zsw151515/Automotive-telemetry-equipment/hardware/wired_tire_central/README.md

2026-10-24 六口离线增量：7B套件＋六接口底板，四胎温C3＋双前刹车第五C3；三页触屏、独立蜂鸣/设置/BLE。实现与验证范围见 docs/12_四路有线胎温离线软件交付说明.md，接口见 docs/13_六接口中控板间与刹车接口.md。未实物验证，原v3/MAX31856/独立刹车固件不变。

# 四路有线胎温中控硬件

状态：设计验证阶段，当前有离线软件、长方形外壳试装模型及验证记录；电子部分未提供制造文件，没有已验证原理图、PCB、BOM 或 Gerber。

当前结构：微雪 7B 完整显示套件＋六接口采集底板，同一外壳。四接口接胎温，另两接口接前刹车盘温度；刹车采集/报警/BLE 并入底板，保留蜂鸣，触屏替代小屏与设置键。工程基线为四胎温 C3＋第五双路刹车 C3、六路 RS485 和支路保护，刹车两总线独立；具体引脚、供电和器件尚未核准。详见 `docs/superpowers/specs/2026-10-24-six-port-tire-brake-7b-design.md`。胎温前轮约 2 m、后轮约 4.5 m，刹车线束待确认；随点火自动工作和关闭。

不能用未核准的 -1 引脚、默认辅助字段或 PanelConfig 生成接线施工图。notes 下记录工具链、引脚/面板选型状态以及各硬件关卡，不把未执行事项写成通过。

本次计划为 `docs/superpowers/plans/2026-10-24-six-port-tire-brake-central.md`，目前仅计划/资料审查；关键引脚和依赖证据见 `notes/7b_source_audit.md`。默认SPI32/33与屏冲突；排除绑带34/36及VO4域46–48后只有12脚，13信号方案必须另核准相关电气条件。

最终定版前取得：胎温协议/帧率、两前刹车协议和独立线路、单轮/四轮胎温及刹车 BLE、五设备共存、后台报警、设置回执与掉电保存、板间 SPI、实际触屏及电源预算证据。屏幕背板、套件 P4/C6 和五个 C3 的维护/天线、USB防反灌及六支路保护均纳入审查。原四口测试不代表上述集成验证已完成。

首版工程样机可以提前设计、试制和装配，无须等所有探头和整机测试完成。底板打样前仍须完成相应电气、引脚、器件和接口定义审查；当前13信号方案尚未闭合，不把预布局当可下单终版。外壳可先按官方图纸做可修改的结构样件，实板到货后复核装配。具体顺序见 [先做中控工程样机](notes/prototype_sequence.md)。

长方形试装外壳已建立参数化模型、STL及装配预览，默认190×125×60 mm；底板和连接器采用明确标注的空间占位，尚未实板试装。打印数量、参数及后续复核见 [外壳试装模型](enclosure/README.md)。

六接口底板交付格式已选嘉立创EDA专业版；官方技能、API Gateway及CLI/MCP的接入核对见 [EDA自动化工具记录](notes/eda_tooling.md)。当前仅完成桥接准备，尚未连通EDA客户端或生成原理图/PCB。
