zsw151515/Automotive-telemetry-equipment/docs/superpowers/plans/2026-10-24-six-port-baseboard-hardware.md

# 六接口底板工程样机实施计划

> **For agentic workers:** 使用 superpowers:executing-plans，保留用户选择的原生执行；独立研究及最后审查可委派只读代理。步骤以核对项追踪。

**Goal:** 交付可继续编辑的嘉立创EDA专业版底板工程、选型与引脚表、可复核原理图和PCB布局，完成相应范围审查后准备少量样板资料。

**Architecture:** 四胎温C3＋双刹车S3，六独立RS485；7B只持有显示与触屏。READY选择器和三态缓冲解决P4信号预算及复位隔离；电源、支路和射频单独核查。

**Tech Stack:** 嘉立创EDA 3.2.149官方API Gateway、本机Node/Python；原厂数据手册、原生工程/网表/规则检查。

**Spec:** `docs/superpowers/specs/2026-10-24-six-port-baseboard-hardware-design.md`。

## Global Constraints

- 不改旧固件、RaceChrono轮位/UUID/数据布局；硬件引脚从未核准的-1记录为本次设计候选。
- 不覆盖其他EDA工程，不修改安装文件或跳过扩展权限；每次写入校验工程UUID及文档类型。
- 所有实物关卡保持未执行，制造与下单前完成对应电气/封装审查；不替用户下单或付款。

## Review Focus

- 复位、单桥重启、USB维护和慢掉电时的三态、DE/ARM及反灌。
- 模块引脚号与实际封装焊盘一一对应，含重复地焊盘和NC。
- P4启动/JTAG/电压域，READY切换延迟与DMA就绪语义。
- 12V正负瞬态、支路短路、屏幕启动及密闭温升。
- RF全铜层禁布、连接器外形及原理图/PCB网表一致性。

### Task 1：选型和引脚

- [x] 原厂资料与器件库交叉核对，保存来源和真实UUID/封装；创建 `hardware/wired_tire_central/baseboard/parts.json`、`pinmap.csv`、`README.md`。初版选型；具体未闭合封装项见审查记录。
- [x] 记录模块GPIO、模块焊盘、7B排针、硬件默认电平及旧-1到候选分配。
- [x] 校核电源预算、保护设置与器件限值，未闭合项写入审查记录，不能标已放行。

### Task 2：原理图

- [x] 在独立工程按控制器、板间链路、六RS485、电源分图；以读回引脚坐标接线。
- [x] 导出原生工程、完整图纸及网表到 `hardware/wired_tire_central/baseboard/eda/`、`exports/`。12页初版；标注整理仍在进行。
- [x] 对网表做独立连接断言，并执行真实原理图检查，记录尚未完成的功能和错误。282器件/1036已定义引脚网络通过，固件适配及实物验收未执行。

### Task 3：PCB与审查

- [x] 从同板原理图导入PCB，设置轮廓、安装孔、四层和天线规则，按器件外形安排布局；导出布局预览和尺寸证据。282器件、1170焊盘读回核对；闭合板框及铜区经导出和重开验证。
- [x] 建立主供电骨架、地线扇出和首轮信号布线检查点；保留已布关键铜线，更新后盖与连接器坐标投影。原生文件2796个走线片段；真实DRC仍有234项连接提示，未放行制造。
- [x] 补充3V3分配、探头供电、九处地线及部分电源控制线；当前原生文件3550段走线/577个板上过孔，真实DRC降至82项连接提示。三处新增焊盘过孔的填孔/铜盖要求已记录；USB及剩余主保护网络仍未闭合。
- [x] 局部调整C52、VS旁路及Kelvin支线，补齐主保护控制并恢复受影响信号；补S3热焊盘接地。当前3775段走线/600个板上过孔，真实DRC为49项连接提示；保护基线的三条替换已明确留证。
- [x] 重新布置左侧四个小元件，完成U31六引脚扇出及逻辑供电/地焊盘过孔；实际3912段走线/616个板上过孔，DRC降至31项连接提示，3V3/GND已无连接错误。受影响信号恢复和保护基线修订3/4已留证。
- [x] 调整R3/R5并恢复受影响SPI线路；实际3975段走线/623个板上过孔，保存重开DRC降至27项连接提示。3V3/GND/SPI无连接错误，修订5记录母线局部缩颈，仍未放行制造。
- [x] 补齐D2/D3/C54钳位支路及FR探头输出，实际3990段API走线/647个板上过孔；DRC只剩五组USB差分对的20项连接提示。保护基线修订6记录原母线拆分，未制造放行。
- [x] 左前USB增加33Ω串联电阻与DNP调试电容预留，局部源端和接地已布通；286器件/1178焊盘，旧铜线保留，该RC检查点22项USB连接提示。
- [ ] 电源/射频关键网络按原厂指引布置；未完成布线时不得输出为可投板版。
- [ ] 审查网络、间隙、供电/反灌、支路故障、实板接口；导出真实DRC与开放事项。
- [ ] 仅对已满足相应制造前置条件的版本准备少量样板包；数量、工艺、报价及最终订单交用户确认，实物验收另记。

- [x] 左前完整USB顶层差分对写入原生PCB；J11原地旋转180°且针脚定义不变，八个受影响信号网络恢复，重建参考地与保存重开DRC通过。实际4217段API线、668个板孔，剩余四组USB共16项连接提示。其他四路RC/USB、制造阻抗和实测仍待完成。

- [x] 右前USB增加33Ω串阻及DNP电容，R84局部重排并恢复HOST_MOSI/FR_ARM/FR_POWER_EN；原生290器件/1186焊盘、4242线/670板孔。保存重开18项提示均为剩余四组USB；新增两项来自DNP焊盘，右前完整差分尚未完成。

- [x] 右前完整USB顶层差分对完成；J12移至底面(71,68,180°)，针脚定义保持，旧EN/BOOT末端清理并恢复八组普通信号。实际4362段API线、680板孔，保存重开仅余RL/RR/BRAKE六网12项提示。未制造放行。

- [x] 左后33Ω串阻/DNP电容与完整USB顶层差分完成；J13移至底面(105.25,68,180°)，恢复八组普通信号并清理旧MOSI/EN/BOOT支路。294器件/1194焊盘、4496段API线/687板孔；保存重开仅RR/BRAKE四USB网8项连接提示。Inner1地参考覆盖已核；制造阻抗与实测未放行。
