zsw151515/Automotive-telemetry-equipment/hardware/wired_tire_central/baseboard/review.md

# V0.1 设计与审查状态

最后更新：2026-10-27。此文件以已取得的证据记录阶段，不以API返回成功替代电气和实物检查。原理图、布局、布线、制造放行分别记录。

| 阶段 | 当前状态 | 证据/限制 |
|---|---|---|
| 官方工具连接 | 已完成 | 用户启用Run API Gateway；显式指定已拥有的连接会话，独立工程读写与导出已验证 |
| 器件选型/GPIO候选 | 已建立 | `parts.json`、`pinmap.csv`、`power-design.md`；实物未核准 |
| 实际符号引脚 | 已读回 | 294个器件、1152个符号引脚，逐一核对模型中用到的引脚；完整证据见导出目录 |
| 原理图连接 | 初版已核对 | 12页、294器件、1060个已定义引脚网络与实际网表一致；严格检查接口返回空错误列表。图纸标注仍需整理 |
| PCB布局 | 初版已建立 | 关联导入294器件；四层、150×75mm闭合板框、4安装孔和RF规则；读回1194实体焊盘网络及位置与模型一致 |
| 原生文件保存 | 已核对 | `.epro2`与`.epro`均有294器件、一个闭合板框、两个地铜区；保存后重开PCB，两个铜区及填充仍在 |
| PCB布线/DRC | 部分完成 | 4496个API走线片段、687个板孔及12模块孔。左前/右前/左后USB闭合；右后/刹车四个USB网络共8项连接提示，无其他类别 |
| 前轮检查点独立复核 | 59c861b已通过 | 见`exports/local-checkpoint-review.md`；仅覆盖49项连接提示时的局部调整 |
| 上一供电检查点独立复核 | 已通过 | 见`exports/supply-checkpoint-review.md`；31项连接提示，未制造放行 |
| 外壳装配 | 投影已更新，实物未验证 | 六探头及电源孔位已关联实际PCB；增加试装窗口后盖，5个STL均通过闭合检查。未收到7B及探头 |
| 少量样板 | 未放行 | 先完成布线、封装、电源和制造检查；尚未下单付款 |

## 已在连接前修正的审查项

1. TI SN74LVC125A数据表未给出所需Ioff保证，本地缓冲改为Nexperia 74LVC125APW,118；不能按相似料名混用厂家。
2. 单侧供电缓冲加跨域上拉仍可能反灌，板间接口改为双电源AXC8+AXC4；P4_3V3_REF与底板3V3分开，CS两侧各归本域，/OE由底板3V3 PG开漏使能。
3. S3故障输入避开GPIO18的启动高毛刺，使用GPIO1/pad39与GPIO2/pad38；C3 RX10串1k，DE7与ARM20采用默认关断。
4. SS54库符号1=A、2=K，修正D3负压钳位和D4蜂鸣反向二极管的极性。
5. LM74900的SLEEP_OV接VS采用切断；补VS和A的100nF去耦；RTN裸焊盘保持悬空。
6. CSD17578Q5A库额外的pad9为漏极散热焊盘，接5V_SCREEN；LMR33630和TPS热焊盘接GND。
7. TPS MCU控制支路增加4.7k串阻；RO串1k；120Ω终端及390Ω偏置初始DNP。
8. A4标题栏预留；网络名与元件引脚文字分开，避免双重标签重叠。
9. 六个Micro-Fit 430450427的四个电气孔和两个定位孔按原厂图修正为1.02mm，保持本工程封装UUID、器件关联和焊盘网络。
10. S3库内12个过孔原无地网络，且不满足当前孔径规则；保持原分块散热焊盘和孔位，修正为GND、0.30mm孔/0.50mm外径。未放宽规则来隐藏错误。
11. 降压芯片旋转使SW朝向电感，BOOT、VCC、输入陶瓷及输出电容优先布置；主保护器去耦和HGATE dv/dt支路移至本地。普通信号尚未布通。
12. 板框改为真正的闭合折线对象；真实DSN和布线几何已成功导出。四条普通走线放在板框层不足以证明存在可导出的轮廓。
13. 主电源骨架、采样Kelvin支线、12V母线、5V屏幕支路及3V3内层母线已布置；七个供电网络的最大线宽单独设为4mm。原理图和PCB规则一致，其余制造规则保持原值。
14. 信号候选先按真实焊盘、原有铜线、过孔、孔边和RF区筛查，再写入PCB；7处自动缩颈低于0.127mm的候选改为0.128mm并复核。已有458条电源/地走线和277个板上过孔经原生文件对比保留。
15. 底面连接器采用局部Y取反的变换，已用26个实体焊盘坐标独立验证。定位孔模型及后盖投影同步修正；FL_DE_CMD在输入定位孔附近的两段逻辑线改为0.128mm并外移0.025mm，真实间距检查通过。
16. 补充3V3分配、六路探头供电的部分走线、九处局部地线和部分电源控制网络；新增754段走线/65个板上过孔。未连接提示由234项降至82项，原有关键铜线基线仍通过检查。不能据此宣称六路供电均已闭合。
17. 检查中发现U1原理图Unique ID变为gge283，而PCB仍为gge1；仅恢复对应标识，保留器件属性及引脚连接。导出完整网表与前一检查点结构完全一致，网表不一致提示消失；该变化的触发来源未确认。
18. R17.1、R32.1、U25.7采用新增0.30/0.60mm焊盘过孔；坐标及实际对象ID见`exports/power-routing-check.json`。制造审查必须落实塞孔和铜盖要求，未按普通盖油工艺放行。
19. C52上移0.8mm，替换三段局部电源走线并恢复READY_FL和FL_TX两段信号；主保护栅极、采样、限流及相关供电连接已补齐。旧基线中455条线和277个板过孔保留；三条旧线的原始几何及12条替换线、4个新增过孔明确记录于`protected-copper-revision.json`，当前保护基线为467条线/281个板过孔。
20. R124.1至R119.1采用独立Kelvin支线；C55.1新增焊盘过孔需要填孔/铜盖审查。S3三个热焊盘跨接经编辑器分成六段，地连接提示随之减少。当前共49项连接提示，后续密集供电/地线试验未应用。
21. R120移至(6.9,50.25)、R121至(4,50.25)、R123至(3,53.25)、C56至(6,53.4)，保持型号、值、旋转和引脚映射。U31六引脚完整扇出，相关供电、UVLO/UV_SW/OVLO、栅极及定时网络全部恢复；两处电压检测连接提示消失。替换范围与保护基线变化见修订3。
22. R29.1、R31.1、U13.14、R35.2、C23.2增加五个填孔/铜盖焊盘过孔；四条受影响线路已完整恢复。3V3母线两处地孔分别采用双0.8mm支路绕行，其他段3mm。编辑器自动清理被覆盖的旧母线段，并替换旧RL_TX段`3c01f7c51d3b6708`及新RL_TX片段ID；旧段铜几何保留，全部实际铜线并集与计划差异小于0.001mm²。保护基线修订4明确留证，当前31项连接提示，无其他DRC类别。

阶段检查证据见 `exports/netlist-check.json`、`pcb-connectivity-check.json`、`native-integrity-check.json` 和 `pcb-drc-summary.json`。这些文件各有明确检查范围，不合并称为整板通过。

## 制造放行前必须闭合

- 所有PCB焊盘网名与最终原理图一致，NC/浮置裸焊盘处理正确，未连接飞线清零；实际ERC/DRC及人工审查结果留存。
- 精确库封装对原厂封装图复核，含模块重复地焊盘、MOS散热焊盘、Micro-Fit定位柱/焊盘及对接端子；目录料名和3D模型不能替代尺寸证明。
- 双电源接口不同上电顺序与棕断波形、DE/ARM默认低及共享MISO三态；P4 GPIO2–5保持默认USB JTAG配置，不切换为pad JTAG。
- 主保护过流/浪涌能量、100V MOS SOA、负压钳位对降压器−0.3V限值的裕量，以及电容DC偏压降容尚需完整校核。TVS通用系列数据不能替代实际采购厂家数据。
- 两路降压的热点、最短高频环路、Kelvin采样、开关节点净空、屏幕启动负载和密闭温升。整机温度等级不能按单个H4X模块105°C定义。
- 天线全铜层与金属背板净空，四C3、S3与7B无线模块共存；实板RF性能尚未验证。
- 7B实际板卡修订、P1/P3正反视图、供电USB口与PC VBUS的路径；专用屏幕电源线束和六路探头适配线定义。
- 新接口位置对应外壳后盖；不把旧φ3导孔或屏幕官方尺寸当成实际装配通过。
- 完成剩余两组RC预留及USB差分对；当前8项连接提示尚未清零。制造阻抗、负载温升、接口和车辆实测尚待验证。
- 为S3及降压散热过孔定义锡膏、盖油与填孔工艺。盖油不能等同填孔；不能在未确定工艺时把过孔在焊盘内的版本作为普通板直接下单。
- 继续整理MOS重复引脚网络标注、显示接口页及TVS附近文字，检查完整PDF的可读性。

## 硬件到货后的验证顺序

先限流电源检查12V→保护母线→5V/3V3，空载确认所有探头支路关闭与DE低；逐支路加入假负载和短路，检查自动重试、温升及故障输入。随后分别启动屏幕/底板、重置单MCU、慢降压并测反灌。最后接真实探头检查完整热图、六路并行读取、蜂鸣报警、五路BLE与RaceChrono记录。车载瞬态和振动测试在台架正常后开展。

本阶段未修改旧固件和任何RaceChrono帧定义，也未启用Approved硬件profile。S3移植、READY选择及ARM的实际启动顺序另行开发；不能直接套用现有C3二进制。

## SPI检查点（2026-10-26）

R3、R5局部调整及全部受影响信号恢复已写入原生PCB。保存重开DRC由31降至27项，均为连接提示；12组剩余网络为12V_PROTECTED、FR_VPROBE及五组USB差分对。未更改元件值、GPIO、网表或DRC规则。R4.2新增焊盘过孔及R5.1既有过孔必须填孔/铜盖；新2mm母线缩颈尚待层叠、负载和温升核对。

原生编辑器将2mm母线连接段的中心自动对齐至Y62.3mm，实际几何已重新通过0.16mm铜间距检查，MISO过孔至该段铜边的名义间距约0.25mm。旧CS_FL和HOST_MOSI片段ID在编辑器清理中变化，铜几何通过全网逐层并集复核。详细证据见`exports/spi-checkpoint-check.json`；当前阶段尚未进行新的独立整板审查，不能投板。

`.epro2`中有一个约0.0016mm的HOST_MOSI极短片段，API读取为空，`.epro`不计入；两格式分别3976/3975条线。现代原生文件与API走线铜几何的最大逐层逐网并集差为0.000003321mm²，低于0.001mm²容差。此差异已在报告中保留，不以手工改写原生压缩包消除计数。

## 钳位与FR输出检查点（2026-10-26）

12V_PROTECTED与FR_VPROBE连接提示已消除，保存重开后只剩十个USB网络、20项连接提示，无其他DRC类别。钳位支路新增22个0.30/0.60mm过孔及三条1.5/1.5/2mm内层支路；FR输出新增U26.7焊盘过孔及一个转换过孔，采用0.3/0.4/0.6mm路径宽度。焊盘过孔均要求填孔和铜盖。并联孔数不代表已取得脉冲电流额定值，仍须核对瞬态路径、厂商层叠和温升。

此次只增加铜线，旧12V母线在三个T形连接处被编辑器拆分成四段，原铜几何保留；修订6记录替换对象。全网逐层铜几何并集最大差0.000020638mm²，低于0.001mm²检查容差。`.epro`/API共3990条线，`.epro2`共3991条，仍包含上一检查点记录的极短MOSA片段，已重新核对铜几何。当前检查点尚未进行新的独立整板审查，未制造放行。

## USB预留初步检查点（2026-10-26）

仅左前路加入R134/R135串联33Ω、C76/C77预留10pF并默认不装；串联路径的实际网表检查已从失败变为通过，原理图ERC为空。增量导入只增加四件并拆分U1.26/27的USB源端网络，原有器件坐标、GPIO和全部既有铜线保持一致。两段局部源端线和电容接地已完成，该RC检查点整组USB仍未闭合。当时22项连接提示均为USB，多出的两项来自新增电容信号焊盘，并非已完成供电/SPI断开。完整差分路径、调谐参数与制造阻抗均未验证。

四个新器件的BOM标记已同时在原理图和PCB核对：电阻装配，电容不装。预留选型及旧/新源端网络名见`usb-design.md`；其余四路RC预留仍待完成。当前阶段不进行新的独立整板放行判断。

## 2026-10-26 左前USB完整路径检查点

J11原地旋转180°，针脚编号、GPIO及原理图网表未变。左前USB两条顶层路径各约82.66465mm，主干采用0.16mm线宽/0.16mm间距，未使用USB信号换层孔；实际重建Inner1地覆盖完整差分主干。精确移除18条普通信号线、2个普通过孔后恢复八个受影响网络，FR限流及两条短SPI输出扇出保留。625条受保护线和324个受保护板孔未改变。U26.3新增焊盘过孔必须填孔/铜盖。

保存重开后16项提示只属于FR/RL/RR/BRAKE的八个USB网络；独立铜几何比较、实际新增铜的间距与孔距检查通过。`.epro2`多出的两个极短同网片段已量化，未手工改写原生档。90Ω阻抗、维护线束、USB枚举、SPI时序及车辆实测尚未验证；不能制造放行。详见`exports/usb-fl-route-check.json`。

## 2026-10-26 右前USB RC及局部布局检查点

新增R136/R137（33Ω装配）及C78/C79（10pF C0G默认不装），U2.26/27拆分为FR_USB_DM_MCU/FR_USB_DP_MCU；GPIO及J12针脚定义保持。R84由(62.25,66,90°)移至(64,62.25,0°)，释放源端引出位置。精确替换12条普通信号线，HOST_MOSI、FR_ARM和FR_POWER_EN全部恢复，未移除旧过孔或受保护铜。新增37段线、2个地孔；两段USB局部源端各约1.51248mm，不代表完整差分匹配。

保存重开18项提示仅来自FR/RL/RR/BRAKE八个USB网络；较上一检查点多两处DNP信号焊盘。原理图及PCB逐件、原生保存、机械变换和FL/FR RC网表核对通过，现有FL差分主干保留。保护基线修订8为627条线/326个板孔。当前阶段尚无独立整板放行结论；详见`exports/usb-fr-rc-check.json`。

## 2026-10-27 右前完整USB及维护排针近端布局

J12由底面(54,40.5,0°)改到(71,68,180°)，所有针脚编号和网络保持；其他器件保持。右前完整USB两线各约16.566mm，采用顶层0.16mm线宽/间隙且无USB信号过孔，重建Inner1地覆盖0.48mm耦合主干。DP源端在非耦合区补长，CAD长度差小于0.001mm，不能作为制造精度或90Ω证明。

精确替换24条普通线、无旧过孔；其中清理旧排针EN/BOOT的Bottom末端分支，保留MCU/上拉/滤波局部连接和源端过孔。八个受影响信号恢复，新增复位/启动接线约21.26/8.22mm。155次铜操作中两段共线DP被编辑器合并，实际新增144线/10孔，旧保护铜627线/326板孔保持。实际新增铜间距/孔距/RF检查及全铜并集比较通过。保存重开DRC只剩其余三组USB的12项连接提示；原理图、GPIO及RaceChrono均未修改。

原生档、网表、布局、读回及外壳源布局哈希已同步；详见`exports/usb-fr-route-check.json`。仅设计检查点，阻抗、维护线束、USB枚举、SPI时序及车辆实测尚待验证。

## 左后USB检查点（2026-10-27）

新增33Ω串阻R138/R139与10pF C0G DNP预留C80/C81；U3.26/27仅拆分USB源端网络名，GPIO及RaceChrono不变。J13移至底面(105.25,68,180°)，旧EN/BOOT远端支路已清理，八组受影响普通信号已恢复。左后顶层差分主干0.16/0.16mm，无USB信号孔，实际板上铜长约16.824mm。

P4_MOSI两端网采用Top/Inner2的59.568mm路径、3个普通过孔，旧铜全删以避免残支。重建后四段走线的Inner1参考地投影均无异网反焊盘缺口；正常自身转层孔与J3.5自身通孔另处理。保护基线修订9只追加两组DNP电容地回路，旧627线/326板孔保持。详见`exports/usb-rl-route-check.json`；制造阻抗与SPI/USB实测尚未完成。
