zsw151515/Automotive-telemetry-equipment/hardware/wired_tire_central/baseboard/usb-design.md

# 维护USB接口设计与当前实施范围

2026-10-26：五个MCU各自保留独立的USB维护排针，用于烧录和调试；不提供USB VBUS输入，维护时仍由外部12V供电。未更改任何固件、BLE或RaceChrono数据定义。

乐鑫的[C3原理图指南](https://docs.espressif.com/projects/esp-hardware-design-guidelines/en/latest/esp32c3/schematic-checklist.html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)与[S3原理图指南](https://docs.espressif.com/projects/esp-hardware-design-guidelines/en/latest/esp32s3/schematic-checklist.html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)均建议USB引脚附近预留串联电阻（初值22/33Ω）和不装的对地调试电容。当前采用33Ω串联预留；10pF C0G是所选DNP器件资料中的名义值，不是已验证的调谐值，不得据此直接装配电容。

| 轮位/控制器 | MCU/维护排针 | 串联电阻 | DNP电容 | 当前状态 |
|---|---|---|---|---|
| 左前FL | U1/J11 | R134、R135，33Ω，C23140 | C76、C77，10pF C0G，C1634 | 原理图和PCB已加入；完整顶层差分对已连接，制造阻抗/实测待验证 |
| 右前FR | U2/J12 | R136、R137，33Ω | C78、C79，10pF DNP | 完整差分路径已连接；J12近端布局，实际铜长约16.57mm，制造阻抗未验证 |
| 左后RL | U3/J13 | R138、R139，33Ω | C80、C81，10pF C0G DNP | 完整顶层差分路径已连接；J13近端布局，实际铜长约16.824mm，制造阻抗未验证 |
| 右后RR | U4/J14 | R140、R141 | C82、C83 | 仅预留位号，未加入原生工程，邻近器件布局须调整或重新选封装 |
| 刹车BRAKE | U5/J15 | R142、R143 | C84、C85 | 仅预留位号，未加入原生工程 |

`usb-interfaces.json`定义目标引脚和位号，不表示所有五路都已实现。当前阶段验证命令为：`python check-usb-interface.py --group FL --group FR --group RL`；不传分组选项会要求五路全部实现，当前不会通过。

## 左前实施定义

| 对象 | 原网络 | 当前网络/连接 | GPIO/管脚是否改变 |
|---|---|---|---|
| U1模块26脚，GPIO18 | FL_USB_DM | FL_USB_DM_MCU → R134.1，R134.2 → FL_USB_DM | 否 |
| U1模块27脚，GPIO19 | FL_USB_DP | FL_USB_DP_MCU → R135.1，R135.2 → FL_USB_DP | 否 |
| J11.1 / J11.2 | FL_USB_DM / FL_USB_DP | 保持原排针端网络；分别接电阻输出及C76.1/C77.1 | 否 |
| J11.3/4/5/6 | GND / FL_EN / GND / FL_BOOT | 保持 | 否 |
| C76.2 / C77.2 | 新增 | GND，局部0.25mm引出及0.30/0.60mm地孔 | 新增DNP预留 |

新增器件均在顶层：R134(28,65.4,0°)、R135(28,67,0°)、C76(30.5,64.5,270°)、C77(30.5,67.4,90°)。坐标单位mm。电容在原理图和PCB的加入BOM标记均为否，保留实体焊盘。

两段0.16mm局部MCU至电阻引出线长约1.51248mm和1.51244mm；该数值只描述局部引出，不能代替完整USB差分对的长度匹配。该RC预留检查点曾有22项USB连接提示；后续完整路径已连接，该完整FL路径检查点保存重开的DRC为其余四组USB的16项连接提示，无其他类别。

## 后续布线与制造前检查

按乐鑫[USB布线指南](https://docs.espressif.com/projects/esp-hardware-design-guidelines/en/latest/esp32c3/pcb-layout-design.html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)，完整路径应成对、平行、等长，并具备连续参考地；目标差分阻抗90Ω±10%。优先顶层，参考相邻内层地。不得通过分别自动布通D+/D-就宣称差分布线完成。

板厂[JLCPCB层叠表](https://jlcpcb.com/impedance)中的JLC04161H-3313为当前核对候选：1.6mm四层、外层35µm、内层15.2µm、外层至地介质约0.09940mm。最终制造层叠、阻抗线宽/间距及验收方式尚未确定；0.16mm局部引出不构成已实现90Ω的证明。

完成完整路径后，还须核对：真实铜长度和间距、参考地连续性、必要的换层回流孔、封装钢网开窗、维护线束及USB枚举/烧录实测。当前不能投板。

## 左前完整路径与排针朝向

J11保持中心(25,40.5)mm，原地由0°转为180°；1～6脚的原网络定义不变，但实体方位发生变化。

| 针脚 | 网络 | 原X坐标mm | 现X坐标mm |
|---|---|---:|---:|
| 1 | FL_USB_DM | 20 | 30 |
| 2 | FL_USB_DP | 22 | 28 |
| 3 | GND | 24 | 26 |
| 4 | FL_EN | 26 | 24 |
| 5 | GND | 28 | 22 |
| 6 | FL_BOOT | 30 | 20 |

两条实际板上铜线长度（包含MCU至串联电阻的引出段，不计封装内部和电阻体）均约82.66465mm；CAD计算差小于0.001mm，不表示制造精度达到该值。主干线宽/边缘间距为0.16/0.16mm，顶层连续布线，无USB信号过孔。原生重建Inner1地覆盖差分主干，排针末端保留通孔所需避空及邻近GND针脚。

为恢复原有故障网络，U26.3新增(39.92512,36.8)mm焊盘过孔，孔/盘0.30/0.60mm，必须填孔并铜盖电镀填平。其他受影响网络已恢复；仍需实测USB枚举、烧录和SPI通信。该07d8211检查点只完成FL一路，另外四路未完成，90Ω制造阻抗尚未确认。

## 右前RC实施范围（ef3a1b8历史检查点）

R136(62,65.4,0°)、R137(62,67,0°)、C78(64.5,64.5,270°)、C79(64.5,67.4,90°)位于顶层。U2.26(GPIO18)→FR_USB_DM_MCU→R136.1，R136.2接FR_USB_DM/J12.1/C78.1；U2.27(GPIO19)→FR_USB_DP_MCU→R137.1，R137.2接FR_USB_DP/J12.2/C79.1；C78.2/C79.2接GND。J12的3/4/5/6脚仍为GND/FR_EN/GND/FR_BOOT。

R84原(62.25,66,90°)改为(64,62.25,0°)，电气连接不变。仅局部MCU至串阻、两处电容地回路和三组受影响信号已布通；右前完整差分对仍待完成。该RC检查点18项连接提示的增量来自两个新DNP信号焊盘；已完成的左前路径保持。其余RC待实施组为RL/RR/BRAKE。

## 右前完整路径与排针新位置

为缩短USB并减少电源区域交叉，J12由底面(54,40.5,0°)改到(71,68,180°)。下表为PCB坐标（mm），安装及维护线束仍按针脚号核对。

| 针脚 | 网络 | 原X/Y | 现X/Y |
|---|---|---|---|
| 1 | FR_USB_DM | 49 / 40.5 | 76 / 68 |
| 2 | FR_USB_DP | 51 / 40.5 | 74 / 68 |
| 3 | GND | 53 / 40.5 | 72 / 68 |
| 4 | FR_EN | 55 / 40.5 | 70 / 68 |
| 5 | GND | 57 / 40.5 | 68 / 68 |
| 6 | FR_BOOT | 59 / 40.5 | 66 / 68 |

R84及四个RC器件保持ef3a1b8的位置与电气定义。DM/DP实际铜长均约16.566mm，包含MCU到33Ω串阻的引出段，不计电阻或模块内部。差分主干顶层0.16mm线宽、0.16mm边隙，无USB换层孔；DP在源端非耦合区补长。重建Inner1地覆盖整个耦合主干，排针末端保留通孔避空及地针。

旧J12的EN/BOOT末端Bottom分支已清理；本地上拉、滤波和MCU源端连接保持，新增复位/启动接线分别约21.26/8.22mm。该a732f31检查点完成FL/FR两路，RL/RR/BRAKE的RC及完整差分尚待实施；当时保存重开DRC为12项USB连接提示。90Ω制造阻抗和实物USB测试尚未确认。

## 左后完整路径与当前状态

R138(96,65.4,0°)、R139(96,67,0°)、C80(98.36,64.45,270°)、C81(98.75,67.4,90°)均在顶层。U3.26(GPIO18)→RL_USB_DM_MCU→R138.1，R138.2接RL_USB_DM/J13.1/C80.1；U3.27(GPIO19)→RL_USB_DP_MCU→R139.1，R139.2接RL_USB_DP/J13.2/C81.1；两电容2脚接GND，均DNP且排除BOM、保留PCB。

J13从底面(88,44,0°)移到(105.25,68,180°)。针脚网络保持，实际安装须按下表针脚号核对，坐标单位mm。

| 针脚 | 网络 | 原X/Y | 现X/Y |
|---|---|---|---|
| 1 | RL_USB_DM | 83 / 44 | 110.25 / 68 |
| 2 | RL_USB_DP | 85 / 44 | 108.25 / 68 |
| 3 | GND | 87 / 44 | 106.25 / 68 |
| 4 | RL_EN | 89 / 44 | 104.25 / 68 |
| 5 | GND | 91 / 44 | 102.25 / 68 |
| 6 | RL_BOOT | 93 / 44 | 100.25 / 68 |

DM/DP实际铜长分别约16.824195/16.824193mm，含MCU到电阻的铜线、不计模块与电阻内部。CAD长度差约0.000002mm仅为数值结果，不能作为制造精度。耦合主干顶层0.16mm线宽、0.16mm边隙，无USB信号过孔；重铺Inner1地后完整0.48mm耦合包络未覆盖面积0mm²。新增电容地孔为普通外置孔；本阶段没有增加焊盘内过孔。

旧J13远端EN/BOOT支路已清理，本地上拉和滤波保持。启动与复位使用短Inner2段；P4_MOSI采用约59.568mm的Top/Inner2路径和3个普通过孔，旧MOSI铜全删，避免无负载残支。该路径四段参考地投影均无异网孔缺口，正常自身转层孔和J3.5自身通孔除外；Top及Inner2使用同一Inner1 GND参考。其余SPI时钟保持外层。保留全部既有电源/地保护铜，未改DRC规则、GPIO、固件或RaceChrono数据。

当前FL/FR/RL三路RC及完整USB路径完成；RR/BRAKE两路待实施。保存重开DRC仅有四个剩余USB网各2项连接提示，共8项，无其他类别。制造阻抗、USB枚举/烧录及SPI时序仍需实物验证，尚未制造放行。
