zsw151515/Automotive-telemetry-equipment/hardware/wired_tire_central/notes/prototype_sequence.md

# 先做完整中控工程样机的制作顺序

2026-10-24：用户希望优先制作微雪7B触屏＋六接口底板＋同一外壳，探头到货后再做真实测温验证。当前7B尚未到货，真实探头验证也未开始。现有离线软件与原通信架构保持不变。

任务按实际依赖推进，不必按原任务编号排队。真实探头未到不阻塞全部电路、结构和样机工作；首版工程样机与最终定版分别管理。

## 现在可以做

- 按微雪官方原理图和3D图纸，开展整机空间安排、屏幕固定、底板轮廓、六插口位置、维护接口及线束空间的结构初稿。
- 开展六口底板原理图、器件/连接器选型、电源预算和PCB预布局；检查五个C3的维护与天线净空、蜂鸣器及探头支路保护。
- 外壳可先做可修改的3D打印结构样件。建议保留可拆后盖和可更换接口面板，减少板卡版本、连接器及底板修改引起的整壳返工；这属于工程建议，最终结构待安装位置及尺寸确认。

用户随后将测试版明确简化为长方形外壳，只需容纳7B及六接口底板。现已建立 [参数化样壳、STL和预览](../enclosure/README.md)，默认190×125×60 mm，后盖兼作可更换的接口定位板；底板150×75 mm及孔距是暂定空间预算，未表示真实PCB已经设计。先打印试装件，收到7B后核对孔位/高度/间隙，再结合底板与连接器选型修改。暂不依赖车型或仪表台曲面。

官方资料：[相关资料与3D图纸入口](https://docs.waveshare.net/ESP32-P4-WIFI6-Touch-LCD-7B/Resources-And-Documents/)。图纸可以用于初稿，不能替代收到实板后的孔位、接口高度及装配间隙复核。

## 7B到货后，先推进中控样机

1. 核对板号、芯片修订、外形/孔位及接口方向；用正确的原板供电和厂商显示/触摸例程确认屏幕基本工作。
2. 关闭对应的基本电气问题：P4的13根板间信号、绑带与VO4域、第五C3的双UART/USB/DE上电状态、12V保护与各输出电源、连接器供电及针脚定义。
3. 对满足基本电气/引脚审查的版本制作少量可返修PCB样板，标注“工程样机／未完成探头与实车验证”；完成与屏幕、六个接口、蜂鸣器和外壳的装配。
4. 配合最小实板调试固件，用受控负载、模拟串口数据或总线测试设备验证供电、通信、切页、报警控制及装配。模拟数据必须标明，不能记为真实测温通过。

现有0.2离线固件默认禁用硬件I/O；并非已验证的直接上板固件。不能为点亮界面就把未核准profile设为通过。必要的屏幕、触摸、电源及总线调试不能全部推迟到探头到货后。

## 首版底板打样前仍必须确认

- 13信号方案有可执行且安全的引脚分配。当前排除绑带34/36及VO4域46–48后只剩12个普通候选GPIO，不能直接把现有预算当接线表。
- 第五C3模块有足够且安全的GPIO，原生USB18/19与双UART不冲突，RS485 DE由硬件保证上电关闭。
- 电源、电平、器件封装及六个连接器的针脚/供电定义已核对，原理图完成对应范围的审查。

这些是避免电气错误的前置条件，与“真实探头、手机、实车测试全部完成”不同。未闭合的引脚方案可以继续做设计和预布局，不能直接输出为已核准的制造版。

## 探头到货后补齐最终验证

真实协议/量程/热图方向与帧率、六探头实际负载、故障恢复、端到端延迟、目标手机五BLE/RaceChrono、完整线束以及汽车供电/振动/温升等验收仍需实物。完成这些后再冻结最终PCB、BOM、外壳和量产制造文件；此前不能宣称整机已实车验证。

本说明最初只澄清工作顺序；后续新增的外壳试装STL不代表底板电气审查完成。仍未生成EDA、BOM或Gerber，不开启硬件profile，也不改动或重新包装已验证的离线软件包。
