zsw151515/Automotive-telemetry-equipment/hardware/wired_tire_central/baseboard/exports/usb-rl-route-review.md

# 左后完整USB检查点独立复核

2026-10-27：Critical 0、Important 0、未解决Minor 0。可保存此设计检查点，尚未制造放行。

- 对a732f31原生快照：新增R138/R139/C80/C81；旧件仅J13移动。原有焊盘仅J13位置及U3.26/27源端网名变化，GPIO保持。
- 当前294器件、1194实体焊盘、1060逻辑引脚、1152符号引脚与原生、网表、布局及读回一致。DRC规则、层叠和地铜区定义保持。
- 精确新增182线/11孔，移除48线/4孔。旧MOSI的16线/1孔全部移除，无无负载支路。
- 新增及移位铜最小异网边距0.15999968mm，符合0.16mm名义间距和数值容差；新孔最小孔边距0.475864mm，无新增焊盘内孔。J13通孔与顶层器件占位亦无冲突。
- 完整USB 0.48mm耦合包络在真实Inner1 GND内，缺口0mm²。MOSI四段、54个原生线片段按真实自身反焊盘轮廓排除正常转层及J3.5自身孔后，缺口均0mm²；未排除异网孔。
- 原627条保护线/326个板上保护孔保持；修订9只增加两组DNP电容地回路。现代原生与API全铜并集最大差约0.000003321mm²，两历史同网极短片段仍保留。
- 原生SHA与报告相符。保存重开仅余RR/BRAKE四个USB网各2项连接提示，共8项；已完成的FL/FR/RL闭合。
- README层用途总述已修正。五个外壳STL重渲染后几何与前版一致，保留原字节；投影布局SHA及check-only已核对。实物装配尚未验证。

制造90Ω阻抗、USB枚举/烧录、SPI时序、汽车电源瞬态和实物测试仍待完成。未修改固件或RaceChrono数据定义。
