zsw151515/Automotive-telemetry-equipment/hardware/wired_tire_central/baseboard/exports/usb-fr-route-review.md

# 右前完整USB检查点独立审查

2026-10-27，基于ef3a1b8后本检查点，只读独立审查结果：Critical 0、Important 0、未解决Minor 0。仅覆盖本次设计检查点，不构成制造放行。

- SCH、符号、封装及全部电气网络保持；PCB仅J12搬移、其相关文字属性变化。新增144线/10孔，移除24线，保留的旧线/孔字段原样。保护基线修订8逐字节不变。
- 290器件、1186实体焊盘、1052逻辑引脚与layout/CSV/readback/原生PAD_NET/enet一致，原生全部焊盘独立变换无位置差异；R84与RC器件保持。
- FL/FR各USB源端和总线及八个恢复网均单连通。FR DM/DP约16.566111/16.566109mm，顶层、无USB信号过孔。
- 实际新增铜及J12焊盘的异网铜间距通过，最小约0.16mm；新增过孔最小孔边距约0.468mm。底面体、顶面穿孔、安装孔、NPTH与RF均无冲突。
- 由原生活动Inner1覆铜弧线独立重建，完整0.48mm耦合包络未覆盖面积0；J12两地针接入地平面。新控制孔距USB铜中心满足0.68mm约束。
- epro/epro2铜并集最大差约0.000003321mm²，历史两条微小同网片段的解释准确。保存重开仅RL/RR/BRAKE六个USB网各2项连接提示。
- 原生SHA、全部导出报告、case源布局哈希及五个STL哈希一致；文档明确区分历史RC与当前完整FR路径。

审查未修改文件、Git或EDA，未运行写报告脚本。制造阻抗、USB枚举、SPI时序及实物验证仍待完成。
