zsw151515/Automotive-telemetry-equipment/hardware/wired_tire_central/baseboard/exports/usb-fl-route-review.md

# 左前USB布线检查点独立审查

2026-10-26，只读审查；基于eb1a2d4后本检查点。Critical 0、Important 0、待修Minor 0。仅评估本检查点，不构成投板批准。

- 原生286件、实体1178焊盘；epro4217条线，epro2含两个已说明的微小同网片段共4219条线；668板过孔及12模块孔。哈希与usb-fl-route-check.json一致。
- 唯一器件旋转为J11的0°→180°；引脚网络未变。布局、排针针脚、底面外形与CSV一致。
- 原计划18条普通线及2个信号过孔替换，加上编辑器自动替换的一条HOST_SCK线；实际与候选铜几何并集在0.001mm²容差内。625条保护线及324个受保护板过孔保持。
- USB走顶层，无信号过孔；DM/DP总铜长约82.66465mm。直接由当前原生Inner1活动覆铜重建，0.48mm耦合主干包络未覆盖面积为0。
- 新增21个过孔符合候选。USB间距分别注明孔中心距离及铜边距离；U26.3的填孔铜盖要求明确。
- 保存重开仅有FR/RL/RR/BRAKE八个USB网络共16项连接提示。90Ω制造阻抗、USB枚举和汽车电源实测仍未验证。
- 重复--group的覆盖误报已修复；外壳五件STL三角形几何集合未变，源布局哈希同步。

审查中三处说明/报告Minor均已修正并复核，无待处理项。
