zsw151515/Automotive-telemetry-equipment/hardware/wired_tire_central/baseboard/exports/power-checkpoint-review.md

# 2026-10-25 电源支路检查点（08aaf0e）

本记录对应82项连接提示的历史检查点。当前原生文件及检查结果见`local-rework-check.json`和`pcb-drc-summary.json`。

本轮由实施者运行并核对实际导出文件：网表282器件/1036引脚、PCB1170焊盘及位置、两种原生归档、26个连接器焊盘和7个连接器包络检查通过，外壳5个STL的既有检查记录仍匹配。保存重开后，原生DRC为28组、82项连接提示，未报告其他类别；原理图检查为空错误列表。

原生文件保存3550个走线片段、577个板上过孔及12个模块过孔。较a7005c3新增754段铜线和65个过孔，9批写入共819个操作与增量一致。458段既有电源/地线和277个板上过孔通过基线比较。新增R17.1、R32.1、U25.7焊盘过孔的坐标、对象ID及填孔/铜盖要求见`power-routing-check.json`。

已发起独立只读复核，但代理因账户使用额度限制终止，未返回有效审查结论。因此本记录仅证明实施者检查和原生软件检查结果，**不构成独立审查通过或制造放行**。提交当前功能分支用于保存可回退的工程检查点；后续仍须补完独立审查。

剩余工作包括USB、主保护栅极/采样及局部电源引出、钳位器件供电回路、地连接、丝印/图纸整理、工艺与电气审查。离线局部重布线试验未写入当前交付归档。7B、探头和整机台架尚未验证；本轮未修改固件或RaceChrono数据格式。
