zsw151515/Automotive-telemetry-equipment/hardware/wired_tire_central/baseboard/exports/checkpoint-review.md

# 2026-10-25 首轮信号检查点复核（a7005c3）

本记录对应前一检查点。后续电源支路布线的实际状态见`power-routing-check.json`和`pcb-drc-summary.json`，本记录的234项数量不能代替当前DRC。

独立只读审查覆盖本轮未提交修改、两种原生归档、保护铜线基线、焊盘及连接器投影、五个STL和检查记录。未发现阻止保存本阶段检查点的Critical或Important问题。

复核确认2796个走线片段、512个板上过孔及12个模块散热孔；458条既有走线、277个板上过孔保留。26个连接器焊盘坐标最大误差约1.56×10⁻⁶mm，后盖投影与STL一致。

发现一个Minor：原机械检查只验证焊盘，未验证后盖采用的`bounds_mm`。已增加7个连接器包络及26焊盘数量断言；正常数据通过，在任务临时副本中恢复J5旧错误包络时按预期失败。未修改真实布局来制造测试错误。

结论只支持保存部分布线及样壳同步检查点。真实DRC仍有37组、合计234项未连接提示；剩余电源、USB、信号、图纸标注和制造工艺均未放行。电源热设计、车载故障/瞬态、RF、7B和接插件实物装配、固件及RaceChrono台架验收不在本次完成声明内。
