zsw151515/Automotive-telemetry-equipment/CODEX.md

2026-10-24 六口离线增量：7B套件＋六接口底板，四胎温C3＋双前刹车第五C3；三页触屏、独立蜂鸣/设置/BLE。实现与验证范围见 docs/12_四路有线胎温离线软件交付说明.md，接口见 docs/13_六接口中控板间与刹车接口.md。未实物验证，原v3/MAX31856/独立刹车固件不变。

# CODEX.md

本文件用于告诉 Codex / ChatGPT：本仓库是什么项目、硬件背景是什么、哪些地方不能乱改、修改代码时必须遵守什么规则。

在本仓库工作时，请优先阅读：

1. `README.md`
2. `CODEX.md`
3. `AGENTS.md`
4. `docs/01_项目背景.md`
5. `docs/02_硬件版本说明.md`
6. `docs/05_已知硬件问题与排查记录.md`
7. `docs/08_12V_RS485刹车节点说明.md`
8. `docs/09_胎温高度v3_RaceChrono_BLE_ONLY说明.md`

## 1. 项目一句话说明

这是一个用于赛道场景的汽车遥测设备项目，包括：

- 胎温监测
- 悬挂高度 / 离地距离监测
- 刹车盘温度监测
- 卡钳温度监测
- RaceChrono Pro BLE 数据记录
- RS485 / 显示 / 报警
- 面向真实客户交付的硬件和固件稳定化

本项目优先级是：**可靠、稳定、可交付，而不是功能复杂。**

## 2. 当前项目主线

当前主线只有两个：

```text
1. 胎温高度节点板 v3 RaceChrono BLE only
2. brake_temp_alarm_display_12V_RS485
```

刹车节点目前一共有三个版本，必须严格区分：

```text
1. brake_temp_12v_max31856
   - MAX31856 + K 型热电偶
   - 测卡钳温度
   - 当前未接入报警显示
   - 独立采集 / 测试版本

2. brake_temp_12v_rs485
   - RS485 红外测温传感器
   - 测刹车盘温度
   - 不带显示报警
   - 是 brake_temp_alarm_display_12V_RS485 之前的初代版本
   - 不作为当前重点推进对象

3. brake_temp_alarm_display_12V_RS485
   - RS485 红外测温传感器
   - 测刹车盘温度
   - 带显示、ALM 报警阈值、按键、蜂鸣器、RaceChrono BLE
   - 当前刹车节点板重点推进版本
```

历史参考：

```text
胎温高度节点板 v2：历史测试板，仅作参考
```

### 独立设计方向的版本边界

四路有线胎温中控的设计规格位于 `docs/superpowers/specs/2026-10-22-wired-tire-thermal-central-design.md`，书面规格和实施计划 `docs/superpowers/plans/2026-10-22-wired-tire-thermal-central.md` 已获认可，用户选择原生执行并要求先完成离线软件；尚无新硬件实测结论。目标为四个成品 RS485 探头、一块定制中控 PCB、同板 7 英寸屏、四个独立采集/BLE 单元和点火控制供电；本地显示完整热图，RaceChrono 保留各轮 8 分区输出。

上述单板结构及随后的 7B 四接口结构为历史基线。2026-10-24 用户最新选择为 **微雪 7B 显示套件＋六接口底板，同一外壳**，四胎温＋两前刹车探头，刹车采集/报警/BLE 并入底板，触屏替代 OLED/设置按键，保留蜂鸣。新说明为 `docs/superpowers/specs/2026-10-24-six-port-tire-brake-7b-design.md`，其中第五 C3、双刹车独立 RS485、13 GPIO SPI 及设置命令为待审阅工程基线。当前代码仍未实现六口或 7B 硬件兼容，不能据此接线或投板。

用户核对7B中文说明书后要求继续，增量计划位于 `docs/superpowers/plans/2026-10-24-six-port-tire-brake-central.md`，待审阅后按已选原生方式执行。官方资料审查见 `hardware/wired_tire_central/notes/7b_source_audit.md`：默认P4 SPI脚与背光/复位冲突，13信号需额外核准绑带或VO4域脚，禁止按“17 GPIO”直接接线。

离线代码分别位于 `firmware/wired_tire_channel`、`firmware/wired_tire_display`，共享库为 `firmware/libraries/WiredTireCore`。安装、构建、打包说明见 `docs/12_四路有线胎温离线软件交付说明.md`；不得把默认禁用 I/O 的离线编译、合成热图或协议测试当作实物验证，也不得据此冻结 PCB。核准硬件 profile 必须来自真实接线、面板资料和验证记录。

该方向独立于胎温高度 v3，也不是刹车报警板的简单换探头版本。不得将其写成已验证主线，不得因此改动旧 v3 的 BLE only 边界或恢复旧 v3 中控发送。胎温继续使用 RejsaRubberTrac，不使用 DIY CAN PID；新增刹车子系统沿用 N BrakeTemp DIY CAN 的 0x100–0x107。不能混用两种 BLE 布局，也不能把旧四路离线测试升级为五 BLE/六探头通过。正式投板前增加双刹车报警、触屏设置回执/持久化及五 BLE 共存验证。

## 3. 代码修改总原则

Codex 修改本仓库代码时，必须遵守以下原则：

1. 优先保证已有功能不坏。
2. 不要随意重构已经稳定运行的 BLE / 传感器 / 电源控制逻辑。
3. 不要随意改引脚定义。
4. 不要删除硬件排查有用的串口日志。
5. 不要为了代码“简洁”删掉失败重试、传感器检查、保护逻辑。
6. 不要把稳定代码改成复杂架构。
7. 修改 `.ino` 文件时，用户偏好是提供**完整终版代码**，而不是零散补丁。
8. 每次修改必须说明：改了什么、为什么改、保留了什么、需要怎样测试。
9. 以后只要涉及 BLE DIY CAN 自定义通道固件改动，必须在最终回复和对应 `.md` 文档中写明 PID / CAN ID、字节布局、单位、缩放倍率和 RaceChrono 计算公式。胎温高度 v3 的 RejsaRubberTrac 风格 BLE 热图不是 DIY CAN，不要混用 PID 规则。

## 4. 胎温高度节点 v3 当前软件定位

胎温高度节点 v3 是当前重要的量产候选版本。

当前 v3 软件主线已经改为：

```text
RaceChrono / RejsaRubberTrac compatible BLE only
```

也就是说：

```text
MLX90640 胎温 + VL53L1X 高度
        ↓
本地清洗 / 滤波 / ROI / 分区
        ↓
BLE RejsaRubberTrac 风格数据包
        ↓
RaceChrono Pro 记录和显示
```

不再使用：

```text
ESP-NOW -> 中控发送胎温
WiFi -> 中控
UDP/TCP -> RaceChrono
Central display link
```

Codex 修改胎温高度 v3 时，必须优先保证：

1. RaceChrono 能稳定搜索、连接、记录。
2. 胎温热力分布要跟手。
3. 温度不能有很夸张的抖动。
4. MLX90640 错误恢复和 FAST/STABLE 回退逻辑不能删除。
5. 不要为了中控显示或 ESP-NOW 功能牺牲 BLE 质量。

当前参考固件：

```text
tire_temp_height_node_racechrono_fast_clean_v3.ino
```

## 5. 胎温高度节点 v3 硬件和引脚

主要器件：

- ESP32-C3 模块 / 板
- MLX90640 红外阵列温度传感器
- VL53L1X 距离传感器
- LTC2954 单按键电源控制
- ME6211C33M5G-N 3.3V LDO
- TP4057 锂电池充电
- Type-C 接口
- USBLC6-2SC6 USB ESD

已验证的重要硬件结论：

- `LTC2954CTS8-1#TRPBF` 不适合当前最终电源保持逻辑。
- 后续 v3 / v3.1 应固定使用 `LTC2954CTS8-2#TRPBF`。
- `R_BTN_PULL` 应删除或 DNP。
- `PWR_KILL -> SYS_3V3` 需要增加 47kΩ 上拉。
- 上述组合已通过电池供电连续约 30 次开机测试，未再出现偶发开机失败。

典型 v3 固件引脚：

```cpp
const int SDA_PIN          = 8;
const int SCL_PIN          = 10;
const int VBAT_ADC_PIN     = 1;
const int LED_STAT_PIN     = 2;
const int BTN_PIN          = 3;
const int PWR_KILL_PIN     = 4;
const int PWR_INT_PIN      = 5;
const int VL53_XSHUT_PIN   = 6;
const int VL53_INT_PIN     = 7;
```

除非用户明确要求，不要改变这些引脚。

## 6. 胎温高度节点 v3 BLE / 温度处理规则

当前满意固件使用 RejsaRubberTrac 风格 BLE：

```text
Device name: RejsaRubberRL123456
Service UUID: 0x1FF7
Characteristic 1: 0x0001
Characteristic 2: 0x0002
Characteristic 3: 0x0003
```

不要随意改 BLE 设备名、Service、Characteristic 和数据包布局。

当前满意固件的温度处理思路：

```text
有效范围剔除
trimmed mean 分区均值
ROI 自动跟踪
rate limit 限制变化速度
adaptive low-pass 自适应低通
spike gate 抑制离谱跳变
stale 温度保护
```

不要随意删除这些逻辑。它们是“热力分布跟手”和“温度不过度抖动”的平衡点。

当前满意固件优先 FAST profile：

```text
1MHz I2C
MLX90640 32Hz
17bit ADC
约 34ms frame interval
```

若总线不稳，应自动回退 STABLE profile：

```text
400kHz I2C
MLX90640 16Hz
18bit ADC
约 70ms frame interval
```

不要删除 recover / fallback 逻辑。

## 7. brake_temp_12v_max31856 版本规则

`brake_temp_12v_max31856` 是独立版本，不是 RS485 报警显示版本。

定位：

```text
MAX31856 + K 型热电偶
测量目标：卡钳温度
当前状态：还没有接入报警显示
```

Codex 修改此版本时必须遵守：

1. 不要把它当成 `brake_temp_12v_rs485` 或 `brake_temp_alarm_display_12V_RS485`。
2. 不要把卡钳温度误写成刹车盘温度。
3. 保留 MAX31856 fault 读取和日志。
4. 保留热电偶断线 / fault / NaN / 异常值判断。
5. 当前未接入报警显示，除非用户明确要求，不要擅自加入报警显示架构。
6. 不要把异常读数显示或发送为正常 `0°C`。

## 8. brake_temp_12v_rs485 初代版本规则

`brake_temp_12v_rs485` 是不带显示报警的初代 RS485 红外刹车盘测温版本。

定位：

```text
RS485 红外测温传感器
测量目标：刹车盘温度
不带显示报警
不是当前重点推进对象
```

Codex 修改此版本时必须遵守：

1. 不要把它当成当前重点版本。
2. 不要擅自加入 OLED / TFT 报警显示、按键、蜂鸣器逻辑。
3. 不要把它和 `brake_temp_alarm_display_12V_RS485` 混成一个版本。
4. 不要加入 MAX31856 热电偶采集逻辑。
5. RS485 读取失败、CRC 错误、温度无效不能显示或发送为正常 `0°C`。

## 9. brake_temp_alarm_display_12V_RS485 版本规则

`brake_temp_alarm_display_12V_RS485` 是当前刹车节点板重点推进版本。

定位：

```text
RS485 红外测温传感器
测量目标：刹车盘温度
功能：显示 + ALM 报警阈值 + 按键 + 蜂鸣器 + RaceChrono BLE 数据发送
```

当前使用的 RS485 红外测温传感器为固定式红外测温仪，采用 Modbus RTU 通信，默认地址 0x01，默认 9600 波特率。温度读取使用功能码 0x03，寄存器地址 0x0000，返回值除以 10 为摄氏度。

Codex 修改此版本时必须遵守：

1. 不要把它当成 `brake_temp_12v_max31856` 或初代 `brake_temp_12v_rs485`。
2. 不要把刹车盘温度误写成卡钳温度。
3. 不要加入 MAX31856 热电偶采集逻辑，除非用户明确要求一体化。
4. 必须保留 RS485 Modbus RTU 读取逻辑。
5. 必须保留 OLED / TFT 显示和 ALM 报警阈值逻辑。
6. 必须保留按键和蜂鸣器报警逻辑。
7. 必须支持 RaceChrono BLE 数据发送，除非用户明确要求移除。
8. RS485 读取、OLED 刷新、按键扫描、蜂鸣器任务不能阻塞 BLE。
9. 不要把 RS485 读取失败、CRC 错误、温度无效显示或发送为正常 `0°C`。
10. 修改后必须说明 RaceChrono 是否可搜索、可连接、发送哪些通道。
11. 如果修改 BLE DIY CAN 发送、filter、PID、数据缩放、无效值或通道定义，必须列出每个 PID 的 payload 字节含义和 RaceChrono 计算公式，并同步更新 `docs/04_RaceChrono_BLE说明.md`、`docs/08_12V_RS485刹车节点说明.md` 和对应固件 README；不要把胎温高度 v3 的 RejsaRubberTrac BLE 热图写成 DIY CAN PID。
12. 当前 V1.6 报警语义是“系统温度确认”：`ALARM` 必须由 `Tcore` 达到或接近 `ALM` 确认，不要把瞬时盘面尖峰或单独 `Dose` 改成可直接强制 `ALARM`。
13. 修改后必须说明蜂鸣器逻辑，尤其是 SET 长按静音后再次超温是否会响。

## 10. 胎温高度节点 v2 背景

v2 是历史测试板，重点用于参考：

- MLX90640 胎温
- VL53L1X 高度
- BLE RaceChrono
- 早期 ESP-NOW 到中控
- TFT 中控显示 ACK 控制

v2 仅作为历史参考，不是当前主线。

## 11. 已知硬件坑

### 11.1 Type-C 母座动态接触问题

曾出现一块 v3 新贴片板 Windows 提示“无法识别 USB 设备”。最终通过重新贴焊 Type-C 母座解决。

结论：**Type-C 母座即使万用表静态导通正常，也可能存在动态接触或焊接质量问题。**

### 11.2 I2C 串联电阻误焊

I2C 串联电阻位置如果误焊为 10kΩ，会导致传感器无法通信。

正确方向：

- I2C 串联电阻通常应为 0Ω / 22Ω / 47Ω 级别
- 不应是 10kΩ
- I2C 上拉才是 4.7kΩ / 10kΩ 级别

## 12. 给 Codex 的工作方式

当用户要求修改代码时，应按以下格式回复：

1. 先确认修改目标和具体版本。
2. 说明涉及的文件。
3. 给出完整终版代码。
4. 说明关键改动。
5. 给出烧录和测试步骤。
6. 给出异常排查建议。

不要说“我稍后完成”。必须在当前回复中完成尽可能多的工作。

## 13. 严禁事项

以下操作除非用户明确要求，否则不要做：

- 删除 RaceChrono BLE 代码
- 修改 BLE 设备名规则
- 修改轮位 ID 规则
- 修改 v3 电源控制引脚
- 删除传感器初始化失败日志
- 删除 I2C 扫描 / 诊断日志
- 把所有故障读数强行显示或发送为 0
- 把胎温高度 v3 改回向中控发送胎温数据
- 给胎温高度 v3 重新加入 ESP-NOW 胎温链路、中控胎温链路、WiFi / UDP / TCP 胎温主链路
- 删除胎温滤波、ROI 跟踪、spike gate、rate limit、FAST/STABLE fallback 逻辑
- 把 `brake_temp_alarm_display_12V_RS485` 改成不支持 RaceChrono 的纯显示版本
- 把不带显示报警的 `brake_temp_12v_rs485` 当成当前重点版本
- 把 `brake_temp_12v_rs485` 和 `brake_temp_alarm_display_12V_RS485` 混成同一个版本
- 把 MAX31856 热电偶卡钳测温逻辑混入 RS485 红外刹车盘版本
- 大规模重构稳定代码
- 引入复杂第三方库导致 Arduino 编译风险增加

## 14. 自动化检查工具

本仓库提供以下本地检查工具：

```powershell
python scripts/check_docs_consistency.py
python scripts/check_pdf_metadata.py
powershell -NoProfile -ExecutionPolicy Bypass -File scripts/compile_arduino.ps1 -Sketch firmware/brake_temp_alarm_display_12v_rs485/hyundai_n_brake_temp_alarm_display_12V_RS485.ino -Fqbn esp32:esp32:esp32c3
```

Codex 修改代码或文档后应按影响范围运行：

1. 修改文档、版本边界、RaceChrono 规则后，运行 `check_docs_consistency.py`。
2. 修改硬件 PDF、原理图文件名或 PDF 元数据后，运行 `check_pdf_metadata.py`。
3. 修改 `.ino` 固件后，优先运行 `compile_arduino.ps1` 编译目标固件。
4. 如果 Arduino 编译失败，最终回复必须说明失败原因、缺失库或需要用户本地确认的环境。

GitHub Actions 文件：

```text
.github/workflows/project-checks.yml
```

该 workflow 默认在 push / PR 时检查文档一致性和 PDF 元数据；Arduino 编译通过 `workflow_dispatch` 手动触发。
