zsw151515/Automotive-telemetry-equipment/docs/11_四路有线胎温中控接口.md

2026-10-24 六口离线增量：7B套件＋六接口底板，四胎温C3＋双前刹车第五C3；三页触屏、独立蜂鸣/设置/BLE。实现与验证范围见 docs/12_四路有线胎温离线软件交付说明.md，接口见 docs/13_六接口中控板间与刹车接口.md。未实物验证，原v3/MAX31856/独立刹车固件不变。

# 11 四路有线胎温中控接口

状态：离线研发，硬件关卡未通过。本方向独立于无线胎温高度 v3 和刹车报警节点。

2026-10-24 六接口增量设计见 `docs/superpowers/specs/2026-10-24-six-port-tire-brake-7b-design.md`。下文仍是四轮胎温接口；新增双前刹车、BrakeLink 和 N BrakeTemp DIY CAN 不混入胎温 Snapshot v1 或 RejsaRubberTrac。六口整机接口尚未实现。

## 成品探头解析基线

按手册读取地址 0x01、功能码 0x65、起始寄存器 0x0000、785 个寄存器。假设响应寄存器字节数 1570，总帧长 1576，像素位于寄存器 0x0010 至 0x030F，按行排列，32 列、24 行。

寄存器使用大端有符号 16 位计数，温度等于计数除以 10，单位摄氏度；CRC16 低字节在前。原始温度保留，手册范围 -40 至 300°C 之外的像素标记无效。无效状态与 0°C 独立，零温度可以正常有效。

当前仅通过合成帧测试，这些协议参数尚未与实物核对。默认波特率、4/5 Hz、全帧长度、快照一致性等以 validation_probe.md 的真实证据关闭，不能写成已验证。

## 只读采集

运行 scripts/capture_yf90640.py --list-ports 列举串口；用户确认对应端口和参数后，显式提供 --port、--baud、--stopbits、--seconds 和全新的 --output 目录。工具不写配置、不广播、不自动枚举轮询串口。

每条 JSONL 保留原始收发字节和主机单调接收时间。metadata.json 区分 captured 与 error，hardware_validated 始终为 false；“采集成功”不等于“探头正确”。现阶段不连接或操作真实端口。

## 八分区离线算法

每区 4 列、ROI 高 8 行，最少 18 个有效像素，均值每侧裁剪 3 个样本。分区有效域 -20 至 200°C，与探头完整热图的原始范围分开处理。配置镜像/版本变化或超过 1500 ms 的间隔会重新初始化滤波；重复/倒退时间不发布分区结果。

参考代码搜索起始行配置为 3–17，但 24 行中放置 8 行 ROI 的实际最大起始行是 16，沿用其边界裁剪。跟踪速率从逐帧 1 行改为以 34 ms 为参考的按时间限制，低通系数也按实际 dt 换算，避免每秒约四帧输入仍按高速采样节奏处理。

变化率基线 160°C/s，死区 0.06°C，跃变阈值 12°C。原参考代码跃变分支与普通分支使用相同限速；新离线实现保留限速，并将跃变时的参考低通系数上限设为 0.45，再按实际 dt 换算。该保守策略可能改变跟手性，必须通过真实热源实验确认，当前仅有离线测试证据。

## RejsaRubberTrac BLE 编码

设备名格式 RejsaRubber + FL/FR/RL/RR + 蓝牙地址末三字节的六位十六进制后缀；服务 0x1FF7，特征 0x0001、0x0002、0x0003，分别为 20 字节。这是热图协议，不是 DIY CAN，不定义 PID。

每特征 B0=0x02；B4–B19 是八个有符号小端 16 位温度计数，温度°C=计数/10。B1–B3 由 LegacyAuxFields 的相应原始字节提供，原协议中的高度、电量、电压不再作为本系统测量值。

完整热图渲染使用快照中的 mirrored 标志映射源列与有效位，与八分区的左右顺序一致；原始矩阵保持传感器行列顺序。默认 FR/RR 镜像，最终安装方向仍须热源实测确认。

目前未冻结这些辅助字段的生产编码，硬件 profile 必须完成手机实测后显式核准。未核准时不启用 BLE。仅连接就绪、等待启动保护时间、八分区全部有效、轮位正确且数据年龄不超过 1500 ms 时通知；停发不等于手机自动清空最后值，必须实测记录。

发送中旧批次过期时丢弃剩余分包，并允许从最新有效快照重新开始，无需断开连接。UART 请求期限为 400 ms，读 FIFO 前先过期处理；调度提交再次检查期限，超期尾字节不得更新温度或接收时间。新请求前丢弃旧接收缓冲，单次清理有预算；仍有残留则延后重试。

## SPI 快照 v1 字段

响应固定 1728 字节，多字节字段均小端；不发送 C++ 结构体内存。

| 偏移 | 内容 |
| --- | --- |
| 0–3 | WTH1 魔数 |
| 4/5/6/7 | 版本 1 / 轮位 1–4 / 帧状态 / 八分区有效位图 |
| 8–11 / 12–15 | 采集单元启动标识 / 响应接收序号 |
| 16–23 / 24–27 | 从机本地接收时间 us / 准备响应时数据年龄 ms |
| 28–29 / 30 | 载荷长度 1648 / ROI 起始行 3–16 |
| 31 | bit0 镜像、bit1 BLE 已连接、bit2 BLE 已启用，其余位必须为零 |
| 32–35 | 配置版本 |
| 36/40/44/48/52 | 五个 u32 计数：CRC 错、长度错、超时、恢复、丢弃 |
| 56–59 / 60–63 | 请求 token / 保留零 |
| 64–1599 | 768 个 int16 像素温度计数 |
| 1600–1695 | 96 字节逐像素有效位图，低位优先 |
| 1696–1711 | 八个 int16 分区温度计数 |
| 1712–1715 | 前 1712 字节的 IEEE CRC32，低字节在前 |
| 1716–1727 | 零填充 |

帧状态编码 0 未就绪、1 有效、2 部分有效、3 过期、4 通信失败。每次读取只接受匹配轮位和请求 token 的响应；任何校验失败均不替换旧快照。主从不直接相减绝对时钟；接收序号回绕和启动标识变化不会凭空增加测温采样次数。

## SPI 事务与数据年龄

首版实现采用等长 1728 字节全双工事务。主机发送请求：B0=0x52，B1=轮位，B2–B5=小端 token，B6–B7=前六字节的 Modbus CRC16，其余为零；从机返回此前准备的快照。初次旧 token/空响应被丢弃，同一 token 在 100 ms 窗口内继续读取，直到匹配或超时。P4 启动时随机化 token 起点，降低重启后命中旧排队响应的风险。

这种方式避免变长请求/响应阶段的重新同步，代价是额外的事务和带宽。SPI 为 1 MHz mode 0、四路独立片选与就绪信号，异步 DMA，每次 poll 不等待整个传输。单路未就绪不会阻塞其余轮位。发送缓冲通过租约冻结至 DMA 完成；在途不允许重新编码。

屏幕数据总年龄保守取“从机准备时年龄＋请求到响应耗时＋接收后主机经过时间”，向上取整并饱和到 u32；不使用从机绝对时间减主机时间，也不因重读旧矩阵刷新有效期。真实时序和吞吐仍未验证。
