zsw151515/Automotive-telemetry-equipment/hardware/wired_tire_central/notes/final_review_six_port.md

# 六口离线分支最终审查记录

唯一新上下文只读审查范围：31d861a..b9bfa30；结论With fixes，无Critical，4项Important、2项Minor。审阅者没有修改代码或复跑编译。主执行者进行一次RED→GREEN修复，不派二次审查。

4项已修复：退出会话Read重放复活静音；Unknown读回后旧客户端回执覆盖真实终态；遗漏非阻塞启动提示；缺少应用ALM会重置模型/报警提示。复现测试见test_brake_settings/client/buzzer/telemetry_ui；修复后110原生命名测试、15项工具测试全绿，最终软件包的独立解压结果另由交付校验记录给出，打包器不自称已运行验证。

## 保留的轻微问题

- 控制器失联后，静音剩余秒数可能仍显示最后一次值；顶部全局丢失提示保留，实际蜂鸣由C3独立计时，不受影响。
- 刹车页暂未单列最大有效盘温；左右实测盘温已显示，RaceChrono 0x102仍有最大值。

## 执行判断与限制

- 仅完成离线软件；实物五类关卡未关闭，不能据此投板或宣称车上可用。
- 复用现有隔离工作树与固定工具链，未升级全局SDK；换机器需配置编译器/SDK路径。
- C3构建时推进独立P4工作，P4构建时准备独立文档/打包；一次完整审查与独立解压验证重叠。代价是交叉步骤可能漂移，最终源码与解压包全矩阵必须重新通过才能交付。
- 会话历史固定32个退出host、不淘汰，超容量拒绝新控制会话以防重放；代价是同次刹车启动切换超过32次需重启刹车MCU。采集/报警/BLE不受控制会话容量影响。
- 保留计划记录与工作树供未完成实物关卡使用，代价为额外磁盘占用。

审查者搁置的判断均保留：VO4/绑带/C3实际引脚/DE/汽车电源与EMC；真实探头时序/独立串口隔离/NVS停顿与掉电；五BLE/手机公式和无效值；实屏FPS/连续触摸/撕裂/背光电平。这些都需要实物证据，代价是相关可靠性和兼容性未验证。最终编译、测试与解压包矩阵由主执行者独立运行，审查者不重复，保留验证过程独立性限制。

交付验收另复现并修复源码目录嵌套于其他Git仓库时错误继承父提交号的问题：test_copied_source_does_not_inherit_parent_repo_commit RED→GREEN，非自身仓库根的源码标为unversioned。最终源提交和包哈希通过单独交付记录关联。
