zsw151515/Automotive-telemetry-equipment/hardware/wired_tire_central/baseboard/exports/usb-fr-rc-review.md

# 右前USB RC检查点独立复核

2026-10-27，只读复核当前阶段，基于07d8211。Critical 0、Important 0、未解决Minor 0；不构成制造放行。

- 原生两种格式SHA、290器件、1186实体焊盘、1052逻辑引脚、1144符号引脚、布局CSV及报告一致。
- 新增R136/R137为33Ω装配，C78/C79为10pF C0G且DNP排除BOM、保留PCB；U2.26/27源端拆分正确，GPIO及J12针脚定义保持。
- 对前版精确核对：只新增四件、移动R84；37条新增线、12条移除线，其他旧线字段不变；两个新地孔，668个旧板孔及模块内12孔不变。
- 修订8仅加入两条地线、两个地孔，原625条保护线及324个保护板孔保留；现基线627条线/326个板孔，前版SHA一致。
- 左前63条USB铜线对象原样保留，各USB网络保持连通；按真实焊盘及铜几何独立确认HOST_MOSI、FR_ARM、FR_POWER_EN均单连通。
- 右前两组源端闭合，排针/电容/串阻输出仍各为三个端点，符合完整差分未布通范围。DRC记录为八个USB网络共18项连接提示。
- 原生现代格式的4244条线包含两条历史同网微小片段，API/兼容格式为4242。旧计数说明Minor已修正，并重新量化当前铜几何并集差。

复核未修改文件、操作EDA或运行写报告脚本。root另行实时读取并保存重开，确认铜与网络未变；新元件坐标重载最大舍入约0.00000126mm，C78的270°与-90°等价。制造阻抗、USB枚举、SPI时序及车辆实测仍待验证。
