zsw151515/Automotive-telemetry-equipment/hardware/wired_tire_central/baseboard/exports/supply-checkpoint-review.md

# 2026-10-26 供电与控制扇出检查点独立复核

独立只读复核完成，无未解决的Critical、Important或Minor问题，可保存为部分布线检查点。

实际归档3912段线、616个板过孔及12个模块过孔；重开DRC为31项连接提示、14组，无其他类别，3V3/GND无连接错误。四项自带检查通过，原理图网表、GPIO和设计规则未变，仅指定的四个小元件移动。

保护基线修订3、4的对象链及前版SHA均匹配，当前606条线、298个板过孔。新增几何的0.16mm异网间距、0.30mm孔边、RF净空及移动器件外形检查通过，五个新增焊盘过孔真实位于对应焊盘内。两侧Kelvin支路独立接至分流电阻；完整线铜并集最大差约0.000124mm²，小于0.001mm²阈值。

发现一处Minor记录细节：编辑器自动替换了旧RL_TX段及新片段ID。已补充旧段`3c01f7c51d3b6708`的记录，并读回确认；原铜几何保留，无需改变CAD。

本结论不代表整板布线或制造放行。剩余连接、填孔/铜盖工艺、铜厚及负载/温升、实物和固件台架仍须完成。复核者未修改文件、索引或HEAD，未调用EDA。
