zsw151515/Automotive-telemetry-equipment/hardware/wired_tire_central/baseboard/exports/local-checkpoint-review.md

# 2026-10-26 局部主保护与S3接地检查点复核

独立只读复核未发现Critical、Important或Minor问题，可保存为部分布线检查点。

对08aaf0e实际原生归档差异核对：仅删除记录中的5条线，新增230段线及23个板过孔；器件仅C52的Y坐标上移0.8mm。其他原有走线、过孔、网络及规则保持一致。当前原生文件为3775段走线、600个板过孔及12个模块过孔。

保护基线修订与原版本哈希相符，精确保留455条旧线、277个旧板过孔，加入12条替代线、4个新增过孔。247次局部写入操作对应对象均保存；三个S3热焊盘跨接按模块过孔位置分成六段。

真实重开DRC与报告一致：19组、49项连接提示，无其他类别错误。四项检查通过；完整网表未变，GPIO和网络未漂移。根据原生精确孔径进行新增铜线间距、孔边及RF区复核，未发现冲突。实际几何连通性确认R124.1至R119.1为独立Kelvin支线；C55.1新增过孔位于实际焊盘内，填孔/铜盖要求已明确。

此结论只覆盖当前局部调整及检查点资料一致性，整板布线、工艺和电气审查仍未完成，未制造放行。7B/探头实物、温升、瞬态、无线共存和固件台架未在本轮验证。失败的密集区虚拟试验未写入交付归档。复核者未修改文件、索引或HEAD，未调用EDA。
