zsw151515/Automotive-telemetry-equipment/docs/13_六接口中控板间与刹车接口.md

# 六接口中控板间与刹车接口

状态：离线实现，未实物验证。

四胎温依然为原 Snapshot v1 固定1728字节、FL/FR/RL/RR，独立CS/READY；BLE RejsaRubberTrac 0x1FF7、三特征每包20字节，B4–B19为8个小端int16温度计数/10，不属于DIY CAN。刹车是独立第五C3、独立256字节BrakeLink，不能编成WheelId=5。

## BrakeLink v1

请求与响应各固定256字节、全双工流水；首个旧token响应丢弃，与原1728字节胎温从机各有独立CS。全部多字节字段小端，248–251为前248字节IEEE CRC32，252–255零填充，未定义字节必须零。

| 方向/偏移 | 字段 |
| --- | --- |
| 请求0/4/5/6–7 | BRC1 / version1 / op：0 Read、1 ApplySave、2 Mute60 / 保留零 |
| 请求8/12/16/20/24 | u32 token / hostBootId / targetBrakeBootId / commandId / expectedConfigVersion |
| 请求28/30/31/32 | u16 alarmC / u8 warningBeep / 保留零 / u32 muteMs |
| 请求36–247 | 零；Read的命令/候选/静音字段为零，可用targetBoot=0发现节点；变更必须匹配非零目标boot、非零命令ID，Mute只允许60000ms |
| 响应0/4/5/6/7 | BRK1 / version1 / status类型固定1 / BrakeState / flags |
| 响应8/12/16/20/24 | u32 brakeBootId / sequence / token / stateAgeMs / u64 sourceStateUs（仅诊断） |
| 响应32/36/40/42/43 | u32 configVersion / savedVersion / u16 alarmC / warningBeep / 两路validMask |
| 响应44/46/48/50/52/54 | int16 FL/FR/max/fast/core 温度计数 / u16 dose10 |
| 响应56/60/64 | u32 FLageMs / FRageMs / muteRemainingMs |
| 响应68/72/76/80 | u32 CRC/长度/超时/恢复计数 |
| 响应84/85/86–87 | u8 ackResult / ackOp / 保留零 |
| 响应88/92/96/100/104/105 | u32 ackHostBoot / ackCommandId / ackTargetBoot / ackConfigVersion / u8 configOrigin / enabledMask |
| 响应106–247 | 零 |

flags bit0 BLE启用、bit1连接、bit2有效配置、bit3模型有效、bit4配置已保存、bit5配置恢复/需检查，其余零；validMask必须是enabledMask子集。无有效探头时max使用0x7FFF，模型无效时fast/core使用0x7FFF；原始每路可保留最后值但须结合valid/age判读。configOrigin=0默认/1新配置/2旧配置迁移。ackResult=0 None/1 Pending/2 AppliedSaved/3 Muted/4 Invalid/5 StaleBoot/6 VersionConflict/7 IdConflict/8 StorageFailed/9 OutcomeUnknown/10 SessionMismatch/11 Busy。CRC/语义错误不覆盖旧状态，不执行命令。

显示状态有效1000ms，探头有效2500ms；源年龄加请求耗时及本地经过时间（微秒转毫秒向上取整、饱和）。不同MCU绝对时钟不得相减，成功SPI或新token不刷新源数据年龄。

配置先保存确认后生效；存储结果未知时保留原有效配置并阻止新变更，读回可能确认完整旧值或新值，不宣称回滚。重复命令不写Flash、不延长静音；缓存8条外加会话ID高水位。

## 刹车 RaceChrono DIY CAN

设备名 `N BrakeTemp`，Service `0x1FF8`，通知/读特征 `0x0001`，过滤写特征 `0x0002`。每条通知B0–B3为uint32小端CAN ID；以下payload从B4开始，温度/16位量均大端。手机计算的byte索引从CAN payload起算；具体RaceChrono输入语法待手机实测，不能把通知的4字节ID当payload。

|CAN ID/PID|含义|payload|单位/缩放|计算定义|
|---|---|---|---|---|
|0x100|前左实测盘温|B0–B1 signed int16 BE|℃，×0.1|signed16(B0×256+B1)/10|
|0x101|前右实测盘温|同上|同上|同上|
|0x102|有效盘温最大值|同上|同上|同上|
|0x103|Fast表面滤波估算|同上|同上|同上|
|0x104|Core热浸估算|同上|同上|同上|
|0x105|Dose热负荷|B0–B1 uint16 BE|模型量，×0.1|(B0×256+B1)/10|
|0x106|状态|B0 uint8|0 OK/1 WARN/2 ALARM/3 FAIL|B0|
|0x107|ALM阈值|B0–B1 uint16 BE|℃，×1|B0×256+B1|

温度0x7FFF为无效，不能作为3276.7℃记录；负数须做16位符号扩展。一般通知总长6字节，状态5字节。过滤00严格1字节拒绝全部，01至少3字节允许全部（B1–2大端间隔ms），02至少7字节新增PID（B1–2间隔/B3–6 PID，兼容大小端）；12槽去重、满时原子拒绝。最短/零间隔150ms，请求更慢间隔受尊重。非法命令不改变过滤状态。

## 会话重放与启动提示

同一刹车MCU启动内，已退出P4会话的Read不得重新激活它；旧命令不能延长静音。固定保存32个已退出host ID且不淘汰，最多32次会话切换后拒绝另一个新控制会话（SessionMismatch），需要点火/刹车MCU重新启动；采集、模型、蜂鸣和BLE继续。日志会输出会话拒绝。重启后新的brakeBootId继续隔离旧变更目标。该边界是固定内存下的保守拒绝策略。

启动提示为60ms响、80ms间隔、40ms响，非阻塞；在驱动初始化结束后起算，普通提示音关闭时不响。报警前3秒启动保护保留；ALARM在保护期后仍覆盖普通提示音关闭。修改真正不同的ALM后确认保存才重置模型/报警锁存，设置页在应用前显示此后果；仅修改普通提示音不重置模型。
