zsw151515/Automotive-telemetry-equipment/hardware/tire_temp_height_v2/README.md

# 胎温高度节点 v2 硬件（历史测试板）

## 定位

胎温高度节点 v2 仅作为历史测试板和参考资料保留。

当前项目主线不再侧重 v2，后续开发重点是：

1. 胎温高度节点 v3
2. brake_temp_alarm_display_12V_RS485 / 12V RS485 + RaceChrono 刹车温度系统

## v2 保留价值

v2 主要用于参考：

- MLX90640 胎温采集验证
- VL53L1X 高度采集验证
- 早期 RaceChrono BLE 逻辑
- 早期 ESP-NOW 到中控逻辑
- 基础电池供电和 Type-C 烧录经验

## 当前状态

```text
状态：历史测试板 / 参考资料
是否当前主线：否
是否建议继续发售：否
```

## 子目录

```text
schematic/   历史原理图
pcb/         历史 PCB 文件或截图
gerber/      历史 Gerber
bom/         历史 BOM / CPL
3d/          历史 3D STEP 文件
notes/       测试记录和已知问题
```

## 注意事项

- v2 文件不要删除，但不要作为新功能主线继续扩展。
- Codex 修改项目时，不应优先修改 v2，除非用户明确要求。
- v2 可作为历史对照和排查参考。
