zsw151515/Automotive-telemetry-equipment/firmware/tire_temp_height_node_v2/README.md

# 胎温高度节点 v2 固件

## 用途

用于胎温高度节点 v2：

- MLX90640 胎温读取
- VL53L1X 高度读取
- RaceChrono BLE
- ESP-NOW 到中控
- 基础按键 / LED / 电池电压检测

## 状态

```text
当前状态：待上传稳定固件
```

## 注意事项

- v2 是重要稳定参考版本，不要删除。
- 后续 v3 修改时可以参考 v2 已验证的 RaceChrono / ESP-NOW 逻辑。
- 上传 `.ino` 后请在本 README 补充引脚表、依赖库、烧录设置和已知问题。
