zsw151515/Automotive-telemetry-equipment/hardware/wired_tire_central/baseboard/exports/pcb-layout-draft.png

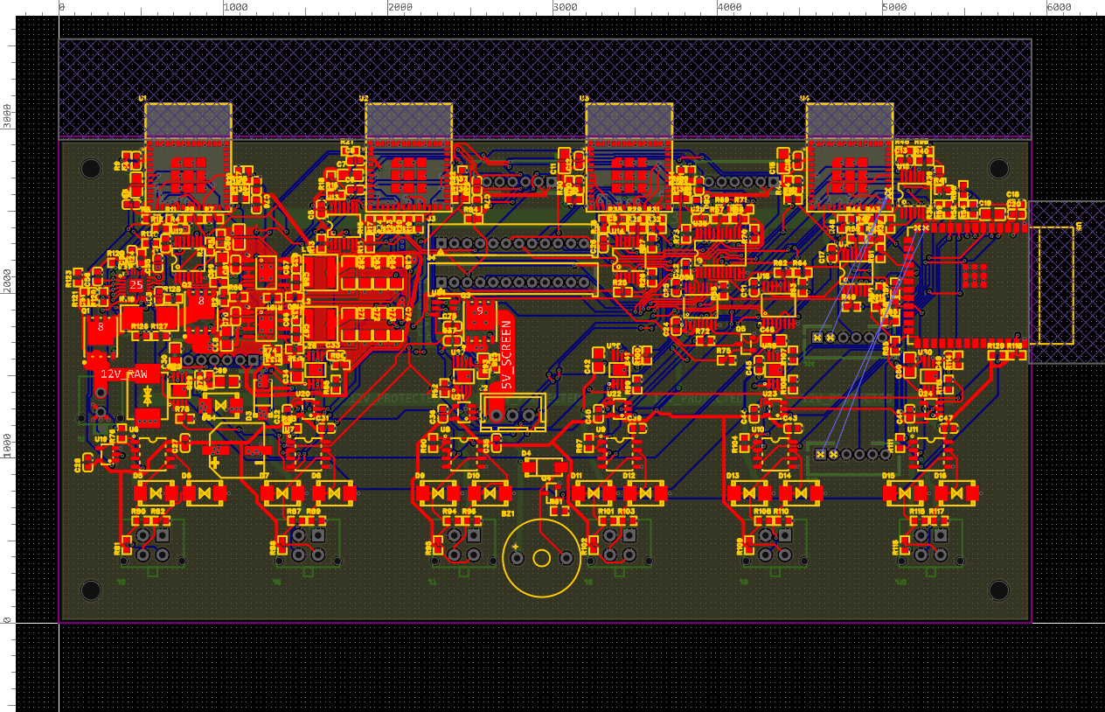
hardware/wired_tire_central/baseboard/exports/pcb-layout-draft.png
