zsw151515/Automotive-telemetry-equipment/hardware/wired_tire_central/previews/preview-0.png

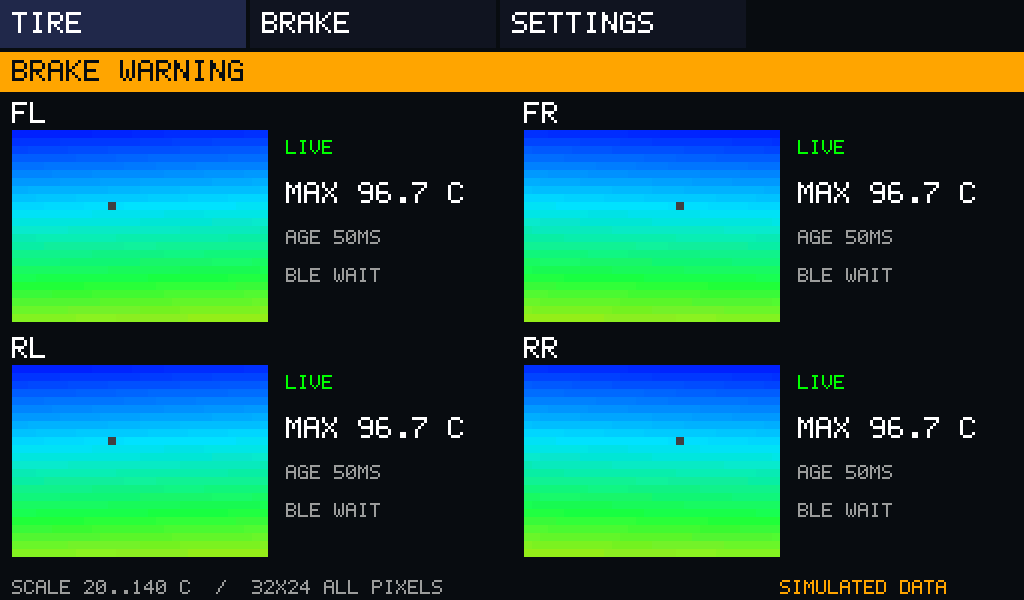
hardware/wired_tire_central/previews/preview-0.png
