zsw151515/Automotive-telemetry-equipment/hardware/brake_temp_alarm_display_12v_rs485/bom/BOM_brakek_temp_alarm_display_12V_RS485_pcb_brake_temp_alarm_display_12V_RS485_2026-05-30.xlsx

No. | Quantity | Comment | Designator | Footprint | Value | Manufacturer Part | Manufacturer | Supplier Part | Supplier
1 | 1 | 2.4kHz | BUZZER1 | BUZ-TH_BD12.0-P7.60-D0.6-FD | 2.4kHz | YS-MBZ12095DYB05 | Fengming(锋鸣电子) | C409831 | LCSC
2 | 4 | 100nF | C_3V3_HF,C_EN,C_IN_HF,C_MCU_1 | C0603 | 100nF | CGA0603X7R104K500JT | HRE(芯声) | C6119867 | LCSC
3 | 2 | 22uF | C_3V3_OUT1,C_3V3_OUT2 | C0805 | 22uF | CL21A226MPQNNNE | SAMSUNG(三星) | C29277 | LCSC
4 | 4 | 100nF | C_BOOT,C_BUCK_IN2,C_RS485,C_SENSOR_2 | C0603 | 100nF | CC0603KRX7R9BB104 | YAGEO(国巨) | C14663 | LCSC
5 | 1 | 10uF | C_BUCK_IN1 | C1206 | 10uF | HGC1206R5106K500NSPJ | Chinocera(华瓷) | C7432781 | LCSC
6 | 1 | 47uF | C_IN_BULK | C1206 | 47uF | C1206B476M025TE | IHHEC(禾伸堂) | C39337422 | LCSC
7 | 3 | 100nF | C_KEY_DN,C_KEY_SET,C_KEY_UP | CAP-SMD_L2.0-W1.25 | 100nF | FCC0805B104K500DT | FOJAN(富捷) | C5137467 | LCSC
8 | 2 | 10uF | C_MCU_2,C_SENSOR_1 | C0603 | 10uF | CL10A106MA8NRNC | SAMSUNG(三星) | C96446 | LCSC
9 | 1 | 1nF | C_SHIELD | C1206 | 1nF | 1206B102K202NT | FH(风华) | C9196 | LCSC
10 | 1 | XL-1608UBC-04 | D_LED_STAT | LED0603-RD_BLUE |  | XL-1608UBC-04 | XINGLIGHT(成兴光) | C965807 | LCSC
11 | 1 | SS54 | D_REV | SMA_L4.3-W2.6-LS5.0-FD |  | SS54 | R+O(宏嘉诚) | C7420369 | LCSC
12 | 1 | SMBJ18A | D_TVS | SMB_L4.5-W3.6-LS5.4-RD |  | SMBJ18A | R+O(宏嘉诚) | C19077573 | LCSC
13 | 1 | BSMD1206-110-24V | F1_CAR | F1206 |  | BSMD1206-110-24V | BHFUSE(佰宏) | C2798026 | LCSC
14 | 1 | BSMD1206-075-30V | F_SENSOR | F1206 |  | BSMD1206-075-30V | BHFUSE(佰宏) | C976305 | LCSC
15 | 10 | HDR-M_2.54_1x1P | GND,TP_CAR_12V,TP_RS485_A,TP_RS485_B,TP_RS485_DE,TP_RS485_RX,TP_RS485_TX,TP_SENSOR_12V,TP_SYS_3V3,TP_VIN_12V_PROT | HDR-TH_1P-V-M_XKB_X4611WV-01I-C28D40 |  |  |  | C81276
16 | 1 | HC-MX3.0-2*1A | J_CAR_PWR | CONN-TH_4P-P3.00_HC-MX3.0-2X1A |  | HC-MX3.0-2*1A | HCTL(华灿天禄) | C3294370 | LCSC
17 | 2 | SH-MX3.0-5PZZ | J_IR_FL,J_IR_FR | CONN-TH_SH-MX3.0-5PZZ |  | SH-MX3.0-5PZZ | SHOU HAN(首韩) | C54563274 | LCSC
18 | 2 | UART调试口 | J_UART_DEBUG,OLED1 | 2.54-1*4p母
19 | 1 | TYPE-C 16PIN 2MD(073) | J_USB | USB-C-SMD_TYPE-C-6PIN-2MD-073 |  | TYPE-C 16PIN 2MD(073) | SHOU HAN(首韩) | C2765186 | LCSC
20 | 3 | TS-1002S-09026C | KEY_DOWN,KEY_SET,KEY_UP | KEY-SMD_4P-L6.0-W6.0-P4.50-LS9.5-BR |  | TS-1002S-09026C | XUNPU(讯普) | C455118 | LCSC
21 | 1 | 4.7uH | L_3V3 | IND-SMD_L4.0-W4.0_FNR40XXS | 4.7uH | FNR4020S4R7MT | cjiang(长江微电) | C167828 | LCSC
22 | 1 | 2N7002 | Q_BUZZ | SOT-23-3_L2.9-W1.3-P1.90-LS2.4-BR |  | 2N7002 | R+O(宏嘉诚) | C7420321 | LCSC
23 | 2 | 680Ω | R_485_A_PU,R_485_B_PD | R0603 | 680Ω | RC0603FR-07680RL | YAGEO(国巨) | C112310 | LCSC
24 | 2 | 10Ω | R_485_A_SER,R_485_B_SER | R0603 | 10Ω | 0603WAF100JT5E | UNI-ROYAL(厚声) | C22859 | LCSC
25 | 1 | 120Ω | R_485_TERM | R0603 | 120Ω | FRC0603F1200TS | FOJAN(富捷) | C2906988 | LCSC
26 | 5 | 10kΩ | R_BOOT,R_EN,R_KEY_DN,R_KEY_SET,R_KEY_UP | R0603 | 10kΩ | FRC0603F1002TS | FOJAN(富捷) | C2906982 | LCSC
27 | 1 | 100Ω | R_BUZZ_GATE | R0603 | 100Ω | RC0603FR-07100RL | YAGEO(国巨) | C105588 | LCSC
28 | 2 | 100kΩ | R_BUZZ_PD,R_EN_BUCK | R0603 | 100kΩ | 0603WAF1003T5E | UNI-ROYAL(厚声) | C25803 | LCSC
29 | 2 | 5.1kΩ | R_CC1,R_CC2 | R0603 | 5.1kΩ | FRC0603F5101TS | FOJAN(富捷) | C2907044 | LCSC
30 | 1 | 2.2kΩ | R_LED_STAT | R0603 | 2.2kΩ | 0603WAF2201T5E | UNI-ROYAL(厚声) | C4190 | LCSC
31 | 1 | 0Ω | R_SHIELD_0R | R0603 | 0Ω | 0603WAF0000T5E | UNI-ROYAL(厚声) | C21189 | LCSC
32 | 2 | 22Ω | R_USB_DM,R_USB_DP | R0603 | 22Ω | 0603WAF220JT5E | UNI-ROYAL(厚声) | C23345 | LCSC
33 | 2 | M3螺丝 | SCREW1,SCREW2 | M3螺丝
34 | 2 | TS-1088-AR02016 | SW_BOOT,SW_RST | SW-SMD_L3.9-W3.0-P4.45 |  | TS-1088-AR02016 | XUNPU(讯普) | C720477 | LCSC
35 | 1 | SM712 | TVS_485 | SOT-23-3_L2.9-W1.3-P1.90-LS2.4-BR |  | SM712 | R+O(宏嘉诚) | C7420375 | LCSC
36 | 1 | AP63203QWU-7 | U_3V3_BUCK | TSOT-26_L2.9-W1.6-P0.95-LS2.8-BL |  | AP63203QWU-7 | DIODES(美台) | C5248536 | LCSC
37 | 1 | USBLC6-2SC6 | U_ESD_USB | SOT-23-6_L2.9-W1.6-P0.95-LS2.8-BL |  | USBLC6-2SC6 | TECH PUBLIC(台舟) | C2827654 | LCSC
38 | 1 | 2.4GHz | U_MCU | WIFI-SMD_L18.0-W14.3_ESP32-C3-WROOM-02U-N4 | 2.4GHz | ESP32-C3-WROOM-02U-N4 | ESPRESSIF(乐鑫) | C2926676 | LCSC
39 | 1 | SP3485EN-L/TR | U_RS485 | SOIC-8_L5.0-W4.0-P1.27-LS6.0-BL |  | SP3485EN-L/TR | MaxLinear(迈凌) | C8963 | LCSC
