zsw151515/Automotive-telemetry-equipment/hardware/wired_tire_central/baseboard/pinmap.csv

位号 | MCU | GPIO | 模块焊盘 | 网络或功能 | 7B排针 | 电平 | 旧状态 | 新状态
U1 | C3 | 0 | 12 | FL_SCK |  | 3.3V | -1/未核准 | 本次设计候选，未启用profile
U1 | C3 | 1 | 13 | FL_MOSI |  | 3.3V | -1/未核准 | 本次设计候选，未启用profile
U1 | C3 | 2 | 5 | FL_STRAP2 |  | 3.3V | -1/未核准 | 本次设计候选，未启用profile
U1 | C3 | 3 | 6 | FL_MISO |  | 3.3V | -1/未核准 | 本次设计候选，未启用profile
U1 | C3 | 4 | 18 | FL_CS |  | 3.3V | -1/未核准 | 本次设计候选，未启用profile
U1 | C3 | 5 | 19 | READY_FL |  | 3.3V | -1/未核准 | 本次设计候选，未启用profile
U1 | C3 | 6 | 20 | FL_TX |  | 3.3V | -1/未核准 | 本次设计候选，未启用profile
U1 | C3 | 7 | 21 | FL_DE_CMD |  | 3.3V | -1/未核准 | 本次设计候选，未启用profile
U1 | C3 | 8 | 22 | FL_STRAP8 |  | 3.3V | -1/未核准 | 本次设计候选，未启用profile
U1 | C3 | 9 | 23 | FL_BOOT |  | 3.3V | -1/未核准 | 本次设计候选，未启用profile
U1 | C3 | 10 | 16 | FL_RX |  | 3.3V | -1/未核准 | 本次设计候选，未启用profile
U1 | C3 | 18 | 26 | FL_USB_DM_MCU |  | 3.3V | -1/未核准 | 本次设计候选，未启用profile
U1 | C3 | 19 | 27 | FL_USB_DP_MCU |  | 3.3V | -1/未核准 | 本次设计候选，未启用profile
U1 | C3 | 20 | 30 | FL_ARM |  | 3.3V | -1/未核准 | 本次设计候选，未启用profile
U2 | C3 | 0 | 12 | FR_SCK |  | 3.3V | -1/未核准 | 本次设计候选，未启用profile
U2 | C3 | 1 | 13 | FR_MOSI |  | 3.3V | -1/未核准 | 本次设计候选，未启用profile
U2 | C3 | 2 | 5 | FR_STRAP2 |  | 3.3V | -1/未核准 | 本次设计候选，未启用profile
U2 | C3 | 3 | 6 | FR_MISO |  | 3.3V | -1/未核准 | 本次设计候选，未启用profile
U2 | C3 | 4 | 18 | FR_CS |  | 3.3V | -1/未核准 | 本次设计候选，未启用profile
U2 | C3 | 5 | 19 | READY_FR |  | 3.3V | -1/未核准 | 本次设计候选，未启用profile
U2 | C3 | 6 | 20 | FR_TX |  | 3.3V | -1/未核准 | 本次设计候选，未启用profile
U2 | C3 | 7 | 21 | FR_DE_CMD |  | 3.3V | -1/未核准 | 本次设计候选，未启用profile
U2 | C3 | 8 | 22 | FR_STRAP8 |  | 3.3V | -1/未核准 | 本次设计候选，未启用profile
U2 | C3 | 9 | 23 | FR_BOOT |  | 3.3V | -1/未核准 | 本次设计候选，未启用profile
U2 | C3 | 10 | 16 | FR_RX |  | 3.3V | -1/未核准 | 本次设计候选，未启用profile
U2 | C3 | 18 | 26 | FR_USB_DM_MCU |  | 3.3V | -1/未核准 | 本次设计候选，未启用profile
U2 | C3 | 19 | 27 | FR_USB_DP_MCU |  | 3.3V | -1/未核准 | 本次设计候选，未启用profile
U2 | C3 | 20 | 30 | FR_ARM |  | 3.3V | -1/未核准 | 本次设计候选，未启用profile
U3 | C3 | 0 | 12 | RL_SCK |  | 3.3V | -1/未核准 | 本次设计候选，未启用profile
U3 | C3 | 1 | 13 | RL_MOSI |  | 3.3V | -1/未核准 | 本次设计候选，未启用profile
U3 | C3 | 2 | 5 | RL_STRAP2 |  | 3.3V | -1/未核准 | 本次设计候选，未启用profile
U3 | C3 | 3 | 6 | RL_MISO |  | 3.3V | -1/未核准 | 本次设计候选，未启用profile
U3 | C3 | 4 | 18 | RL_CS |  | 3.3V | -1/未核准 | 本次设计候选，未启用profile
U3 | C3 | 5 | 19 | READY_RL |  | 3.3V | -1/未核准 | 本次设计候选，未启用profile
U3 | C3 | 6 | 20 | RL_TX |  | 3.3V | -1/未核准 | 本次设计候选，未启用profile
U3 | C3 | 7 | 21 | RL_DE_CMD |  | 3.3V | -1/未核准 | 本次设计候选，未启用profile
U3 | C3 | 8 | 22 | RL_STRAP8 |  | 3.3V | -1/未核准 | 本次设计候选，未启用profile
U3 | C3 | 9 | 23 | RL_BOOT |  | 3.3V | -1/未核准 | 本次设计候选，未启用profile
U3 | C3 | 10 | 16 | RL_RX |  | 3.3V | -1/未核准 | 本次设计候选，未启用profile
U3 | C3 | 18 | 26 | RL_USB_DM_MCU |  | 3.3V | -1/未核准 | 本次设计候选，未启用profile
U3 | C3 | 19 | 27 | RL_USB_DP_MCU |  | 3.3V | -1/未核准 | 本次设计候选，未启用profile
U3 | C3 | 20 | 30 | RL_ARM |  | 3.3V | -1/未核准 | 本次设计候选，未启用profile
U4 | C3 | 0 | 12 | RR_SCK |  | 3.3V | -1/未核准 | 本次设计候选，未启用profile
U4 | C3 | 1 | 13 | RR_MOSI |  | 3.3V | -1/未核准 | 本次设计候选，未启用profile
U4 | C3 | 2 | 5 | RR_STRAP2 |  | 3.3V | -1/未核准 | 本次设计候选，未启用profile
U4 | C3 | 3 | 6 | RR_MISO |  | 3.3V | -1/未核准 | 本次设计候选，未启用profile
U4 | C3 | 4 | 18 | RR_CS |  | 3.3V | -1/未核准 | 本次设计候选，未启用profile
U4 | C3 | 5 | 19 | READY_RR |  | 3.3V | -1/未核准 | 本次设计候选，未启用profile
U4 | C3 | 6 | 20 | RR_TX |  | 3.3V | -1/未核准 | 本次设计候选，未启用profile
U4 | C3 | 7 | 21 | RR_DE_CMD |  | 3.3V | -1/未核准 | 本次设计候选，未启用profile
U4 | C3 | 8 | 22 | RR_STRAP8 |  | 3.3V | -1/未核准 | 本次设计候选，未启用profile
U4 | C3 | 9 | 23 | RR_BOOT |  | 3.3V | -1/未核准 | 本次设计候选，未启用profile
U4 | C3 | 10 | 16 | RR_RX |  | 3.3V | -1/未核准 | 本次设计候选，未启用profile
U4 | C3 | 18 | 26 | RR_USB_DM |  | 3.3V | -1/未核准 | 本次设计候选，未启用profile
U4 | C3 | 19 | 27 | RR_USB_DP |  | 3.3V | -1/未核准 | 本次设计候选，未启用profile
U4 | C3 | 20 | 30 | RR_ARM |  | 3.3V | -1/未核准 | 本次设计候选，未启用profile
U5 | S3 | 0 | 27 | BRAKE_BOOT |  | 3.3V | -1/未核准 | 本次设计候选，未启用profile
U5 | S3 | 1 | 39 | PORT_FAULT_N |  | 3.3V | -1/未核准 | 本次设计候选，未启用profile
U5 | S3 | 2 | 38 | MAIN_FAULT_N |  | 3.3V | -1/未核准 | 本次设计候选，未启用profile
U5 | S3 | 4 | 4 | BL_RX |  | 3.3V | -1/未核准 | 本次设计候选，未启用profile
U5 | S3 | 5 | 5 | BL_TX |  | 3.3V | -1/未核准 | 本次设计候选，未启用profile
U5 | S3 | 6 | 6 | BL_DE_CMD |  | 3.3V | -1/未核准 | 本次设计候选，未启用profile
U5 | S3 | 7 | 7 | BUZZER_CMD |  | 3.3V | -1/未核准 | 本次设计候选，未启用profile
U5 | S3 | 10 | 18 | BRAKE_CS |  | 3.3V | -1/未核准 | 本次设计候选，未启用profile
U5 | S3 | 11 | 19 | BRAKE_MOSI |  | 3.3V | -1/未核准 | 本次设计候选，未启用profile
U5 | S3 | 12 | 20 | BRAKE_SCK |  | 3.3V | -1/未核准 | 本次设计候选，未启用profile
U5 | S3 | 13 | 21 | BRAKE_MISO |  | 3.3V | -1/未核准 | 本次设计候选，未启用profile
U5 | S3 | 14 | 22 | READY_BRAKE |  | 3.3V | -1/未核准 | 本次设计候选，未启用profile
U5 | S3 | 15 | 8 | BR_RX |  | 3.3V | -1/未核准 | 本次设计候选，未启用profile
U5 | S3 | 16 | 9 | BR_TX |  | 3.3V | -1/未核准 | 本次设计候选，未启用profile
U5 | S3 | 17 | 10 | BR_DE_CMD |  | 3.3V | -1/未核准 | 本次设计候选，未启用profile
U5 | S3 | 19 | 13 | BRAKE_USB_DM |  | 3.3V | -1/未核准 | 本次设计候选，未启用profile
U5 | S3 | 20 | 14 | BRAKE_USB_DP |  | 3.3V | -1/未核准 | 本次设计候选，未启用profile
U5 | S3 | 21 | 23 | BRAKE_ARM |  | 3.3V | -1/未核准 | 本次设计候选，未启用profile
7B | ESP32-P4 | 30 |  | SCK | P3-4 | 3.3V | -1/未核准 | 本次设计候选；实板排针方向与修订待核对
7B | ESP32-P4 | 29 |  | MOSI | P3-5 | 3.3V | -1/未核准 | 本次设计候选；实板排针方向与修订待核对
7B | ESP32-P4 | 31 |  | MISO | P3-3 | 3.3V | -1/未核准 | 本次设计候选；实板排针方向与修订待核对
7B | ESP32-P4 | 28 |  | CS_FL | P3-6 | 3.3V | -1/未核准 | 本次设计候选；实板排针方向与修订待核对
7B | ESP32-P4 | 5 |  | CS_FR | P3-7 | 3.3V | -1/未核准 | 本次设计候选；实板排针方向与修订待核对
7B | ESP32-P4 | 4 |  | CS_RL | P3-8 | 3.3V | -1/未核准 | 本次设计候选；实板排针方向与修订待核对
7B | ESP32-P4 | 3 |  | CS_RR | P3-9 | 3.3V | -1/未核准 | 本次设计候选；实板排针方向与修订待核对
7B | ESP32-P4 | 2 |  | CS_BRAKE | P3-10 | 3.3V | -1/未核准 | 本次设计候选；实板排针方向与修订待核对
7B | ESP32-P4 | 52 |  | MUX_A | P1-1 | 3.3V | -1/未核准 | 本次设计候选；实板排针方向与修订待核对
7B | ESP32-P4 | 51 |  | MUX_B | P1-2 | 3.3V | -1/未核准 | 本次设计候选；实板排针方向与修订待核对
7B | ESP32-P4 | 50 |  | MUX_C | P1-3 | 3.3V | -1/未核准 | 本次设计候选；实板排针方向与修订待核对
7B | ESP32-P4 | 49 |  | MUX_Y | P1-4 | 3.3V | -1/未核准 | 本次设计候选；实板排针方向与修订待核对
