zsw151515/Automotive-telemetry-equipment/hardware/wired_tire_central/baseboard/pcb-placement.csv

Reference | X_mm | Y_mm | Rotation_deg | Layer | Part | Status
U1 | 20 | 69 | 0 | TOP | c3 | PROVISIONAL_PARTIAL_ROUTING
U2 | 54 | 69 | 0 | TOP | c3 | PROVISIONAL_PARTIAL_ROUTING
U3 | 88 | 69 | 0 | TOP | c3 | PROVISIONAL_PARTIAL_ROUTING
U4 | 122 | 69 | 0 | TOP | c3 | PROVISIONAL_PARTIAL_ROUTING
U5 | 140 | 52 | 270 | TOP | s3 | PROVISIONAL_PARTIAL_ROUTING
U12 | 20 | 56 | 0 | TOP | buf | PROVISIONAL_PARTIAL_ROUTING
U13 | 44 | 61.2 | 0 | TOP | buf | PROVISIONAL_PARTIAL_ROUTING
U14 | 88 | 56 | 0 | TOP | buf | PROVISIONAL_PARTIAL_ROUTING
U15 | 132 | 66 | 0 | TOP | buf | PROVISIONAL_PARTIAL_ROUTING
U16 | 123 | 54 | 0 | TOP | buf | PROVISIONAL_PARTIAL_ROUTING
U18 | 111 | 49 | 0 | TOP | mux | PROVISIONAL_PARTIAL_ROUTING
U35 | 102 | 57 | 0 | TOP | axc8 | PROVISIONAL_PARTIAL_ROUTING
U36 | 99 | 48.8 | 0 | TOP | axc4 | PROVISIONAL_PARTIAL_ROUTING
U31 | 12 | 52 | 0 | TOP | main | PROVISIONAL_PARTIAL_ROUTING
U32 | 32 | 54 | 270 | TOP | buck | PROVISIONAL_PARTIAL_ROUTING
U33 | 32 | 46 | 270 | TOP | buck | PROVISIONAL_PARTIAL_ROUTING
U34 | 59.5 | 48.5 | 0 | TOP | ideal | PROVISIONAL_PARTIAL_ROUTING
Q1 | 6.5 | 44 | 0 | TOP | mos100 | PROVISIONAL_PARTIAL_ROUTING
Q2 | 22 | 48 | 0 | TOP | mos100 | PROVISIONAL_PARTIAL_ROUTING
Q3 | 65 | 46.4 | 0 | TOP | mos30 | PROVISIONAL_PARTIAL_ROUTING
Q4 | 76 | 20 | 0 | TOP | buzzmos | PROVISIONAL_PARTIAL_ROUTING
Q5 | 106 | 43 | 0 | TOP | buzzmos | PROVISIONAL_PARTIAL_ROUTING
BZ1 | 74.5 | 10 | 0 | TOP | buzz | PROVISIONAL_PARTIAL_ROUTING
J1 | 6.5 | 34 | 0 | BOTTOM | inputconn | PROVISIONAL_PARTIAL_ROUTING
J2 | 70 | 32 | 0 | TOP | screenconn | PROVISIONAL_PARTIAL_ROUTING
J3 | 70 | 58.5 | 0 | TOP | p4conn | PROVISIONAL_PARTIAL_ROUTING
J4 | 70 | 52.5 | 0 | TOP | p4conn | PROVISIONAL_PARTIAL_ROUTING
J11 | 25 | 40.5 | 180 | BOTTOM | progconn | PROVISIONAL_PARTIAL_ROUTING
J12 | 71 | 68 | 180 | BOTTOM | progconn | PROVISIONAL_PARTIAL_ROUTING
J13 | 105.25 | 68 | 180 | BOTTOM | progconn | PROVISIONAL_PARTIAL_ROUTING
J14 | 122 | 44 | 0 | BOTTOM | progconn | PROVISIONAL_PARTIAL_ROUTING
J15 | 122.5 | 26 | 0 | BOTTOM | progconn | PROVISIONAL_PARTIAL_ROUTING
D1 | 13.7 | 35 | 270 | TOP | tvsraw | PROVISIONAL_PARTIAL_ROUTING
D2 | 25 | 33.5 | 0 | TOP | tvsbus | PROVISIONAL_PARTIAL_ROUTING
D3 | 31.5 | 34.8 | 90 | TOP | schottky | PROVISIONAL_PARTIAL_ROUTING
D4 | 75 | 24 | 0 | TOP | schottky | PROVISIONAL_PARTIAL_ROUTING
L1 | 40.35 | 54 | 0 | TOP | inductor | PROVISIONAL_PARTIAL_ROUTING
L2 | 40.35 | 46 | 0 | TOP | inductor | PROVISIONAL_PARTIAL_ROUTING
R128 | 17.7 | 50 | 0 | TOP | r1k | PROVISIONAL_PARTIAL_ROUTING
C53 | 15.5 | 50.4 | 90 | TOP | c2n2 | PROVISIONAL_PARTIAL_ROUTING
C52 | 11.3 | 56.75 | 90 | TOP | c220n | PROVISIONAL_PARTIAL_ROUTING
C55 | 15.3 | 55.5 | 90 | TOP | c100n | PROVISIONAL_PARTIAL_ROUTING
C56 | 6 | 53.4 | 90 | TOP | c100n | PROVISIONAL_PARTIAL_ROUTING
C57 | 36.65 | 55.27 | 90 | TOP | c100n | PROVISIONAL_PARTIAL_ROUTING
C58 | 36.65 | 52.5 | 270 | TOP | c1u | PROVISIONAL_PARTIAL_ROUTING
C59 | 25.2 | 55.25 | 90 | TOP | c10u50 | PROVISIONAL_PARTIAL_ROUTING
C60 | 27.8 | 59.5 | 90 | TOP | c10u50 | PROVISIONAL_PARTIAL_ROUTING
C61 | 27.3 | 55.27 | 90 | TOP | c220n | PROVISIONAL_PARTIAL_ROUTING
R130 | 36.4 | 50.25 | 180 | TOP | r100k | PROVISIONAL_PARTIAL_ROUTING
R131 | 33 | 50.1 | 180 | TOP | r24k9 | PROVISIONAL_PARTIAL_ROUTING
C66 | 36.65 | 47.27 | 90 | TOP | c100n | PROVISIONAL_PARTIAL_ROUTING
C67 | 36.65 | 44.5 | 270 | TOP | c1u | PROVISIONAL_PARTIAL_ROUTING
C68 | 25.9 | 43.9 | 90 | TOP | c10u50 | PROVISIONAL_PARTIAL_ROUTING
C69 | 25.9 | 37.2 | 0 | TOP | c10u50 | PROVISIONAL_PARTIAL_ROUTING
C70 | 27.3 | 47.27 | 90 | TOP | c220n | PROVISIONAL_PARTIAL_ROUTING
R132 | 36.4 | 42.25 | 180 | TOP | r100k | PROVISIONAL_PARTIAL_ROUTING
R133 | 33 | 42.1 | 180 | TOP | r43k2 | PROVISIONAL_PARTIAL_ROUTING
C62 | 44.8 | 54 | 270 | TOP | c22u25 | PROVISIONAL_PARTIAL_ROUTING
C63 | 47.2 | 54 | 270 | TOP | c22u25 | PROVISIONAL_PARTIAL_ROUTING
C64 | 49.6 | 54 | 270 | TOP | c22u25 | PROVISIONAL_PARTIAL_ROUTING
C65 | 52 | 54 | 270 | TOP | c22u25 | PROVISIONAL_PARTIAL_ROUTING
C71 | 44.8 | 46 | 270 | TOP | c22u25 | PROVISIONAL_PARTIAL_ROUTING
C72 | 47.2 | 46 | 270 | TOP | c22u25 | PROVISIONAL_PARTIAL_ROUTING
C73 | 49.6 | 46 | 270 | TOP | c22u25 | PROVISIONAL_PARTIAL_ROUTING
C74 | 52 | 46 | 270 | TOP | c22u25 | PROVISIONAL_PARTIAL_ROUTING
R119 | 14 | 47 | 0 | TOP | sense | PROVISIONAL_PARTIAL_ROUTING
C54 | 27.5 | 26.6 | 0 | TOP | c100u35 | PROVISIONAL_PARTIAL_ROUTING
J5 | 14.5 | 12 | 0 | BOTTOM | probeconn | PROVISIONAL_PARTIAL_ROUTING
U6 | 14.5 | 26 | 0 | TOP | rs485 | PROVISIONAL_PARTIAL_ROUTING
U19 | 7.5 | 26 | 0 | TOP | and | PROVISIONAL_PARTIAL_ROUTING
U25 | 18.7 | 35.8 | 0 | TOP | portpower | PROVISIONAL_PARTIAL_ROUTING
D5 | 15.0 | 20 | 0 | TOP | tvsab | PROVISIONAL_PARTIAL_ROUTING
D6 | 22.5 | 20 | 0 | TOP | tvsab | PROVISIONAL_PARTIAL_ROUTING
J6 | 38.5 | 12 | 0 | BOTTOM | probeconn | PROVISIONAL_PARTIAL_ROUTING
U7 | 38.5 | 26 | 0 | TOP | rs485 | PROVISIONAL_PARTIAL_ROUTING
U20 | 38.5 | 33 | 0 | TOP | and | PROVISIONAL_PARTIAL_ROUTING
U26 | 39.6 | 39 | 0 | TOP | portpower | PROVISIONAL_PARTIAL_ROUTING
D7 | 34.5 | 20 | 0 | TOP | tvsab | PROVISIONAL_PARTIAL_ROUTING
D8 | 42.5 | 20 | 0 | TOP | tvsab | PROVISIONAL_PARTIAL_ROUTING
J7 | 62.5 | 12 | 0 | BOTTOM | probeconn | PROVISIONAL_PARTIAL_ROUTING
U8 | 62.5 | 26 | 0 | TOP | rs485 | PROVISIONAL_PARTIAL_ROUTING
U21 | 62.5 | 32.5 | 0 | TOP | and | PROVISIONAL_PARTIAL_ROUTING
U27 | 62.5 | 38 | 0 | TOP | portpower | PROVISIONAL_PARTIAL_ROUTING
D9 | 58.5 | 20 | 0 | TOP | tvsab | PROVISIONAL_PARTIAL_ROUTING
D10 | 66.5 | 20 | 0 | TOP | tvsab | PROVISIONAL_PARTIAL_ROUTING
J8 | 86.5 | 12 | 0 | BOTTOM | probeconn | PROVISIONAL_PARTIAL_ROUTING
U9 | 86.5 | 26 | 0 | TOP | rs485 | PROVISIONAL_PARTIAL_ROUTING
U22 | 86.5 | 33 | 0 | TOP | and | PROVISIONAL_PARTIAL_ROUTING
U28 | 86.5 | 39 | 0 | TOP | portpower | PROVISIONAL_PARTIAL_ROUTING
D11 | 82.5 | 20 | 0 | TOP | tvsab | PROVISIONAL_PARTIAL_ROUTING
D12 | 90.5 | 20 | 0 | TOP | tvsab | PROVISIONAL_PARTIAL_ROUTING
J9 | 110.5 | 12 | 0 | BOTTOM | probeconn | PROVISIONAL_PARTIAL_ROUTING
U10 | 110.5 | 26 | 0 | TOP | rs485 | PROVISIONAL_PARTIAL_ROUTING
U23 | 110.5 | 33 | 0 | TOP | and | PROVISIONAL_PARTIAL_ROUTING
U29 | 110.5 | 39 | 0 | TOP | portpower | PROVISIONAL_PARTIAL_ROUTING
D13 | 106.5 | 20 | 0 | TOP | tvsab | PROVISIONAL_PARTIAL_ROUTING
D14 | 114.5 | 20 | 0 | TOP | tvsab | PROVISIONAL_PARTIAL_ROUTING
J10 | 134.5 | 12 | 0 | BOTTOM | probeconn | PROVISIONAL_PARTIAL_ROUTING
U11 | 134.5 | 26 | 0 | TOP | rs485 | PROVISIONAL_PARTIAL_ROUTING
U24 | 134.5 | 33 | 0 | TOP | and | PROVISIONAL_PARTIAL_ROUTING
U30 | 134.5 | 38 | 0 | TOP | portpower | PROVISIONAL_PARTIAL_ROUTING
D15 | 130.5 | 20 | 0 | TOP | tvsab | PROVISIONAL_PARTIAL_ROUTING
D16 | 138.5 | 20 | 0 | TOP | tvsab | PROVISIONAL_PARTIAL_ROUTING
C1 | 16.5 | 58.5 | 90 | TOP | c100n | PROVISIONAL_PARTIAL_ROUTING
C4 | 12.0 | 71.25 | 90 | TOP | c100n | PROVISIONAL_PARTIAL_ROUTING
C5 | 40.5 | 63.75 | 90 | TOP | c100n | PROVISIONAL_PARTIAL_ROUTING
C8 | 45.75 | 71.25 | 0 | TOP | c100n | PROVISIONAL_PARTIAL_ROUTING
C9 | 86.25 | 60.75 | 0 | TOP | c100n | PROVISIONAL_PARTIAL_ROUTING
C12 | 80.25 | 71.25 | 90 | TOP | c100n | PROVISIONAL_PARTIAL_ROUTING
C13 | 130.5 | 71.25 | 0 | TOP | c100n | PROVISIONAL_PARTIAL_ROUTING
C16 | 114.0 | 71.25 | 90 | TOP | c100n | PROVISIONAL_PARTIAL_ROUTING
C17 | 119.25 | 57.0 | 90 | TOP | c100n | PROVISIONAL_PARTIAL_ROUTING
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
R101 | 84.75 | 15.75 | 0 | TOP | r120 | PROVISIONAL_PARTIAL_ROUTING
R102 | 82.5 | 12.0 | 90 | TOP | r390 | PROVISIONAL_PARTIAL_ROUTING
R103 | 87.75 | 15.75 | 0 | TOP | r390 | PROVISIONAL_PARTIAL_ROUTING
R104 | 105.75 | 27.75 | 90 | TOP | r1k | PROVISIONAL_PARTIAL_ROUTING
R105 | 128.25 | 46.5 | 0 | TOP | r4k7 | PROVISIONAL_PARTIAL_ROUTING
R106 | 113.25 | 36.75 | 90 | TOP | r6k19 | PROVISIONAL_PARTIAL_ROUTING
R107 | 113.25 | 41.25 | 90 | TOP | r100k | PROVISIONAL_PARTIAL_ROUTING
R108 | 108.75 | 15.75 | 0 | TOP | r120 | PROVISIONAL_PARTIAL_ROUTING
R109 | 106.5 | 12.0 | 90 | TOP | r390 | PROVISIONAL_PARTIAL_ROUTING
R110 | 111.75 | 15.75 | 0 | TOP | r390 | PROVISIONAL_PARTIAL_ROUTING
R111 | 129.75 | 27.75 | 90 | TOP | r1k | PROVISIONAL_PARTIAL_ROUTING
R112 | 126.75 | 48.75 | 0 | TOP | r4k7 | PROVISIONAL_PARTIAL_ROUTING
R113 | 137.25 | 36.75 | 90 | TOP | r6k19 | PROVISIONAL_PARTIAL_ROUTING
R114 | 138.75 | 40.5 | 90 | TOP | r100k | PROVISIONAL_PARTIAL_ROUTING
R115 | 132.75 | 15.75 | 0 | TOP | r120 | PROVISIONAL_PARTIAL_ROUTING
R116 | 130.5 | 12.0 | 90 | TOP | r390 | PROVISIONAL_PARTIAL_ROUTING
R117 | 135.75 | 15.75 | 0 | TOP | r390 | PROVISIONAL_PARTIAL_ROUTING
R118 | 147.75 | 41.25 | 0 | TOP | r10k | PROVISIONAL_PARTIAL_ROUTING
R129 | 144.75 | 41.25 | 0 | TOP | r10k | PROVISIONAL_PARTIAL_ROUTING
R134 | 28.0 | 65.4 | 0 | TOP | r33 | PROVISIONAL_PARTIAL_ROUTING
R135 | 28.0 | 67.0 | 0 | TOP | r33 | PROVISIONAL_PARTIAL_ROUTING
C76 | 30.5 | 64.5 | 270 | TOP | cUsbDnp | PROVISIONAL_PARTIAL_ROUTING
C77 | 30.5 | 67.4 | 90 | TOP | cUsbDnp | PROVISIONAL_PARTIAL_ROUTING
R136 | 62 | 65.4 | 0 | TOP | r33 | PROVISIONAL_PARTIAL_ROUTING
R137 | 62 | 67 | 0 | TOP | r33 | PROVISIONAL_PARTIAL_ROUTING
C78 | 64.5 | 64.5 | 270 | TOP | cUsbDnp | PROVISIONAL_PARTIAL_ROUTING
C79 | 64.5 | 67.4 | 90 | TOP | cUsbDnp | PROVISIONAL_PARTIAL_ROUTING
R138 | 96 | 65.4 | 0 | TOP | r33 | PROVISIONAL_PARTIAL_ROUTING
R139 | 96 | 67 | 0 | TOP | r33 | PROVISIONAL_PARTIAL_ROUTING
C80 | 98.36 | 64.45 | 270 | TOP | cUsbDnp | PROVISIONAL_PARTIAL_ROUTING
C81 | 98.75 | 67.4 | 90 | TOP | cUsbDnp | PROVISIONAL_PARTIAL_ROUTING
