zsw151515/Automotive-telemetry-equipment/hardware/brake_temp_alarm_display_12v_rs485/3d/3D_pcb_brake_temp_alarm_display_12V_RS485_2026-05-30.step

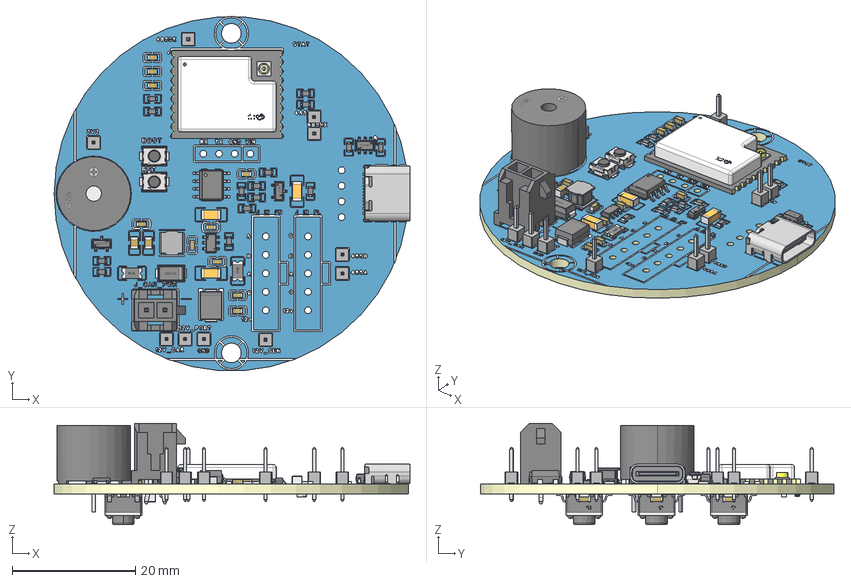
[picture p7: CAD file, 2026-05-30]
hardware/brake_temp_alarm_display_12v_rs485/3d/3D_pcb_brake_temp_alarm_display_12V_RS485_2026-05-30.step
57.8 x 57.5 x 16.5 mm
Board~oOQS
TopCopper~oOQS
BottomCopper~oOQS
TopSilkscreen~oOQS
BottomSilkscreen~oOQS
TopFpcStiffener~oOQS
BottomFpcStiffener~oOQS
C0603~C0603_L1.6-W0.8-H0.8~oOQS x 10
SW-SMD_L3.9-W3.0-P4.45~SW-SMD_L3.9-W2.9-H2.0-LS4.8~oOQS x 2
C0805~C0805_L2.0-W1.3-H1.3~oOQS x 2
SOT-23-6_L2.9-W1.6-P0.95-LS2.8-BL~SOT-23-6_ L2.9-W1.6-H1.5-LS2.8-P0.95~oOQS
F1206~F1206_L3.2-W1.7-H0.6~oOQS x 2
USB-C-SMD_TYPE-C-6PIN-2MD-073~USB-C-SMD_TYPE-C-6PIN-2MD-073~oOQS
SOIC-8_L5.0-W4.0-P1.27-LS6.0-BL~SOIC-8_L5.0-W4.0-P1.27-LS6.0-BL~oOQS
HDR-TH_1P-V-M_XKB_X4611WV-01I-C28D40~HDR-TH_1P-V-M_XKB_ X4611WV-01I-C28D40~oOQS x 10
SMA_L4.3-W2.6-LS5.0-FD~SMA_L4.3-W2.6-LS5.0-FD~oOQS
BUZ-TH_BD12.0-P7.60-D0.6-FD~BUZ-TH_D12.0-H9.5-P7.60~oOQS
CONN-TH_4P-P3.00_HC-MX3.0-2X1A~CONN-TH_4P-P3.00_HC-MX3.0-2X1A~oOQS
LED0603-RD_BLUE~LED0603-RD_BLUE~oOQS
R0603~R0603~oOQS x 19
TSOT-26_L2.9-W1.6-P0.95-LS2.8-BL~TSOT-26_L2.9-W1.6-P0.95-LS2.8-BL~oOQS
C1206~C1206_L3.2-W1.6-H1.3~oOQS x 3
CAP-SMD_L2.0-W1.25~CAP-SMD_L2.0-W1.3-H1.3~oOQS x 3
SMB_L4.5-W3.6-LS5.4-RD~SMB_L4.5-W3.6-LS5.4-RD~oOQS
KEY-SMD_4P-L6.0-W6.0-P4.50-LS9.5-BR~SMD_ 4P-L6.0-W6.0-H5.0-LS10.0-P4.5~oOQS x 3
SOT-23-3_L2.9-W1.3-P1.90-LS2.4-BR~SOT-23-3P_ L2.9-W1.3-H1.0-LS2.4-P0.95~oOQS x 2
WIFI-SMD_L18.0-W14.3_ESP32-C3-WROOM-02U-N4~WIFI-SMD_L18.0-W14.3_ ESP32-C3-WROOM-02U-N4~oOQS
IND-SMD_L4.0-W4.0_FNR40XXS~IND-SMD_L4.0-W4.0-H2.6_FNR40XXS~oOQS
