zsw151515/Automotive-telemetry-equipment/hardware/wired_tire_central/enclosure/exports/retainer.stl

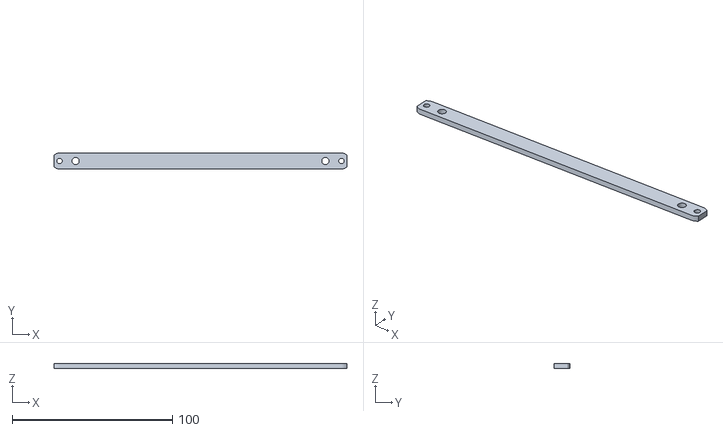
[picture p8: CAD file, 2026-10-26]
hardware/wired_tire_central/enclosure/exports/retainer.stl
183.0 x 10.0 x 3.00
