zsw151515/Automotive-telemetry-equipment/hardware/wired_tire_central/enclosure/exports/rear_cover.stl

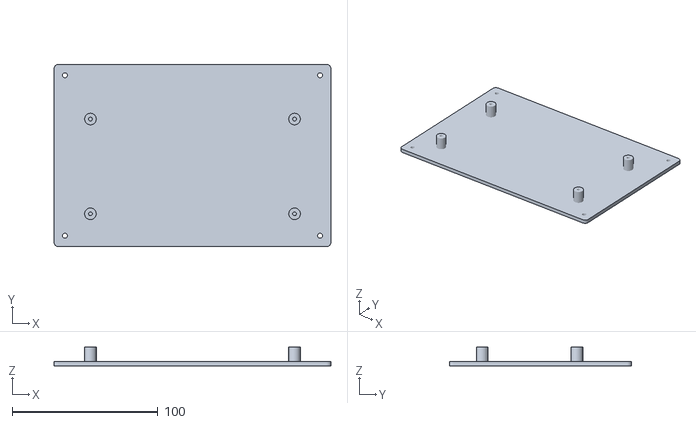
[picture p9: CAD file, 2026-10-26]
hardware/wired_tire_central/enclosure/exports/rear_cover.stl
190.0 x 125.0 x 13.0
