zsw151515/Automotive-telemetry-equipment/hardware/wired_tire_central/enclosure/exports/body.stl

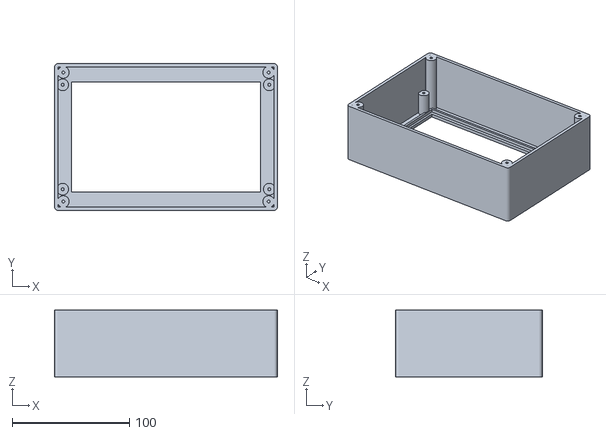
[picture p10: CAD file, 2026-10-26]
hardware/wired_tire_central/enclosure/exports/body.stl
190.0 x 125.0 x 57.0
