zsw151515/Automotive-telemetry-equipment/hardware/wired_tire_central/enclosure/exports/rear_cover_ports.stl

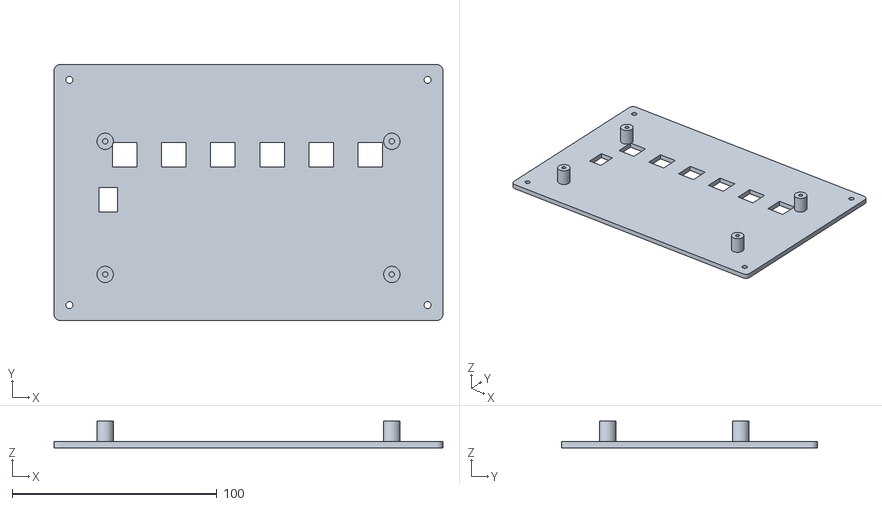
[picture p11: CAD file, 2026-10-26]
hardware/wired_tire_central/enclosure/exports/rear_cover_ports.stl
190.0 x 125.0 x 13.0
