zsw151515/Automotive-telemetry-equipment/hardware/wired_tire_central/enclosure/pcb_mechanical.scad

// 当前PCB连接器外壳包络中心投影，非厂商面板开孔规范。
port_centres = [[34.5, 44.085], [58.5, 44.085], [82.5, 44.085], [106.5, 44.085], [130.5, 44.085], [154.5, 44.085], [26.5, 66.085]];
port_label = ["FL", "FR", "RL", "RR", "BL", "BR", "12V"];
port_windows = [[12, 12], [12, 12], [12, 12], [12, 12], [12, 12], [12, 12], [9, 12]];
