zsw151515/Automotive-telemetry-equipment/(list of files, cad)

Other CAD files:
hardware/wired_tire_central/enclosure/exports/rear_cover_pilot.stl
