zsw151515/Automotive-telemetry-equipment/hardware/wired_tire_central/notes/validation_vehicle.md

# 车辆与赛道验证

状态：未执行。用户当前要求先完成离线软件。

需要实车确认前轮约 2 m、后轮约 4.5 m 线束的抗干扰与压降、转向及悬挂全行程间隙、探头视场与镜头污染、7 英寸屏日光可读及振动固定、集中四个 BLE 天线的连接表现。

软件帧率目标、PC 合成画面和编译结果均不能替代这些证据。真实测量到显示的端到端延迟须用热源变化对照记录，不仅统计串口响应次数。

## 六口增量（NOT RUN）

六探头线束前2m后约4.5m；轮眉视场、防水/热源/转向压缩行程、刹车视场发射率、壳内五天线耦合与屏幕固定均须实车测。未通过前不将BOM/Gerber标为最终定版或实车验证通过；工程样机在其范围完成必要电气/引脚/原理图审查后可以先行试制，真实探头与实车验收后补。见 prototype_sequence.md。
