zsw151515/Automotive-telemetry-equipment/hardware/wired_tire_central/notes/validation_matrix.md

# 有线胎温中控验证矩阵

用户尚未备齐探头，当前范围为离线软件。以下“未通过”表示尚未实测，并非已经测得失败。

| 关卡 | 当前状态 | 证据要求 |
| --- | --- | --- |
| A 成品探头协议 | 未通过 | 真实抓包、参数、完整矩阵、热源移动及新图像响应 |
| B 单轮 RaceChrono | 未通过 | 目标手机实际连接、保留字段、轮位和失效显示 |
| C 四轮 BLE 共存 | 未通过 | 四个真实探头与无线单元、至少 60 min、遮挡与重连 |
| D SPI 与显示 | 未通过实物验证 | SPI 真实连线、面板实际帧率、延迟和日光可读 |
| E 供电及线束 | 未通过 | 2 m/4.5 m 线束、点火压降、单支路保护与恢复 |
| F 车辆与赛道 | 未通过 | 机械间隙、振动、温度、视场、实际用电环境 |
| G 六接口胎温/刹车集成增量 | 未通过 | 两刹车协议/独立线路、后台热模型与报警/蜂鸣、触屏命令回执/去重/保存及断电、五 BLE 共存、六支路电源保护 |

离线单元测试和固件编译结果单独记录，不能将本表改成整机通过。当前禁止据此冻结制造输出或宣称稳定交付。

## 六口增量（NOT RUN）

六口增量：resource_approval、validation_brake、validation_settings均NOT RUN；新离线验证另见validation_six_port_offline.md，不替代硬件关卡。
