zsw151515/Automotive-telemetry-equipment/hardware/wired_tire_central/notes/validation_power.md

# 电源与线束验证

状态：未执行，没有探头及中控实板。不能声明启动压降、浪涌、反接、单支路保护或断电配置恢复已通过。

后续需记录点火取电位置、启动/熄火时序、输入与各电源测点、示波器波形、仪器和限流条件，以及每条探头支路与屏幕背光工作电流。探头手册 6–29 V 直流范围不等于汽车瞬态认证。

当前固件只使用编译期设置，不运行 Flash 配置写入；因此不存在已实现运行期持久化设置的声明。若后续增加运行期保存，须实现可恢复写入和实际断电实验。

## 六口增量（NOT RUN）

六口增加第五C3/双RS485/蜂鸣，须重新测电流预算、启动压降、USB及传感器接口反灌、DE上电默认关闭；至少30次点火循环。点火开关试验不能替代车规浪涌/反接验证。
