zsw151515/Automotive-telemetry-equipment/hardware/wired_tire_central/notes/validation_spi.md

# SPI 验证记录

状态：仅离线核心测试通过，未进行 C3/P4 真实接线或测量。

六接口最新设计拟增加第五从机 BrakeLink（刹车状态与设置），P4 目标需 13 GPIO，含五设备统一调度、命令去重与回执。下列既有离线证据仅覆盖原四胎温 Snapshot v1，不证明 BrakeLink 或五设备时序正确。

2026-10-24 结构调整为同一外壳内的 7B 套件到四接口采集底板短连接；原字节协议保持，板间连接器、地参考、信号完整性与实际 GPIO 需重新核准，不能把原同板假设当作已验证。2 m/4.5 m 轮眉线束仍使用 RS485。

已验证：固定快照的字节布局、CRC、轮位/token、重启/序号回绕元数据、在途 DMA 缓冲租约、源数据年龄与请求/主机经过时间叠加及溢出保护。

传输采用等长 1728 字节事务，首事务可收到无效或旧 token 的排队响应，必须丢弃；随后匹配 token 才发布。本方案增加传输量，至少需要两次事务取得新请求对应快照；四路 4 Hz 的基线传输量约 55 kB/s（单方向计），需要实测吞吐与 100 ms 窗口。

实物需要检查：1 MHz mode 0 的建立/保持时间，DMA 对齐和内存能力，就绪信号时序，四路 MISO 三态、复位/断线/片选故障、P4 重启和从机停止响应，以及 BLE 与显示是否持续。未完成前不冻结 PCB。

## 六口增量（NOT RUN）

六口为五从机：4×1728字节胎温＋1×256字节BrakeLink。测五CS/READY、1MHz mode0、100ms窗口、超时DMA租约、一路未就绪/总线短路、错token与重启；13信号未核准。
