zsw151515/Automotive-telemetry-equipment/hardware/wired_tire_central/notes/validation_probe.md

# 成品探头协议验证

状态：未通过关卡 A。用户尚未备齐硬件，先完成离线软件。

已完成：合成全帧解析测试、只读抓包工具测试。未进行串口探测、写配置、真实抓包或热源实验。

必须验证的实物信息：探头型号及版本、供电、默认波特率与停止位、0x65 请求/完整响应、CRC、像素偏移、负温编码、5 Hz 与 4 Hz 的实际差异、同一完整帧一致性、传感器自身故障时输出。

不得用接收到响应的次数推断新采样次数，不以连续相同图像判定内部算法失效。
