zsw151515/Automotive-telemetry-equipment/tests/wired_tire/fixtures/README.md

# 胎温测试样本

当前仅有测试代码生成的合成帧，未取得成品探头实测帧。合成帧用于验证长度、CRC、字节序和越界保护，不能证明探头协议、帧率或测温准确性。

收到实测数据后，将必要的小型单帧二进制样本及模块版本、确认的串口配置、读取请求、样本来源说明一起保存。JSONL 原始采集须先按真实帧边界提取二进制帧，不能将日志文本直接交给解码器。
