zsw151515/Automotive-telemetry-equipment/hardware/wired_tire_central/notes/validation_ble.md

# RaceChrono BLE 验证

状态：关卡 B/C 未通过，没有目标手机、探头或四无线单元实测。

已通过的离线证据：四轮名称及稳定后缀编码、三个 20 字节特征温度布局、负温和零温、无效/过期停发门控。编码测试不能证明手机已连接或已正确显示。

硬件 profile 必须定义 bleAuxVerified 和 auxiliaryFields。前者只有在下列信息记录完成后才能设为 true：RaceChrono/手机/OS 版本、三个特征的 B1–B3 实际编码、无高度及无电池时界面行为、断线重连、传感器失效后最后值的显示与记录行为。

四轮验证还需记录四个唯一地址及名称、FL/FR/RL/RR 对应关系、屏幕及外壳遮挡、依次改变四轮热源、至少 60 min 同时连接、单路断开/重启及其余三轮连续运行结果。当前这些项目均未执行。

通知调度约 30 ms 一轮，三个特征分时发送，避免回调中的长 delay。重复通知不能被当成探头新测温帧率。

## 六口增量（NOT RUN）

目标手机同时连接四个RejsaRubberTrac胎温身份＋N BrakeTemp（1FF8 DIY CAN），至少60分钟，逐探头改变温度/遮挡/断连恢复，记录0x100..107的有符号温度/单位/无效7FFF及实际RaceChrono公式。
