zsw151515/Automotive-telemetry-equipment/hardware/wired_tire_central/notes/validation_brake.md

# 双前刹车台架验证

状态：NOT RUN。离线测试不等于传感器协议或蜂鸣实测。

1. 先核准resource_approval.md；使用限流台式12V及受保护5V供电。核对两成品探头真实地址/供电/功能码/寄存器，保持只读03/04。与115200 8N2/65胎温总线分开。
2. 用capture_brake_rs485.py分别抓FL/FR：显式port/address/function/register/baud/stopbits/seconds/output。保存原始收发、单调时钟、接线照片与串口日志；禁止广播和写寄存器探测。
3. 测0/负温/低温/热源，模拟CRC错、尾字节超20ms、短路/断开一路，验证另一条继续；失效2500ms，不归假零温。用独立温度计验证量程/安装视场与盘面发射率影响。
4. 采用降低ALM的受控热源验证持续6秒/辅助5秒、释放条件、部分失效状态与蜂鸣；FAIL本身静音，关闭WARN提示音不能屏蔽ALARM。记录150/300ms、80/1500ms以及60秒静音实测。
5. 拔掉/重启P4、触摸失效、BLE断开时持续采集/模型/报警。第五C3失效没有报警冗余，大屏必须显示控制器丢失。
6. 实车前记录完整2m/4.5m线束、屏蔽/接地、终端与偏置、抗震固定；先台架后车上，记录故障注入与恢复日志。
