zsw151515/Automotive-telemetry-equipment/hardware/wired_tire_central/notes/validation_display.md

# 四路热图显示验证

状态：离线绘图测试通过，实际面板和四路并发显示未测。

覆盖：768 点完整映射、非整数放大、色标共享、0°C 和负温、无效像素、最高温排除无效点、灰显超时、画布边界及双缓冲刷新租约。

绘图按 768 个源像素计算颜色后填充放大区域，避免对每个放大像素重复计算色值；没有时间插值或额外平滑来伪造新测温帧。

双缓冲在提交后保守等待两个刷新计数事件才允许复用旧缓冲；它保证软件侧不立即重写在途画面，但具体 DSI/DMA 事件顺序、撕裂、吞吐、UI 提交率和探头端到端延迟仍须实测。30 FPS 是目标，不是目前已取得的硬件结果。

预览若使用合成热源会标注 SIMULATED DATA，不能作为实车或新帧率证据。

## 六口增量（NOT RUN）

新三页预览有SIMULATED DATA，仅离线绘制。四幅完整32×24；所有页面全局报警。六探头/五BLE/触摸至少同时10分钟，测实际提交/刷新间隔、最大卡顿/端到端延迟，目标30FPS未实测。
