zsw151515/Automotive-telemetry-equipment/hardware/wired_tire_central/notes/validation_settings.md

# 设置持久化与回执验证

状态：NOT RUN。离线状态机/存储替身不能证明Flash掉电安全。

- 分别在写前、写中、写后、ACK前断电；至少各30次，保存电源波形和启动日志。重启只接受CRC完整旧/新记录，绝不宣称一定回滚。
- 对双槽缺失、长度损坏、CRC错、同版本不同内容及读回不可用注入故障；未知结果保持当前有效值并禁新保存，恢复读回后显示实际配置。
- 重复/丢/乱序ACK、同ID不同内容、缓存8条淘汰后重放、旧会话、旧boot及配置版本不匹配均不得重复写入或复位模型。
- ALM真正变化只复位一次；相同ALM/仅WARN开关不复位。静音只从首次执行起算60秒，重试不延长，不写NVS。
- P4重启与刹车C3重启分别检查草稿/生效值/已保存标签；源状态超过1000ms禁写并显示未知。旧brake12v仅只读迁移，不清旧键，迁移/异常提示确认。
- 记录NVS最大停顿、持续采集期限、蜂鸣节拍与BLE行为。手机/屏幕确认前不得勾通过。
