zsw151515/Automotive-telemetry-equipment/hardware/tire_temp_height_v3/schematic/SCH_sch_tire_tempe_height_v3_small_2026-05-27.pdf

# 电池电压检测 状态灯

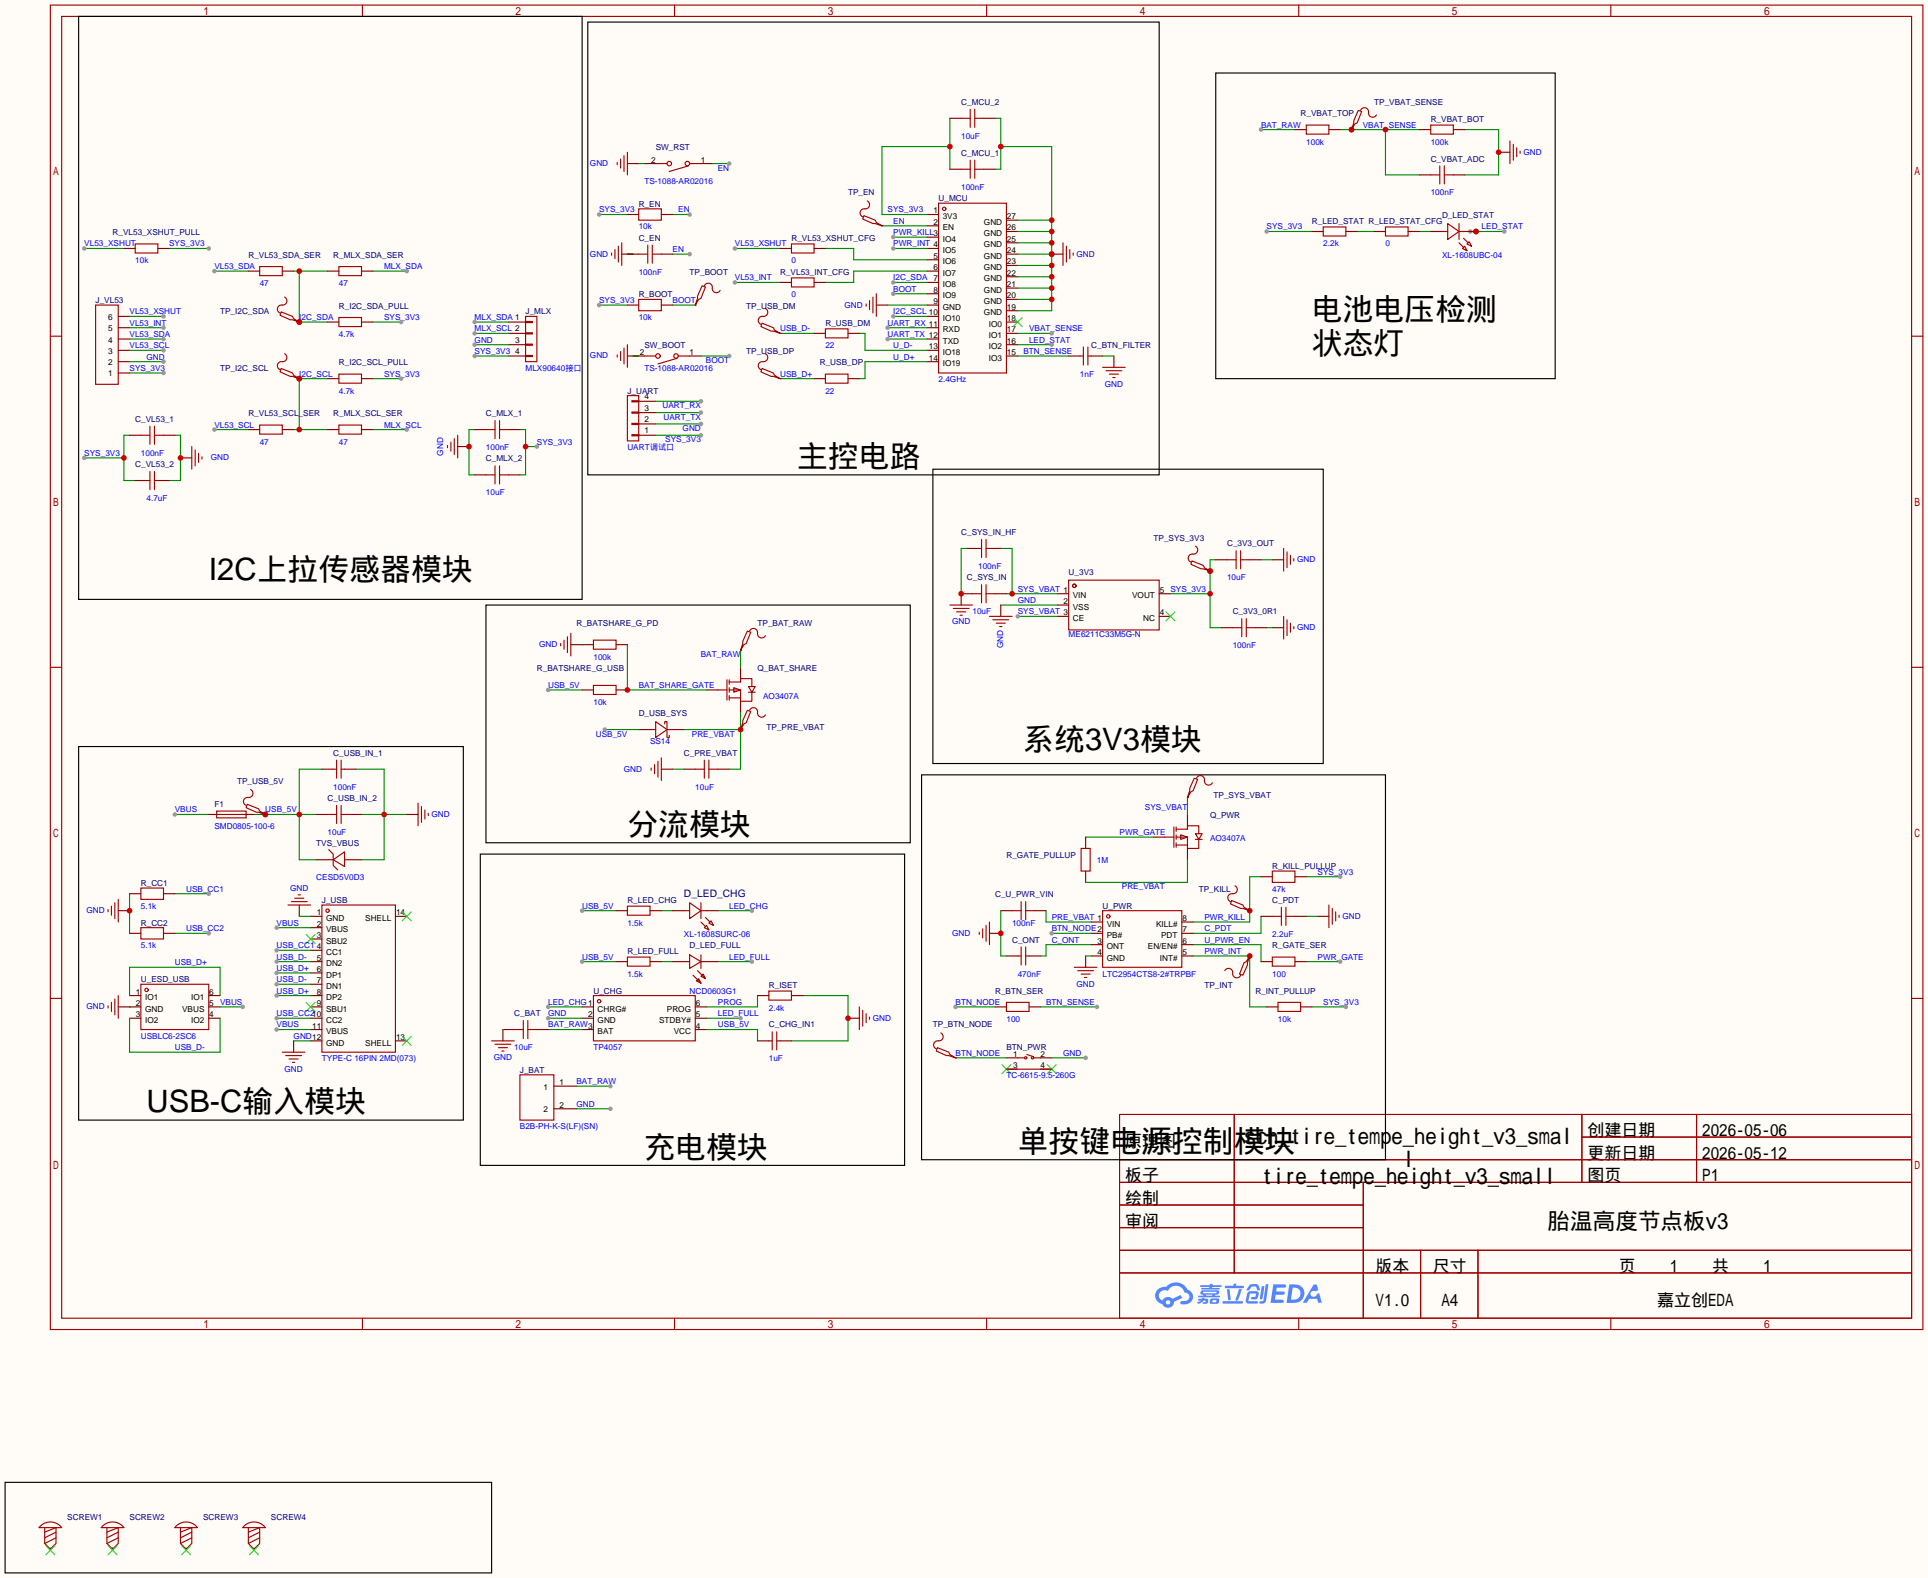
[picture p12: page 1]

原理图 | sch_tire_tempe_height_v3_smal | 创建日期 | 2026-05-06
板子 | tire_tempe_height_v3_small | 图页 | P1
绘制 | | 胎温高度节点板v3
审阅

更新日期 | 2026-05-12

V1.0 | A4 | 嘉立创EDA
