zsw151515/Automotive-telemetry-equipment/hardware/wired_tire_central/baseboard/exports/six-port-baseboard-v01.pdf

IO19 27 IO18 26 NC 25 NC 24 IO9 23 IO8 22 IO7 21 IO6 20 IO5 19 IO4 18 NC 17 IO10 16 NC 15 GND 14 IO1 13 IO0 12 GND 11 NC 10 NC 9

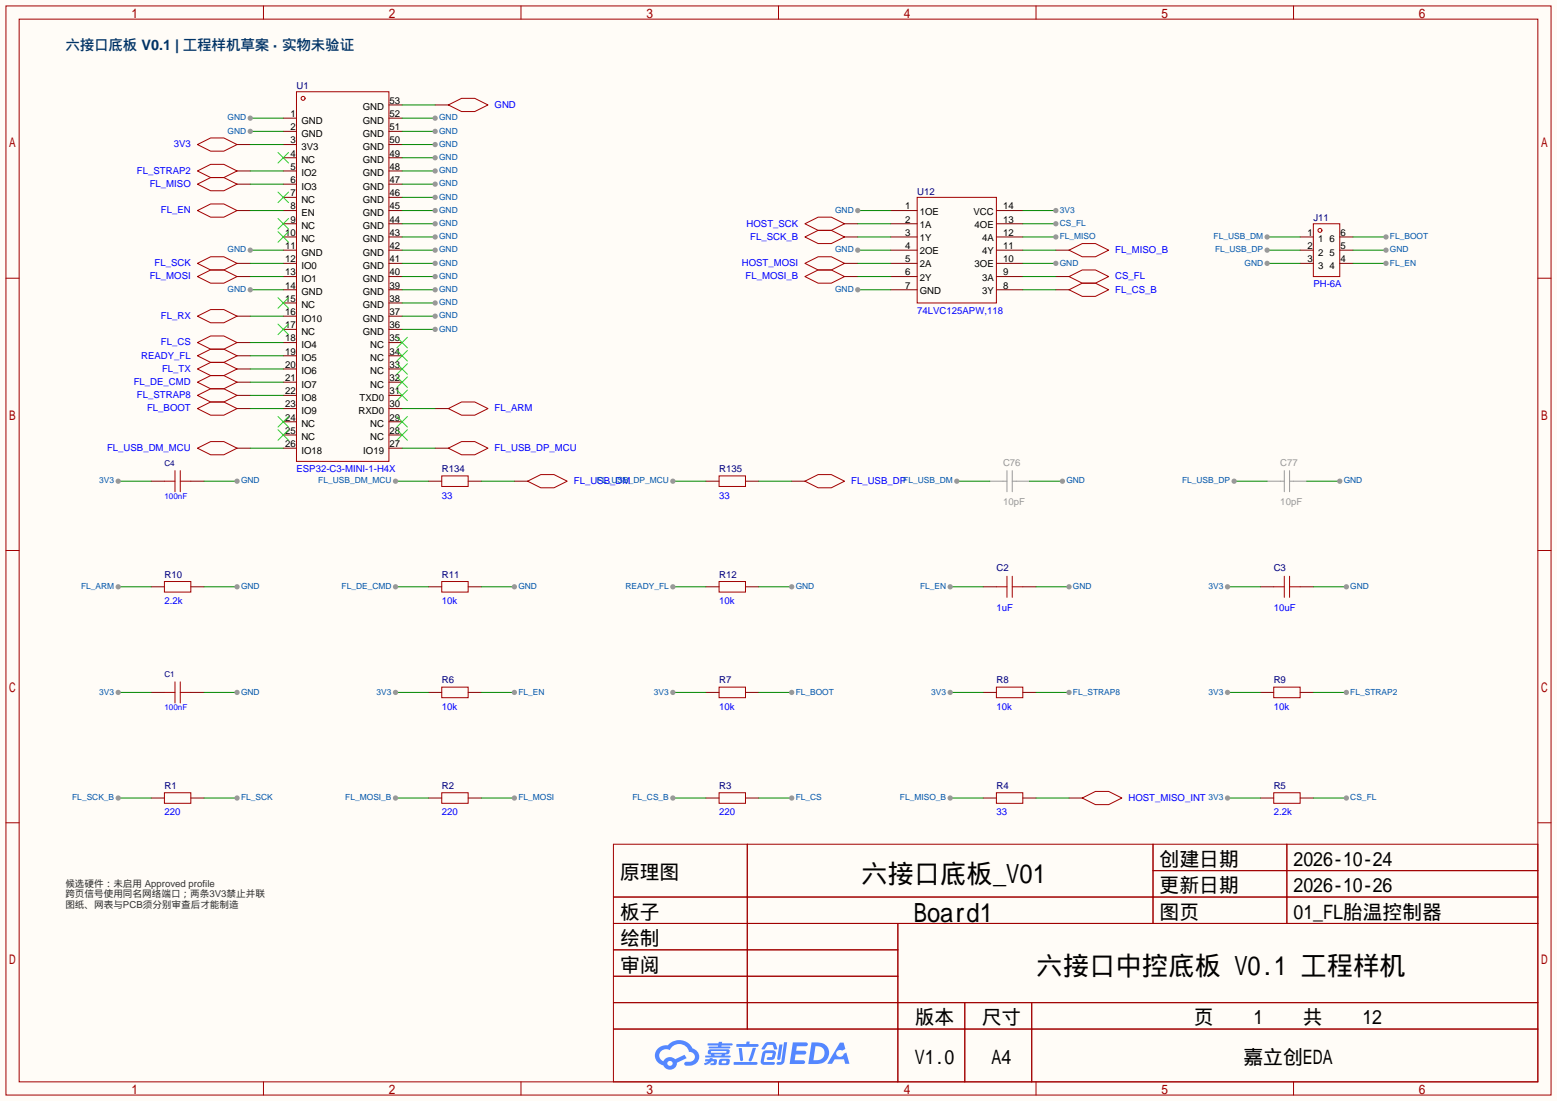
[picture p13: page 1]

原理图 | 六接口底板_V01 | 创建日期 | 2026-10-24

候选硬件：未启用 Approved profile
跨页信号使用同名网络端口；两条3V3禁止并联
图纸、网表与PCB须分别审查后才能制造

更新日期 | 2026-10-26

板子 | Board1 | 图页 | 01_FL胎温控制器
绘制 | | 六接口中控底板 V0.1 工程样机
审阅

V1.0 | A4 | 嘉立创EDA

IO0 27 IO35 28 IO36 29 IO37 30 IO38 31 IO39 32 IO40 33 IO41 34 IO42 35 RXD0 36 TXD0 37 IO2 38 IO1 39 GND 40

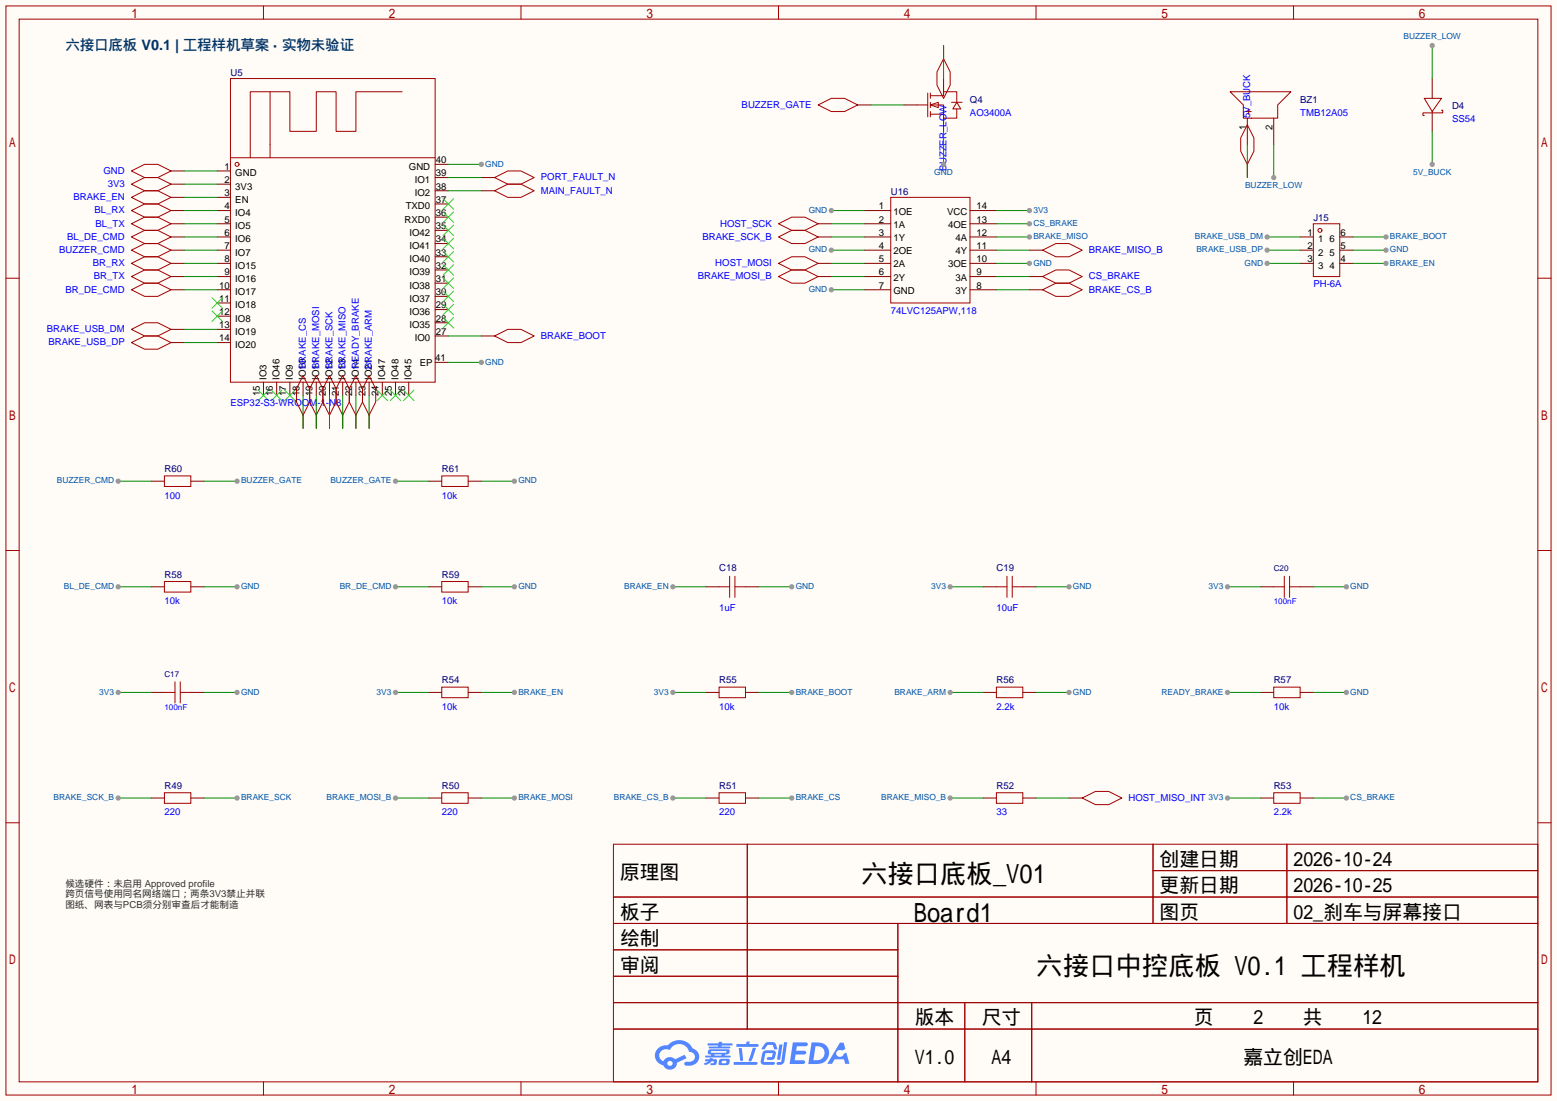
[picture p14: page 2]

原理图 | 六接口底板_V01 | 创建日期 | 2026-10-24

候选硬件：未启用 Approved profile
跨页信号使用同名网络端口；两条3V3禁止并联
图纸、网表与PCB须分别审查后才能制造

更新日期 | 2026-10-25

板子 | Board1 | 图页 | 02_刹车与屏幕接口
绘制 | | 六接口中控底板 V0.1 工程样机
审阅

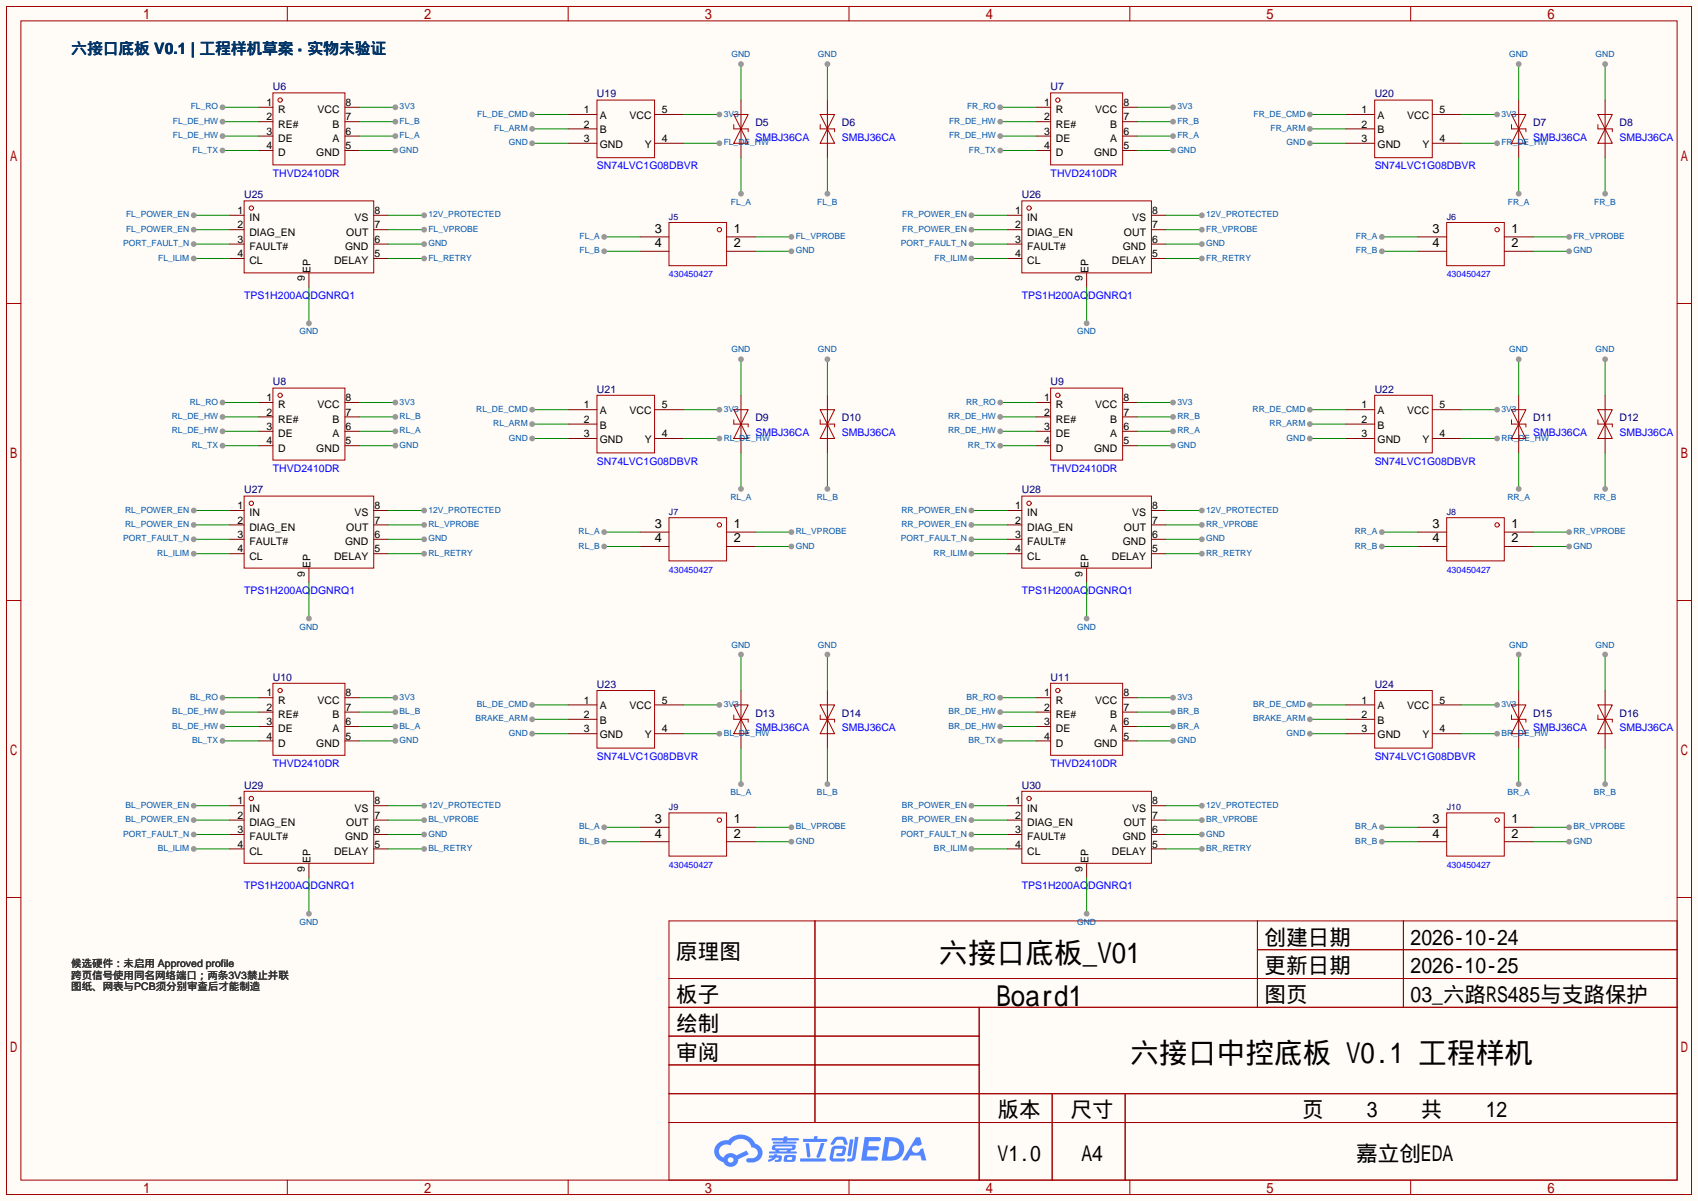
[picture p15: page 3]

原理图 | 六接口底板_V01 | 创建日期 | 2026-10-24

候选硬件：未启用 Approved profile
跨页信号使用同名网络端口；两条3V3禁止并联
图纸、网表与PCB须分别审查后才能制造

更新日期 | 2026-10-25

板子 | Board1 | 图页 | 03_六路RS485与支路保护
绘制 | | 六接口中控底板 V0.1 工程样机
审阅

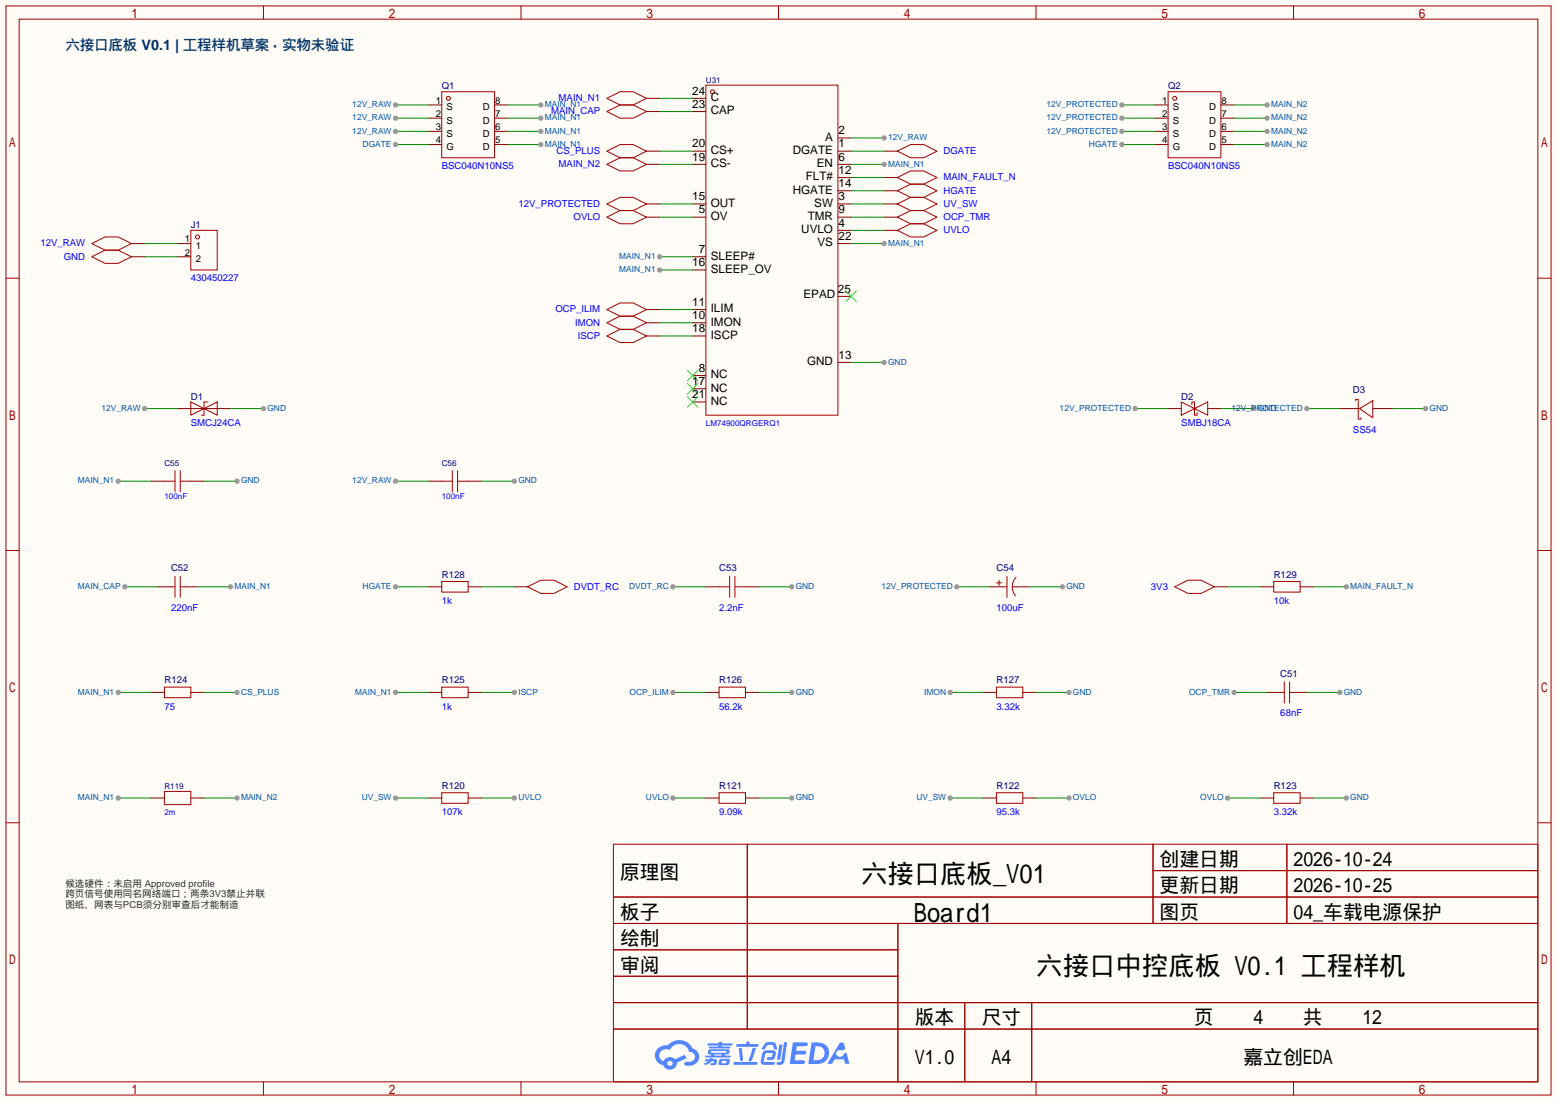
[picture p16: page 4]

原理图 | 六接口底板_V01 | 创建日期 | 2026-10-24

候选硬件：未启用 Approved profile
跨页信号使用同名网络端口；两条3V3禁止并联
图纸、网表与PCB须分别审查后才能制造

更新日期 | 2026-10-25

板子 | Board1 | 图页 | 04_车载电源保护
绘制 | | 六接口中控底板 V0.1 工程样机
审阅

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

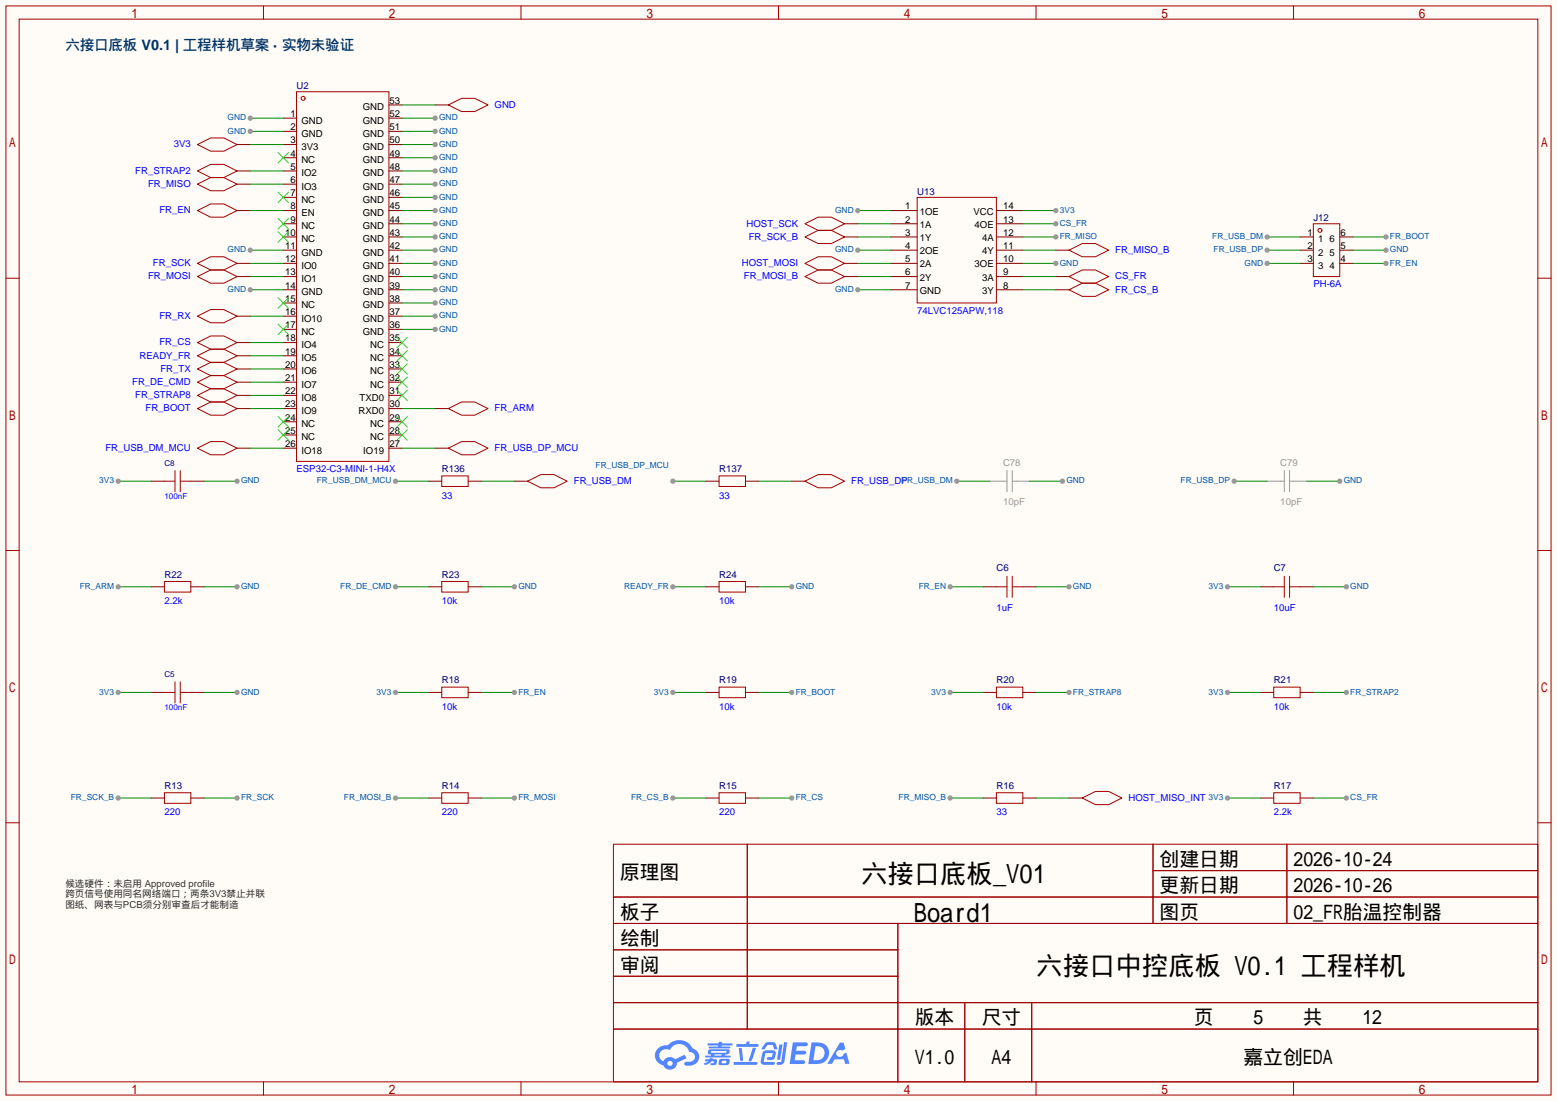
[picture p17: page 5]

原理图 | 六接口底板_V01 | 创建日期 | 2026-10-24

候选硬件：未启用 Approved profile
跨页信号使用同名网络端口；两条3V3禁止并联
图纸、网表与PCB须分别审查后才能制造

更新日期 | 2026-10-26

板子 | Board1 | 图页 | 02_FR胎温控制器
绘制 | | 六接口中控底板 V0.1 工程样机
审阅

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

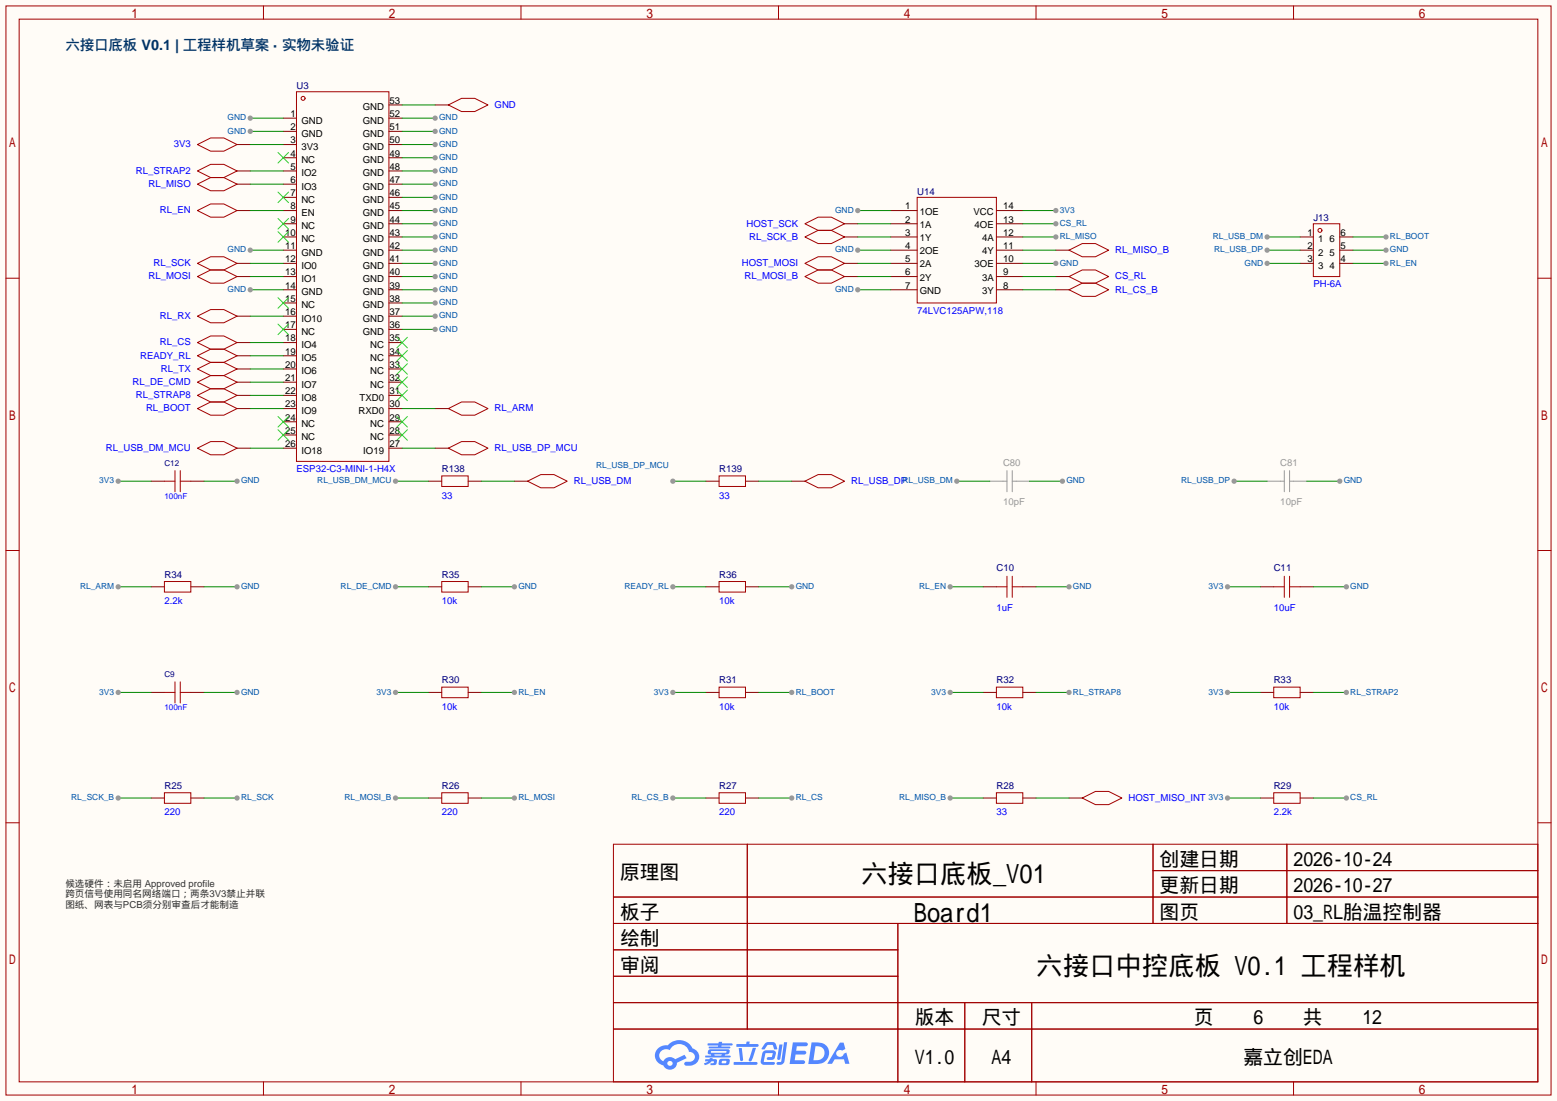
[picture p18: page 6]

原理图 | 六接口底板_V01 | 创建日期 | 2026-10-24

候选硬件：未启用 Approved profile
跨页信号使用同名网络端口；两条3V3禁止并联
图纸、网表与PCB须分别审查后才能制造

更新日期 | 2026-10-27

板子 | Board1 | 图页 | 03_RL胎温控制器
绘制 | | 六接口中控底板 V0.1 工程样机
审阅

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

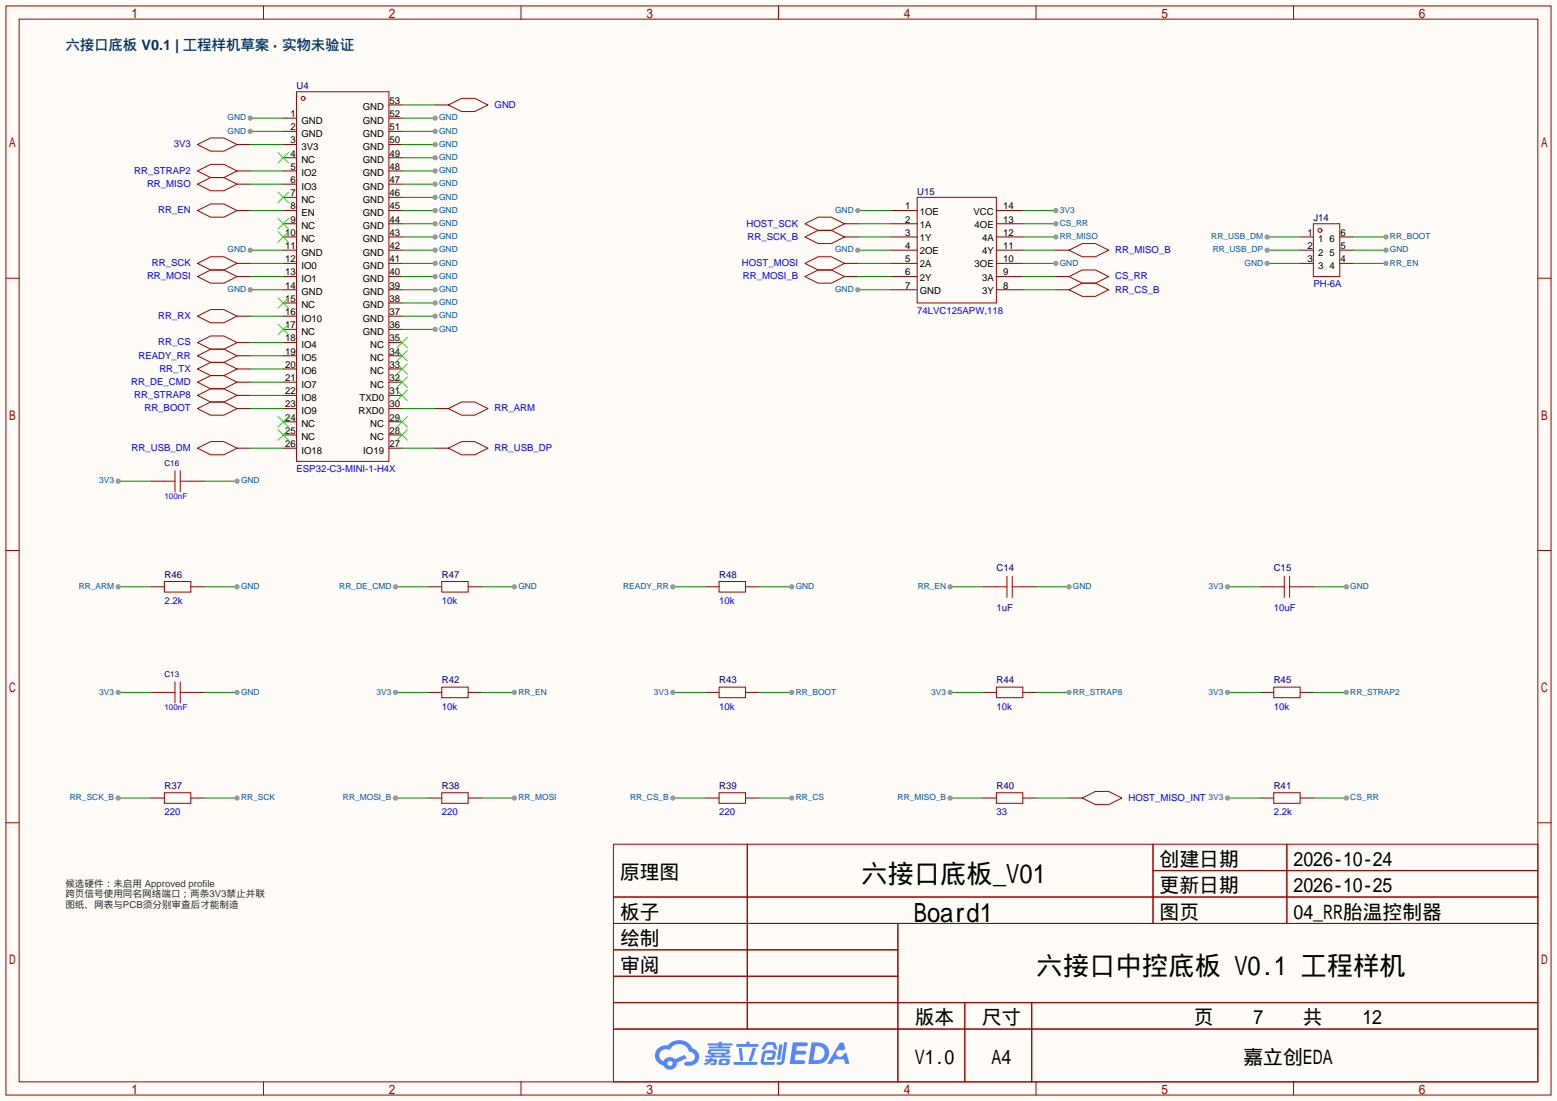
[picture p19: page 7]

原理图 | 六接口底板_V01 | 创建日期 | 2026-10-24

候选硬件：未启用 Approved profile
跨页信号使用同名网络端口；两条3V3禁止并联
图纸、网表与PCB须分别审查后才能制造

更新日期 | 2026-10-25

板子 | Board1 | 图页 | 04_RR胎温控制器
绘制 | | 六接口中控底板 V0.1 工程样机
审阅

# 11 D7 12 D6 13 D5 14 D4 15 VCC 16

# 2B2 10 2B1 11 1B2 12 1B1 13 2OE# 14 1OE# 15 VCCB 16

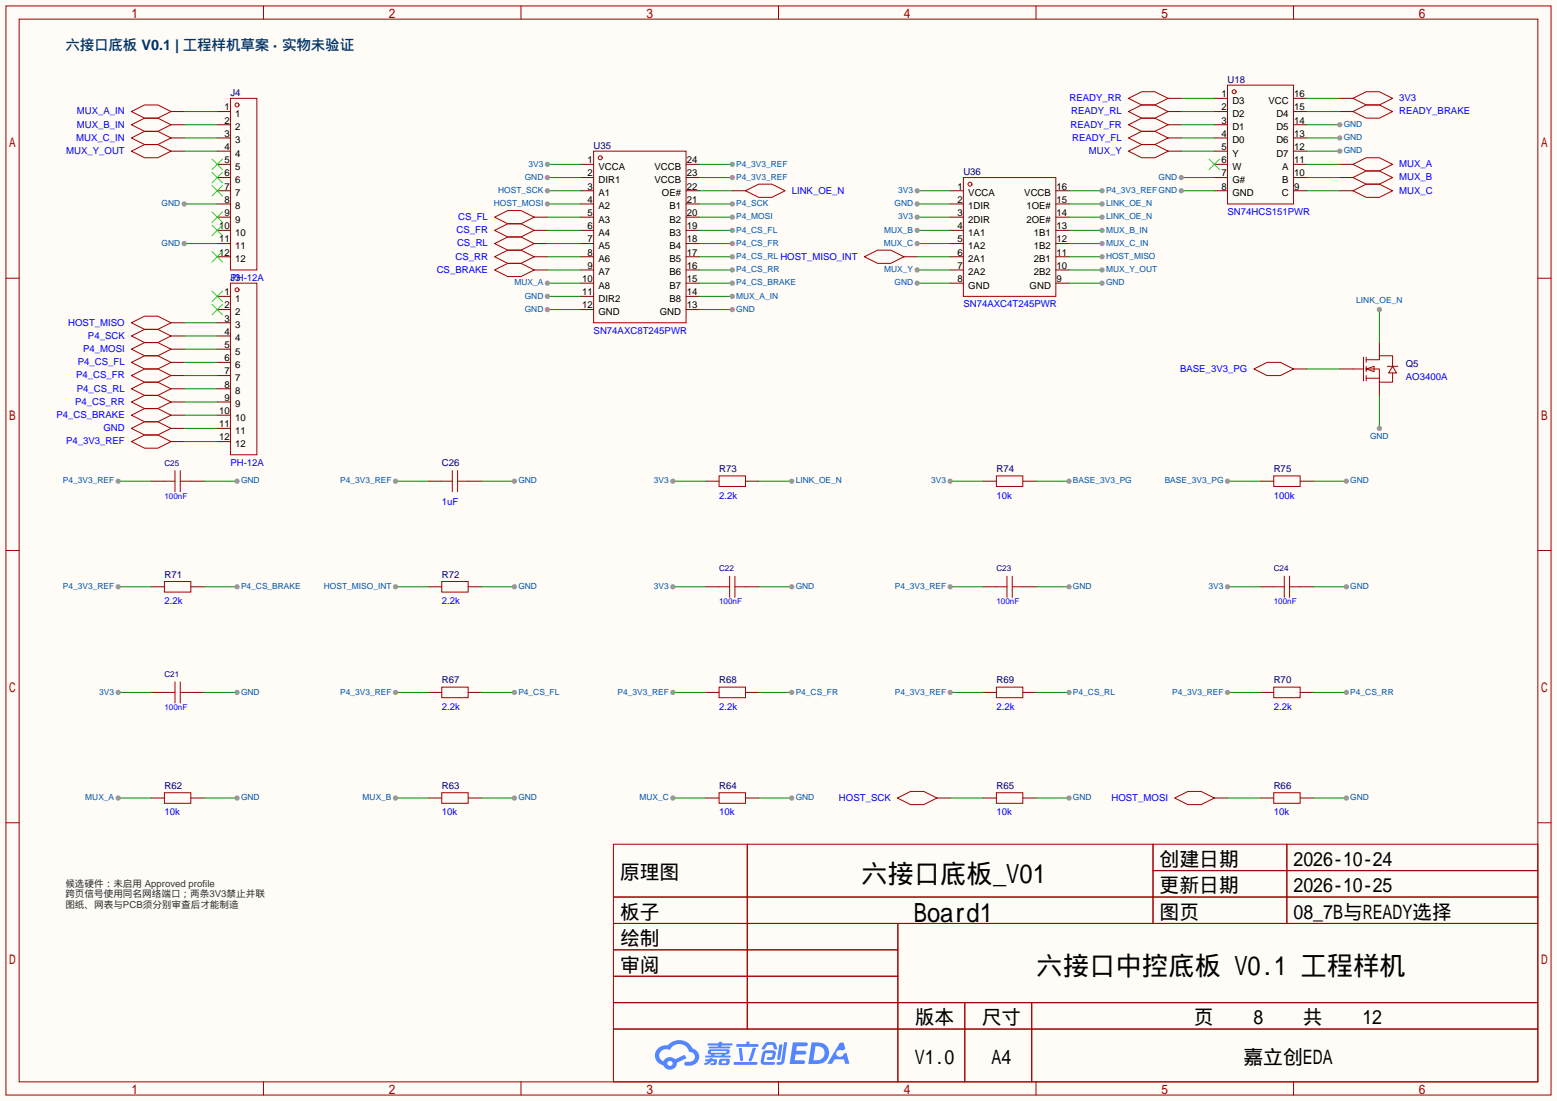
[picture p20: page 8]

原理图 | 六接口底板_V01 | 创建日期 | 2026-10-24

候选硬件：未启用 Approved profile
跨页信号使用同名网络端口；两条3V3禁止并联
图纸、网表与PCB须分别审查后才能制造

更新日期 | 2026-10-25

板子 | Board1 | 图页 | 08_7B与READY选择
绘制 | | 六接口中控底板 V0.1 工程样机
审阅

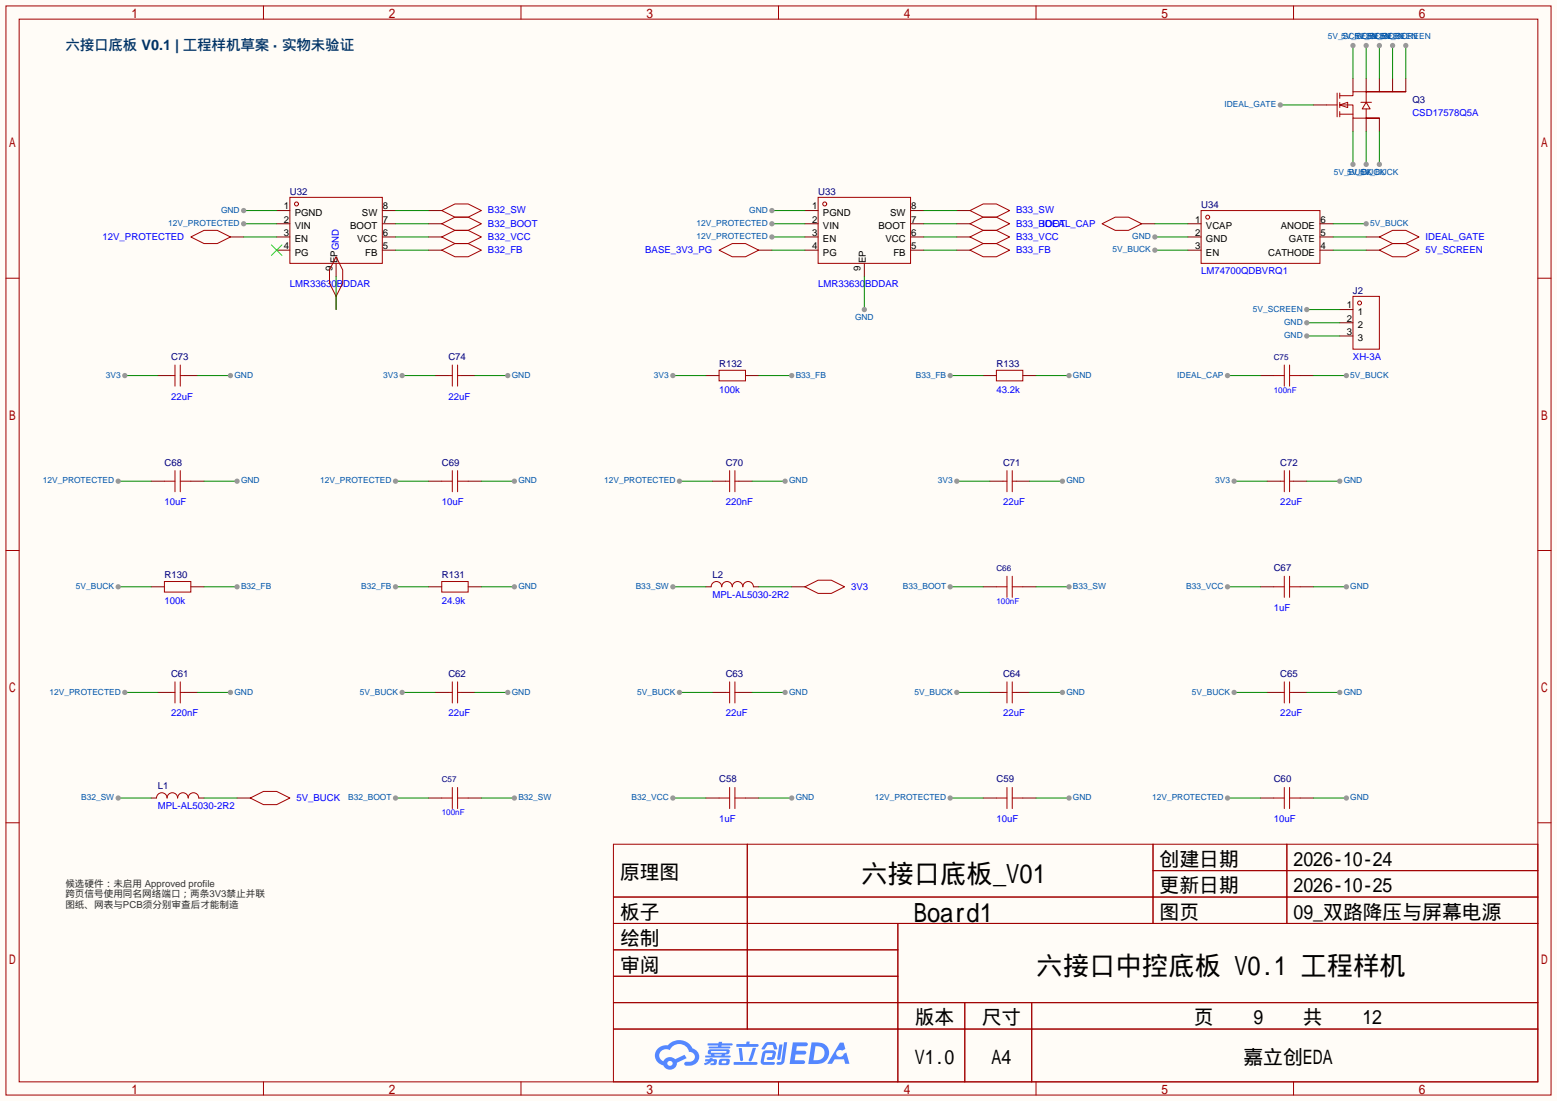
[picture p21: page 9]

原理图 | 六接口底板_V01 | 创建日期 | 2026-10-24

候选硬件：未启用 Approved profile
跨页信号使用同名网络端口；两条3V3禁止并联
图纸、网表与PCB须分别审查后才能制造

更新日期 | 2026-10-25

板子 | Board1 | 图页 | 09_双路降压与屏幕电源
绘制 | | 六接口中控底板 V0.1 工程样机
审阅

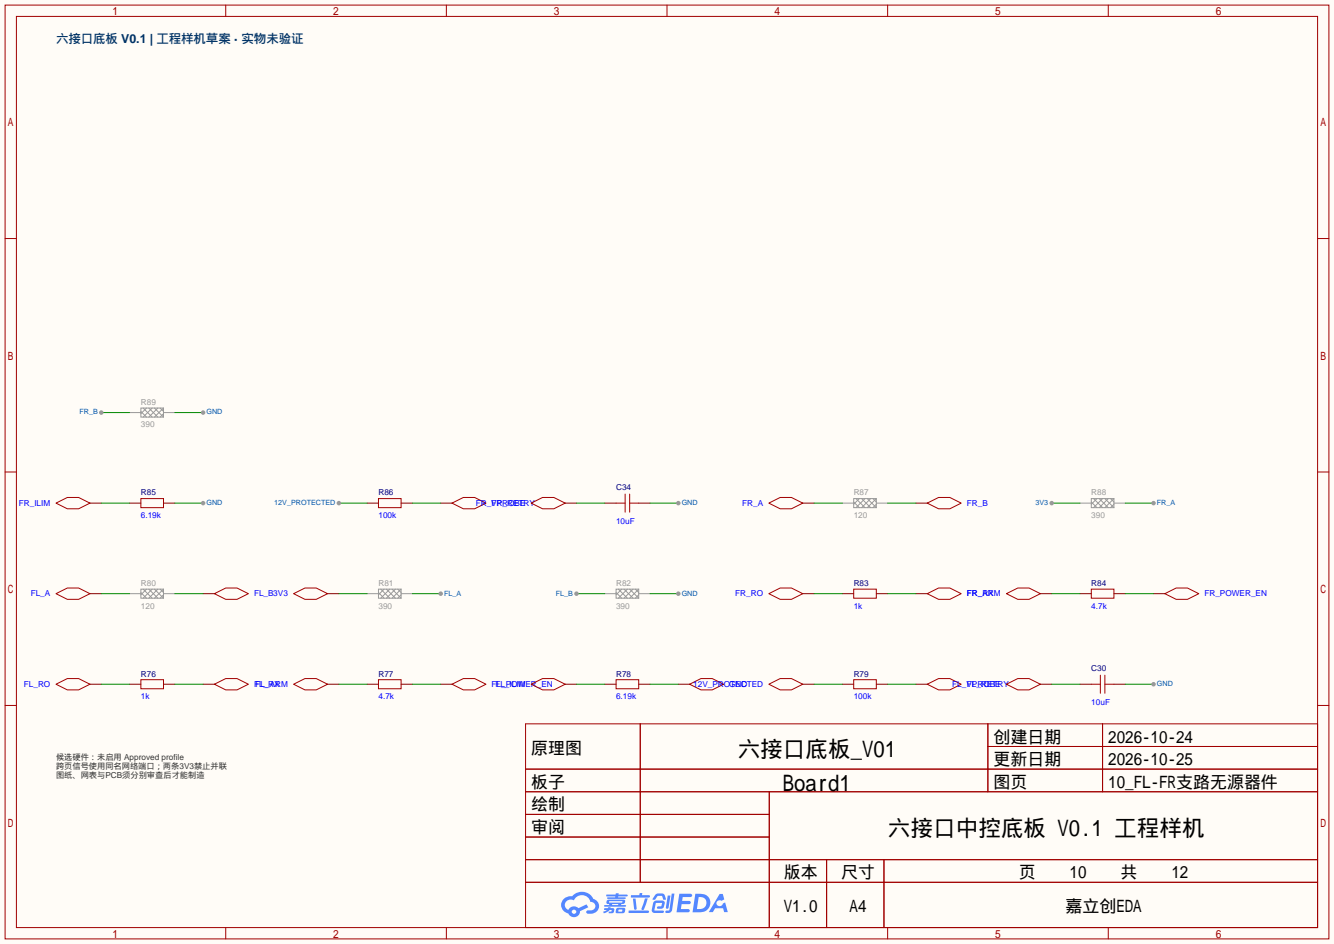
[picture p22: page 10]

原理图 | 六接口底板_V01 | 创建日期 | 2026-10-24

候选硬件：未启用 Approved profile
跨页信号使用同名网络端口；两条3V3禁止并联
图纸、网表与PCB须分别审查后才能制造

更新日期 | 2026-10-25

板子 | Board1 | 图页 | 10_FL-FR支路无源器件
绘制 | | 六接口中控底板 V0.1 工程样机
审阅

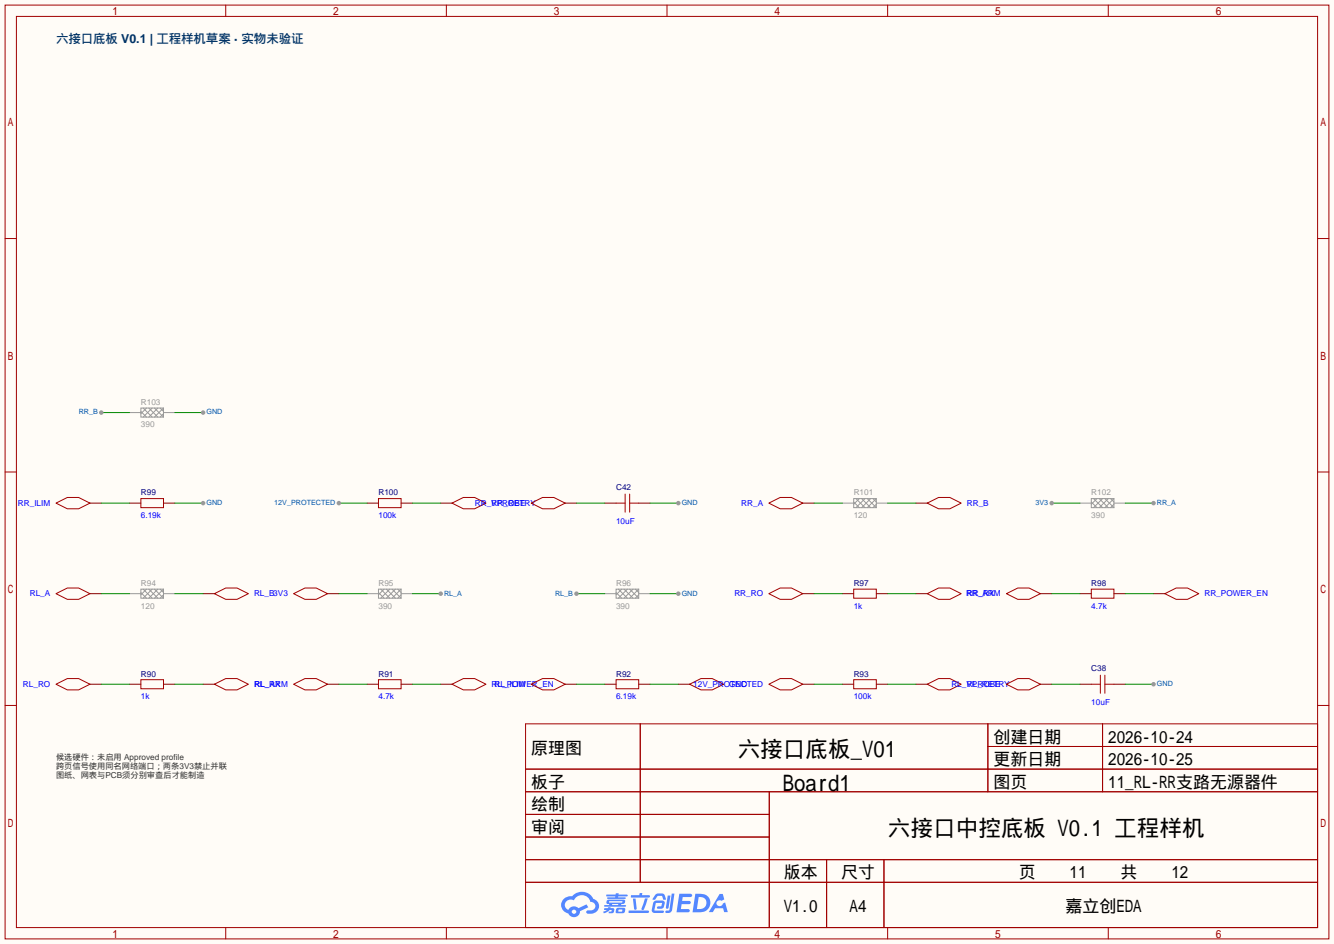
[picture p23: page 11]

原理图 | 六接口底板_V01 | 创建日期 | 2026-10-24

候选硬件：未启用 Approved profile
跨页信号使用同名网络端口；两条3V3禁止并联
图纸、网表与PCB须分别审查后才能制造

更新日期 | 2026-10-25

板子 | Board1 | 图页 | 11_RL-RR支路无源器件
绘制 | | 六接口中控底板 V0.1 工程样机
审阅

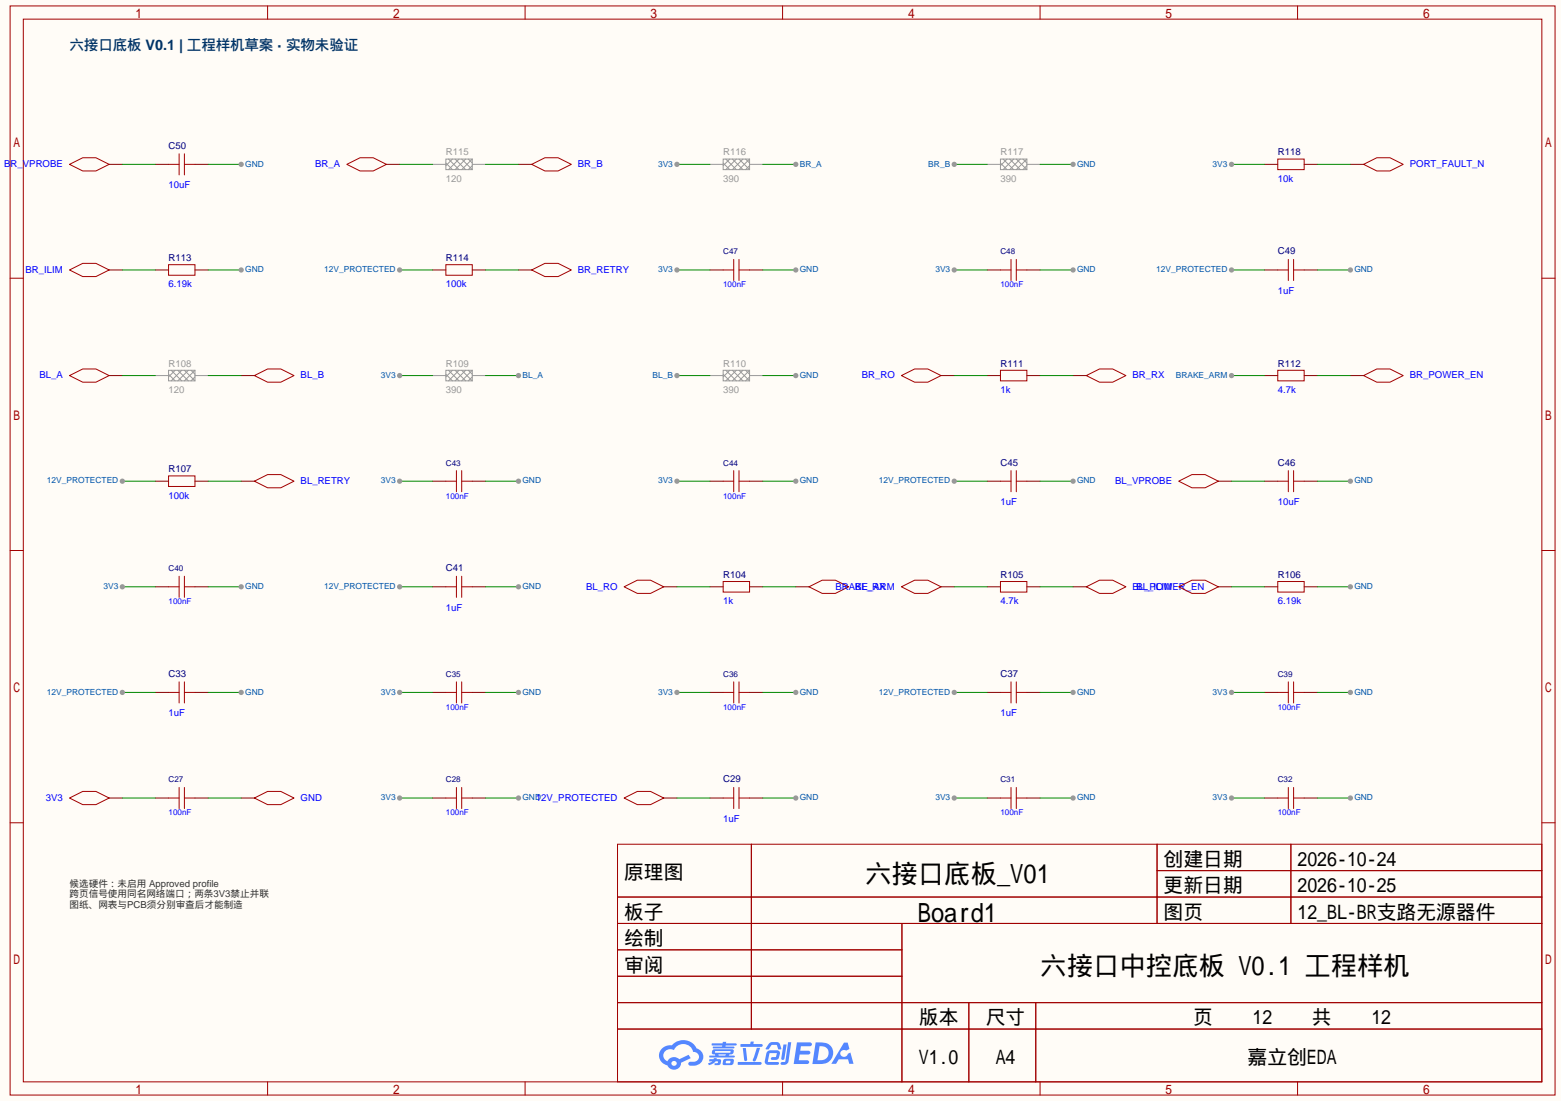
[picture p24: page 12]

原理图 | 六接口底板_V01 | 创建日期 | 2026-10-24

候选硬件：未启用 Approved profile
跨页信号使用同名网络端口；两条3V3禁止并联
图纸、网表与PCB须分别审查后才能制造

更新日期 | 2026-10-25

板子 | Board1 | 图页 | 12_BL-BR支路无源器件
绘制 | | 六接口中控底板 V0.1 工程样机
审阅
