zsw151515/Automotive-telemetry-equipment/hardware/brake_temp_12v_max31856/schematic/SCH_sch_brake_temp_12V_MAX31856_2026-05-22.pdf

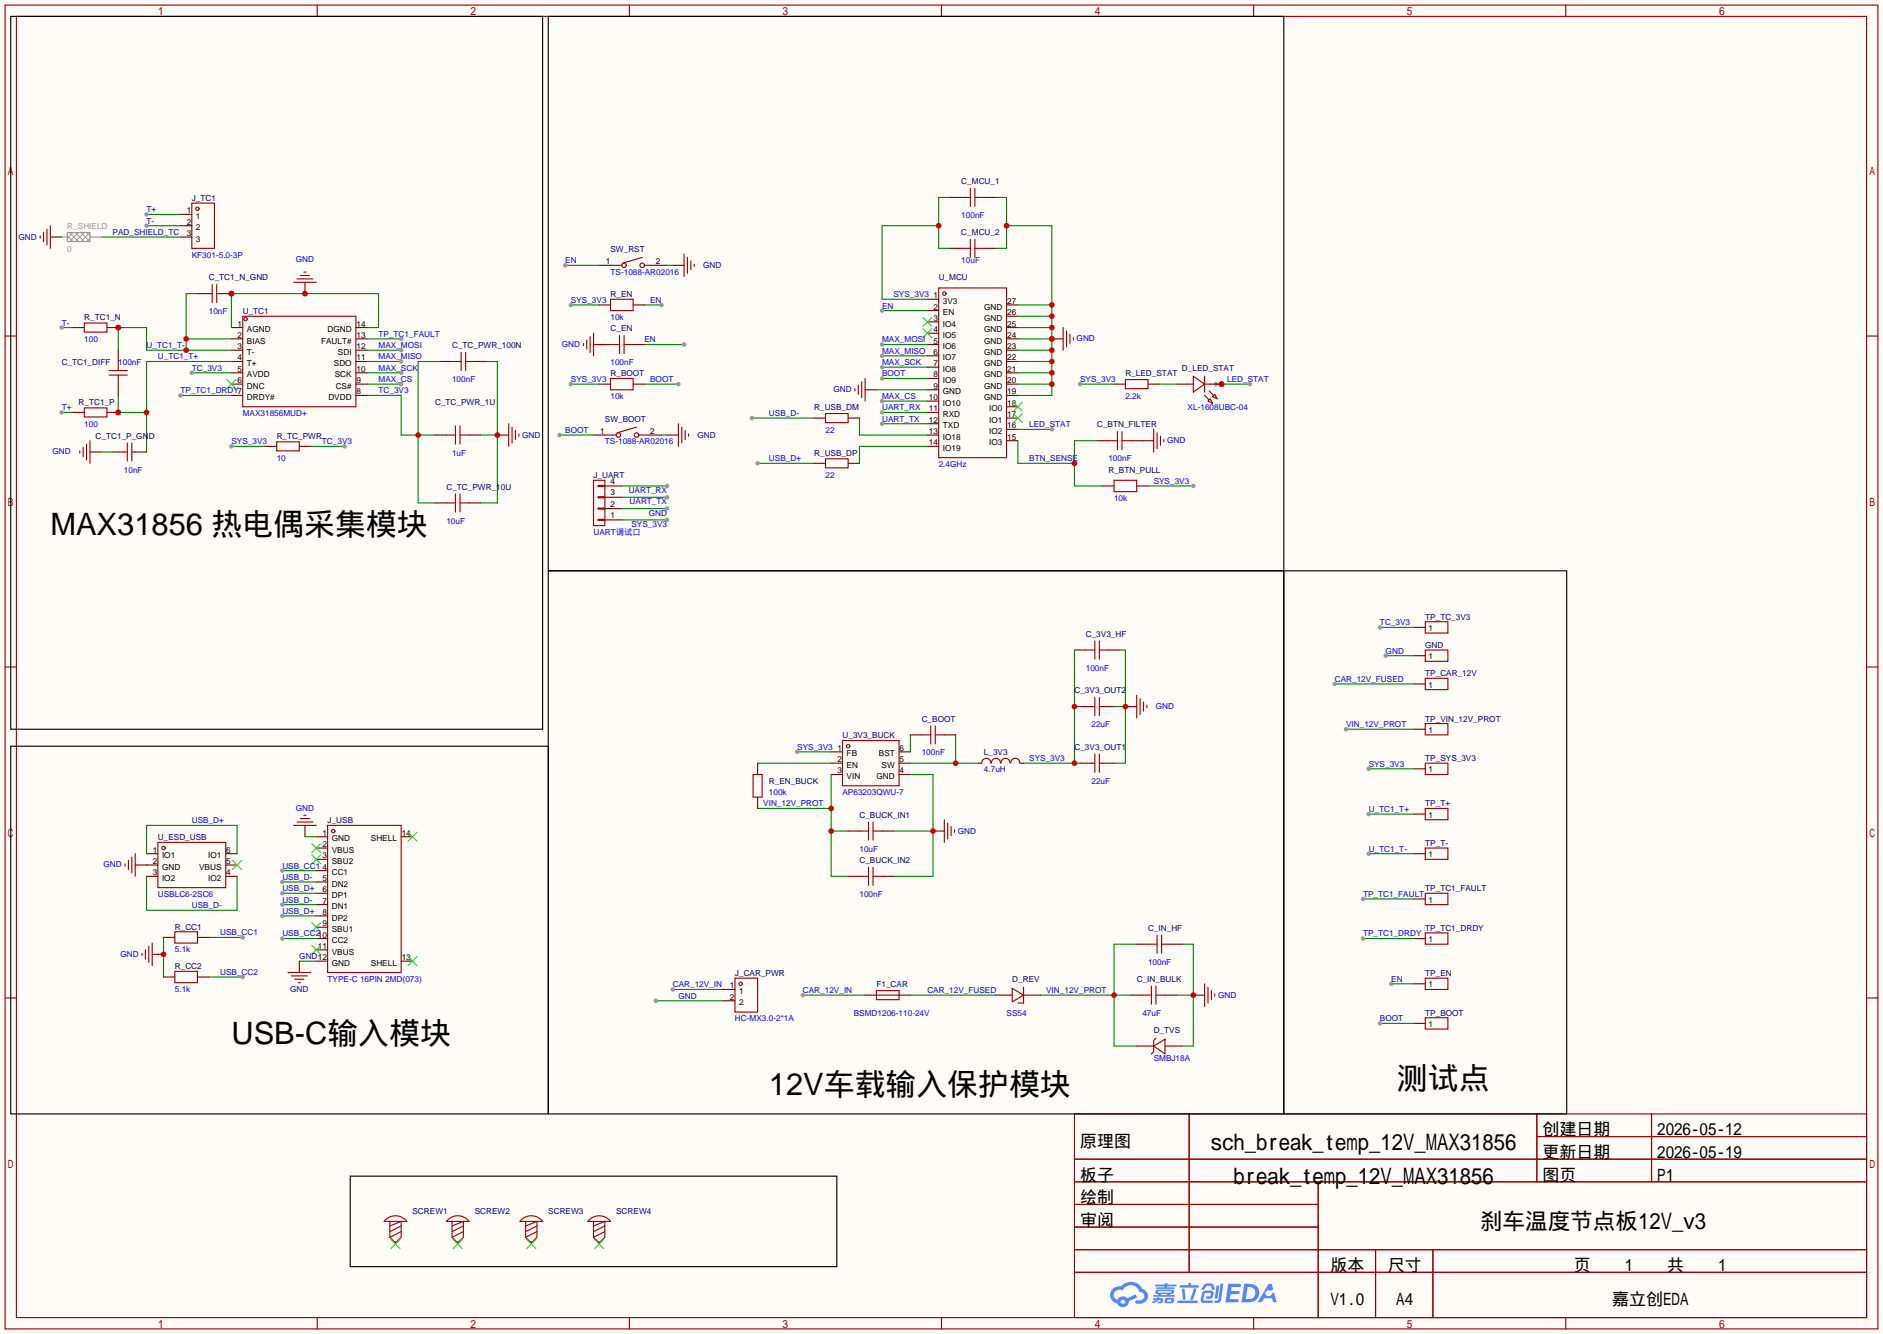
[picture p25: page 1]

SCK 10 SDO 11 SDI 12 FAULT# 13 DGND 14

原理图 | sch_break_temp_12V_MAX31856 | 创建日期 | 2026-05-12
板子 | break_temp_12V_MAX31856 | 图页 | P1
绘制 | | 刹车温度节点板12V_v3
审阅

更新日期 | 2026-05-19

V1.0 | A4 | 嘉立创EDA
