zsw151515/Automotive-telemetry-equipment/hardware/brake_temp_12v_rs485/schematic/SCH_sch_brake_temp_12V_RS485_2026-05-19.pdf

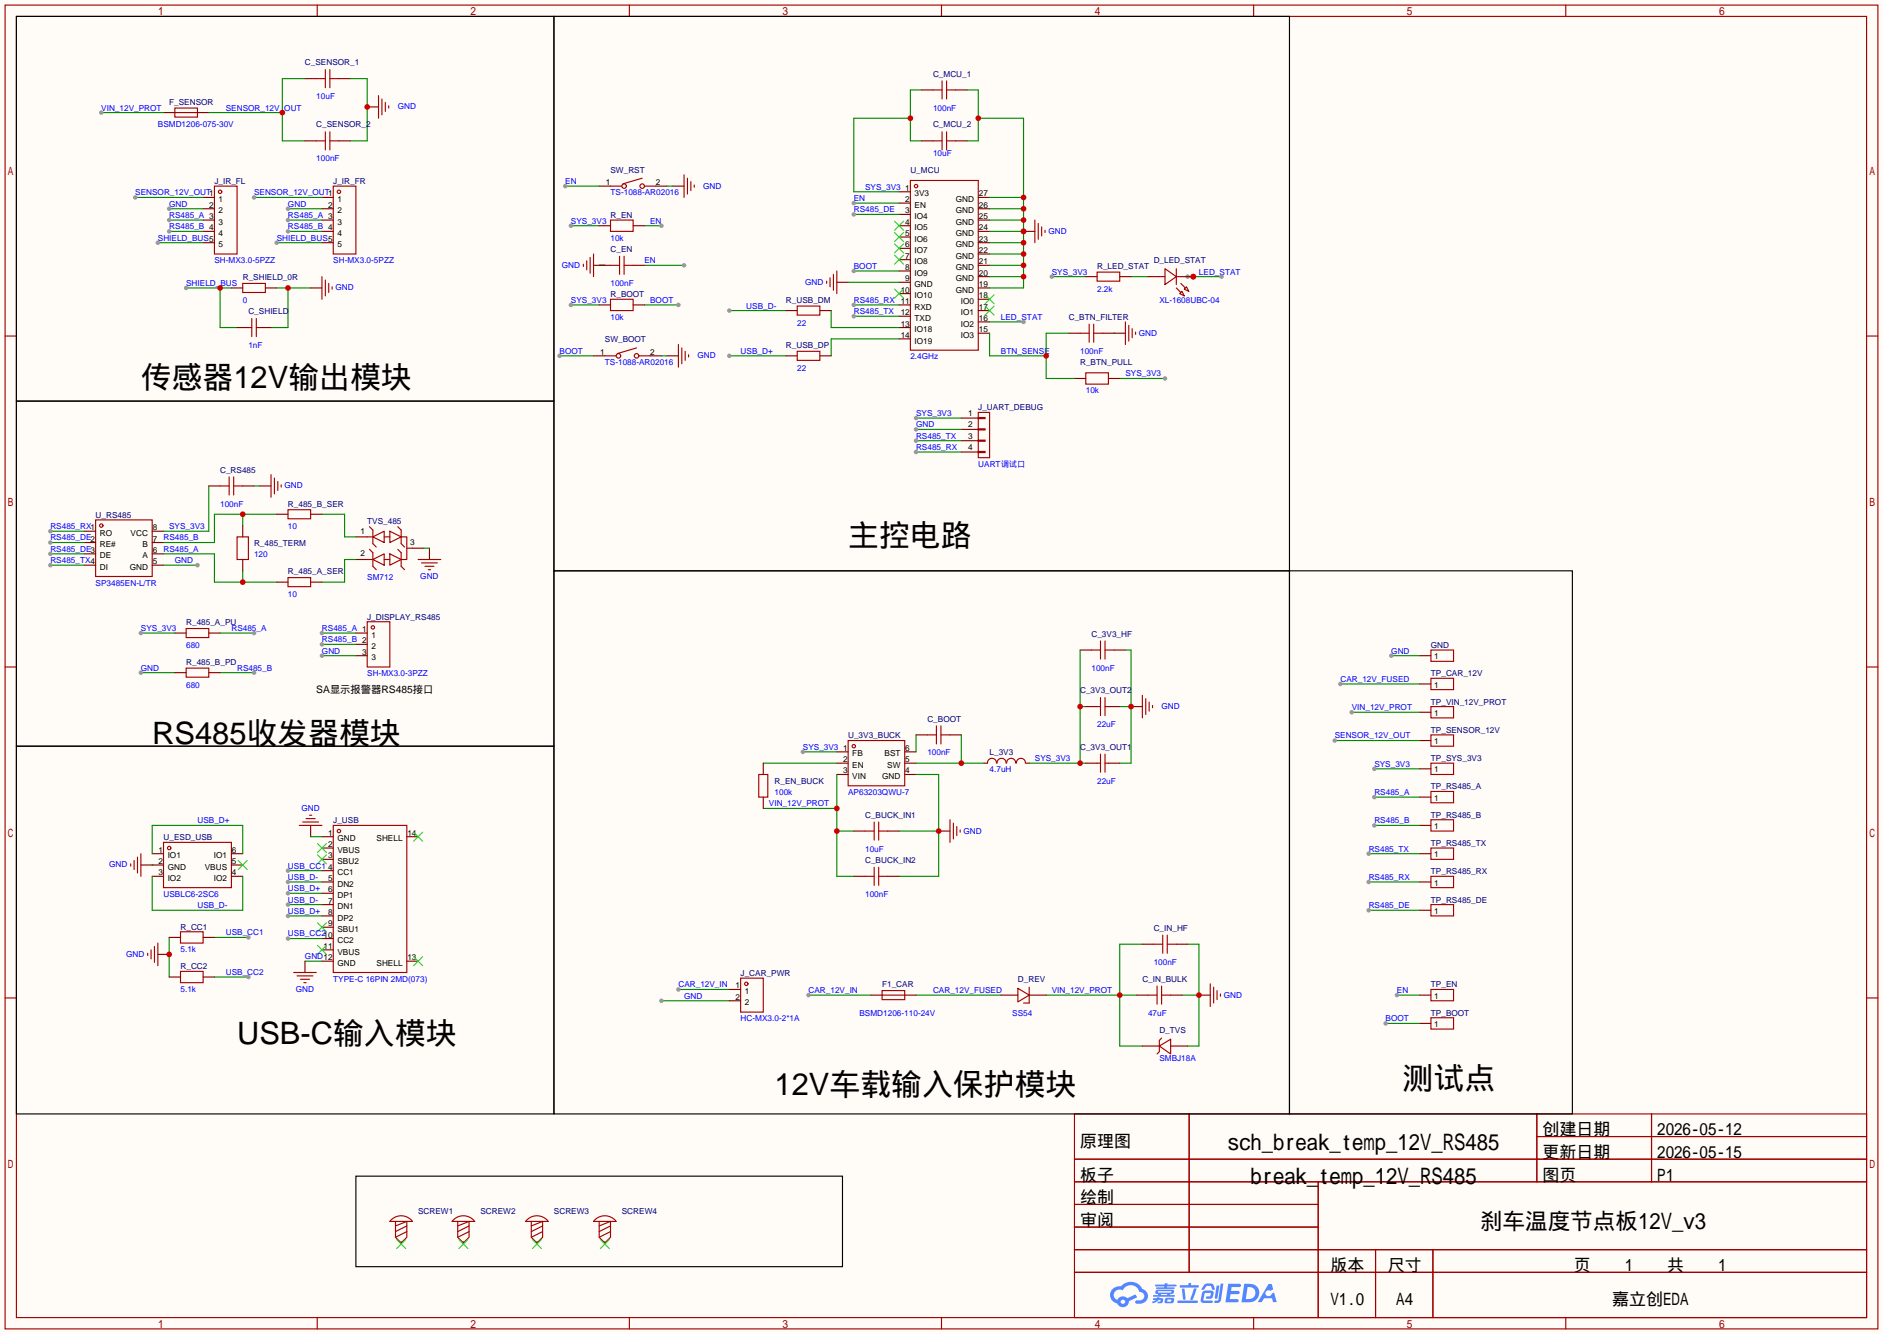
[picture p26: page 1]

原理图 | sch_break_temp_12V_RS485 | 创建日期 | 2026-05-12
板子 | break_temp_12V_RS485 | 图页 | P1
绘制 | | 刹车温度节点板12V_v3
审阅

更新日期 | 2026-05-15

V1.0 | A4 | 嘉立创EDA
