zsw151515/Automotive-telemetry-equipment/hardware/brake_temp_alarm_display_12v_rs485/schematic/SCH_sch_brake_temp_alarm_display_12V_RS485_2026-05-22.pdf

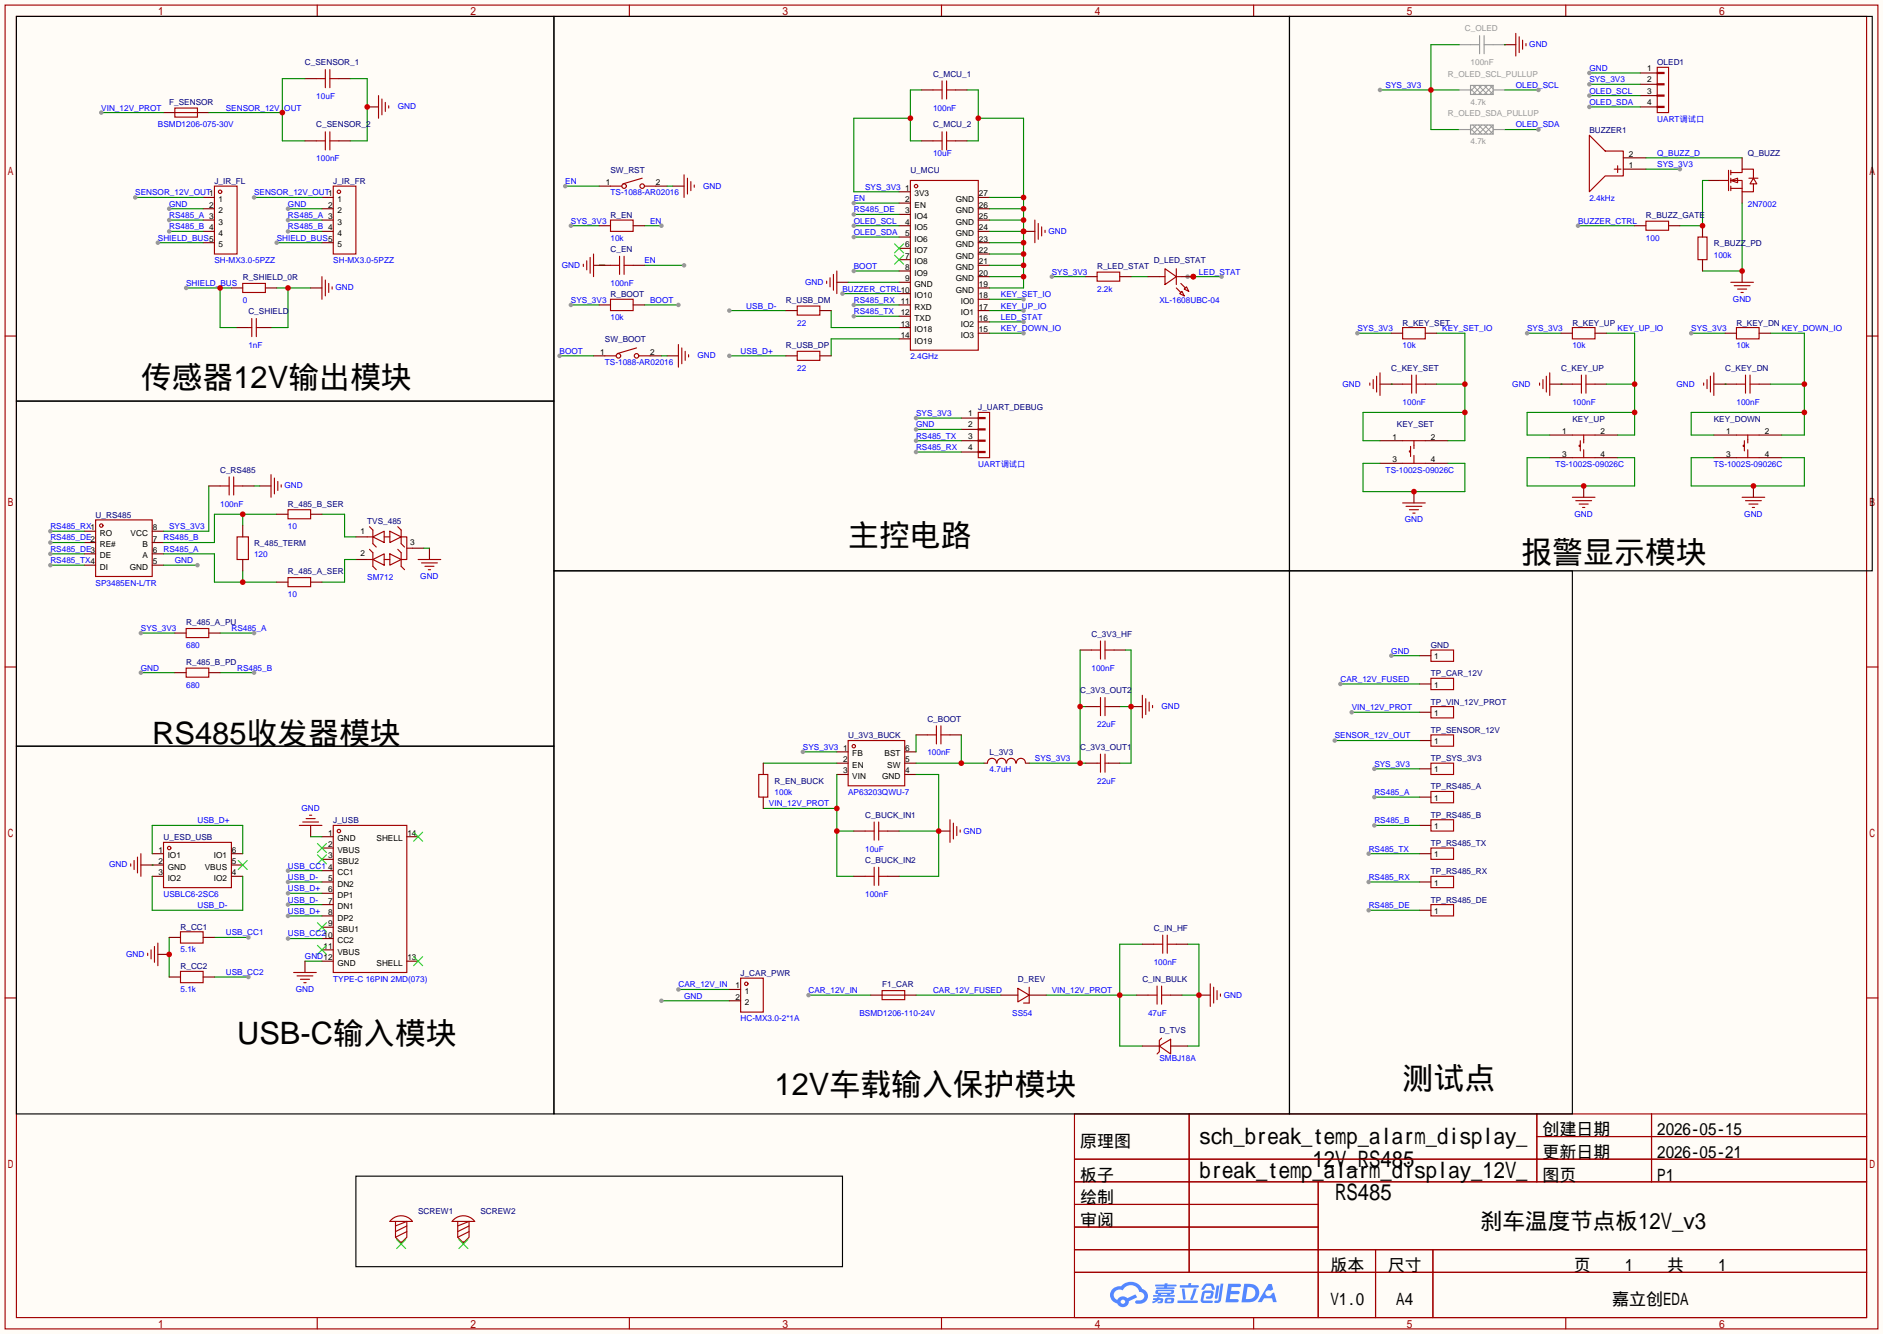
[picture p27: page 1]

原理图 | sch_break_temp_alarm_display_ 12V_RS485 | 创建日期 | 2026-05-15
板子 | break_temp_alarm_display_12V_ | 图页 | P1
绘制 | | RS485 刹车温度节点板12V_v3
审阅

更新日期 | 2026-05-21

V1.0 | A4 | 嘉立创EDA
