zsw151515/Automotive-telemetry-equipment/(list of files, drawings)

Other design files:
hardware/wired_tire_central/baseboard/eda/six-port-baseboard-v01.epro
hardware/wired_tire_central/baseboard/exports/pcb-connectivity-check.json
hardware/wired_tire_central/baseboard/exports/pcb-drc-summary.json
hardware/wired_tire_central/baseboard/exports/pcb-readback.json
hardware/wired_tire_central/baseboard/exports/schematic-drc.json
hardware/wired_tire_central/baseboard/pcb-layout.json
hardware/wired_tire_central/baseboard/schematic-model.json
