zsw151515/Automotive-telemetry-equipment/(commit log)

2026-05-27 docs: 初始化中文项目说明
2026-05-27 docs: 添加 Codex 中文项目规则
2026-05-27 docs: 添加 Codex Agent 工作规则
2026-05-27 docs: 添加项目背景说明
2026-05-27 docs: 添加硬件版本说明
2026-05-27 docs: 添加固件结构与命名规范
2026-05-27 docs: 添加 RaceChrono BLE 说明
2026-05-27 docs: 添加已知硬件问题排查记录
2026-05-27 docs: 添加测试与交付检查清单
2026-05-27 docs: 添加 Git 与 Codex 协作流程
2026-05-27 docs: 补充 12V RS485 刹车节点双输出说明
2026-05-27 docs: 更新 README 增加 12V RS485 RaceChrono 说明
2026-05-27 docs: 更新 CODEX 增加 12V RS485 RaceChrono 规则
2026-05-27 chore: 创建固件目录骨架
2026-05-27 chore: 创建胎温高度 v2 固件目录
2026-05-27 chore: 创建胎温高度 v3 固件目录
2026-05-27 chore: 创建 12V MAX31856 固件目录
2026-05-27 chore: 创建 12V RS485 RaceChrono 节点固件目录
2026-05-27 chore: 创建 12V RS485 报警显示固件目录
2026-05-27 chore: 创建中控显示固件目录
2026-05-27 chore: 创建硬件目录骨架
2026-05-27 chore: 创建胎温高度 v2 硬件目录
2026-05-27 chore: 创建 v2 schematic 目录
2026-05-27 chore: 创建 v2 pcb 目录
2026-05-27 chore: 创建 v2 gerber 目录
2026-05-27 chore: 创建 v2 bom 目录
2026-05-27 chore: 创建 v2 3d 目录
2026-05-27 chore: 创建 v2 notes 目录
2026-05-27 docs: 标记胎温高度 v2 为历史测试板
2026-05-27 chore: 创建胎温高度 v3 硬件目录
2026-05-27 chore: 创建 v3 schematic 目录
2026-05-27 chore: 创建 v3 pcb 目录
2026-05-27 chore: 创建 v3 gerber 目录
2026-05-27 chore: 创建 v3 bom 目录
2026-05-27 chore: 创建 v3 3d 目录
2026-05-27 chore: 创建 v3 notes 目录
2026-05-27 chore: 创建 12V RS485 刹车温度硬件目录
2026-05-27 chore: 创建 12V RS485 schematic 目录
2026-05-27 chore: 创建 12V RS485 pcb 目录
2026-05-27 chore: 创建 12V RS485 gerber 目录
2026-05-27 chore: 创建 12V RS485 bom 目录
2026-05-27 chore: 创建 12V RS485 3d 目录
2026-05-27 chore: 创建 12V RS485 notes 目录
2026-05-27 docs: 区分 RS485 报警显示版本和 MAX31856 版本
2026-05-27 docs: 明确卡钳热电偶与刹车盘RS485红外版本边界
2026-05-27 docs: 明确 RS485 版本测刹车盘且使用红外传感器
2026-05-27 docs: 明确 RS485 红外刹车盘版本与 MAX31856 卡钳版本边界
2026-05-27 docs: 明确 MAX31856 版本为热电偶卡钳测温
2026-05-27 docs: 明确 RS485 报警显示版本为红外刹车盘测温
2026-05-27 docs: 明确硬件目录为RS485红外刹车盘测温系统
2026-05-27 new file: firmware/tire_temp_height_node_v3/tire_temp_height_node_racechrono_fast_clean_v3.ino.ino
2026-05-27 docs: 添加胎温高度v3 BLE only 固件说明
2026-05-27 docs: 更新胎温高度v3为RaceChrono BLE only主线
2026-05-27 docs: 更新胎温高度v3为RaceChrono BLE only规则
2026-05-27 docs: 更新v3固件目录为BLE only主线
2026-05-27 docs: 更新硬件版本说明中的v3通信定位
2026-05-27 docs: 重新梳理刹车节点三个版本边界
2026-05-27 docs: 明确刹车节点三个版本边界
2026-05-27 docs: 更新固件目录说明移除不存在版本
2026-05-27 docs: 更新硬件目录说明区分刹车RS485初代和报警显示版
2026-05-27 docs: 标记brake_temp_12v_rs485为初代无显示报警版本
2026-05-27 chore: 创建当前刹车报警显示硬件目录
2026-05-27 chore: 创建报警显示版 schematic 目录
2026-05-27 chore: 创建报警显示版 pcb 目录
2026-05-27 chore: 创建报警显示版 gerber 目录
2026-05-27 chore: 创建报警显示版 bom 目录
2026-05-27 chore: 创建报警显示版 3d 目录
2026-05-27 chore: 创建报警显示版 notes 目录
2026-05-27 chore: 删除不存在的 rs485 racechrono node 占位版本
2026-05-27 modified: CODEX.md modified: "docs/09_\350\203\216\346\270\251\351\253\230\345\272\246v3_RaceChrono_BLE_ONLY\350\257\264\346\230\216.md" new file: firmware/brake_temp_12v_max31856/node_break_temp_12V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
2026-05-27 chore: 创建 MAX31856 卡钳测温硬件目录
2026-05-27 chore: 创建 MAX31856 schematic 目录
2026-05-27 chore: 创建 MAX31856 pcb 目录
2026-05-27 chore: 创建 MAX31856 gerber 目录
2026-05-27 chore: 创建 MAX31856 bom 目录
2026-05-27 chore: 创建 MAX31856 3d 目录
2026-05-27 chore: 创建 MAX31856 notes 目录
2026-05-27 docs: 在硬件目录总览中加入 MAX31856 版本
2026-05-27 new file: hardware/brake_temp_12v_max31856/schematic/SCH_sch_break_temp_12V_MAX31856_2026-05-22.pdf new file: hardware/brake_temp_12v_rs485/schematic/SCH_sch_break_temp_12V_RS485_2026-05-19.pdf new f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
2026-05-27 new file: hardware/tire_temp_height_v3/schematic/SCH_sch_tire_tempe_height_v3_small_2026-05-27.pdf
2026-05-27 docs: 添加文档同步规则
2026-05-27 modified: "docs/02_\347\241\254\344\273\266\347\211\210\346\234\254\350\257\264\346\230\216.md" modified: "docs/08_12V_RS485\345\210\271\350\275\246\350\212\202\347\202\271\350\257\264\346\230\216.md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
2026-05-28 modified: firmware/brake_temp_alarm_display_12v_rs485/hyundai_n_brake_temp_alarm_display_12V_RS485.ino
2026-05-28 modified: "docs/08_12V_RS485\345\210\271\350\275\246\350\212\202\347\202\271\350\257\264\346\230\216.md" modified: firmware/brake_temp_alarm_display_12v_rs485/README.md modified: firmware/brake_temp_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
2026-05-29 modified: AGENTS.md modified: CODEX.md modified: README.md modified: "docs/04_RaceChrono_BLE\350\257\264\346\230\216.md" modified: "docs/08_12V_RS485\345\210\271\350\275\246\350\212\202\347\202\271\3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
2026-05-30 new file: hardware/brake_temp_alarm_display_12v_rs485/3d/3D_pcb_brake_temp_alarm_display_12V_RS485_2026-05-30.step new file: hardware/brake_temp_alarm_display_12v_rs485/bom/BOM_brakek_temp_alarm_disp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
    [3D_pcb_brake_temp_alarm_display_12V_RS485_2026-05-30.step, BOM_brakek_temp_alarm_display_12V_RS485_pcb_brake_temp_alarm_display_12V_RS485_2026-05-30.xlsx]
2026-05-31 modified: CODEX.md modified: "docs/08_12V_RS485\345\210\271\350\275\246\350\212\202\347\202\271\350\257\264\346\230\216.md" modified: firmware/brake_temp_alarm_display_12v_rs485/README.md modified: f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
2026-10-22 docs: 添加四路有线胎温中控设计规格
2026-10-22 docs: 添加四路有线胎温中控实施计划
2026-10-22 chore: 忽略隔离开发工作区
2026-10-22 firmware: 添加有线胎温帧解析核心
2026-10-22 tools: 添加胎温探头只读抓包工具
2026-10-22 firmware: 添加有线胎温八分区处理
2026-10-22 firmware: 添加独立RS485胎温采集固件
2026-10-22 firmware: 接入单轮RaceChrono热图输出
2026-10-22 firmware: 添加中控SPI热图快照协议
2026-10-22 firmware: 接入四路SPI快照采集
2026-10-22 firmware: 添加七英寸四轮完整热图界面与离线链接检查
2026-10-22 docs: 完善有线胎温中控离线交付与构建说明
2026-10-22 fix: 拒绝超期胎温响应并修复BLE恢复与热图镜像
2026-10-22 docs: 记录离线验证与最终审查修复
2026-10-24 docs: 调整为7B显示套件与四接口底板同壳方案
2026-10-24 docs: 定义六接口胎温刹车触屏中控方案
2026-10-24 docs: 制定六接口中控增量计划与7B资源审查
2026-10-24 docs: 核对六口中控板级资源与依赖
2026-10-24 firmware: 添加双路刹车只读采集核心
2026-10-24 firmware: 移植刹车热模型与独立蜂鸣状态机
2026-10-24 firmware: 添加刹车设置确认与可恢复存储核心
2026-10-24 firmware: 添加刹车状态与设置板间协议
2026-10-24 firmware: 添加独立刹车RaceChrono协议核心
2026-10-24 firmware: 添加六口底板双刹车控制固件
2026-10-24 firmware: 接入五从机调度与刹车控制回执
2026-10-24 firmware: 添加胎温刹车触屏页面与设置状态机
2026-10-24 firmware: 适配微雪7B显示触摸与六口主控入口
2026-10-24 docs: 补齐六口硬件关卡与离线交付工具
2026-10-24 fix: 修复六口控制会话重放与设置结果确认
2026-10-24 docs: 完成六接口中控离线交付与验证说明
2026-10-24 docs: 区分中控工程样机与最终定版关卡
2026-10-24 hardware: 添加7B六接口中控长方形试装外壳
    [body.stl, central_case.scad, rear_cover.stl, rear_cover_pilot.stl, retainer.stl]
2026-10-24 docs: 记录嘉立创EDA官方技能与本机桥接接入
2026-10-25 hardware: 建立六接口底板原理图与局部电源布线
    [pcb-connectivity-check.json, pcb-drc-summary.json, pcb-layout.json, pcb-placement.csv, pcb-readback.json, pinmap.csv, schematic-drc.json, schematic-model.json]
2026-10-25 hardware: 推进六接口底板布线并同步试装后盖
    [body.stl, central_case.scad, pcb-connectivity-check.json, pcb-drc-summary.json, pcb-layout.json, pcb-placement.csv, pcb-readback.json, pcb_mechanical.scad]
2026-10-25 hardware: 补充六接口底板电源支路与地线布线
    [pcb-drc-summary.json, schematic-drc.json, six-port-baseboard-v01.epro]
2026-10-25 hardware: 调整主保护采样布线并补齐S3局部接地
    [body.stl, pcb-connectivity-check.json, pcb-drc-summary.json, pcb-layout.json, pcb-placement.csv, pcb-readback.json, rear_cover.stl, rear_cover_pilot.stl]
2026-10-25 hardware: 完成主保护左侧扇出与逻辑供电接地
    [body.stl, pcb-connectivity-check.json, pcb-drc-summary.json, pcb-layout.json, pcb-placement.csv, pcb-readback.json, rear_cover.stl, rear_cover_pilot.stl]
2026-10-26 hardware: 闭合中控SPI连接并记录母线局部避让
    [body.stl, pcb-connectivity-check.json, pcb-drc-summary.json, pcb-layout.json, pcb-placement.csv, pcb-readback.json, rear_cover.stl, rear_cover_pilot.stl]
2026-10-26 hardware: 补齐12V钳位支路和右前探头输出
    [pcb-connectivity-check.json, pcb-drc-summary.json, pcb-readback.json, six-port-baseboard-v01.epro]
2026-10-26 hardware: 增加左前维护USB源端及DNP调试预留
    [body.stl, pcb-connectivity-check.json, pcb-drc-summary.json, pcb-layout.json, pcb-placement.csv, pcb-readback.json, pinmap.csv, rear_cover.stl]
2026-10-26 hardware: 完成左前维护USB差分布线与原生审查
    [body.stl, pcb-connectivity-check.json, pcb-drc-summary.json, pcb-layout.json, pcb-placement.csv, pcb-readback.json, rear_cover.stl, rear_cover_pilot.stl]
2026-10-26 hardware: 增加右前USB预留并调整源端布局
    [body.stl, pcb-connectivity-check.json, pcb-drc-summary.json, pcb-layout.json, pcb-placement.csv, pcb-readback.json, pinmap.csv, rear_cover.stl]
2026-10-26 hardware: 完成右前USB近端差分布线并清理旧维护分支
    [body.stl, pcb-connectivity-check.json, pcb-drc-summary.json, pcb-layout.json, pcb-placement.csv, pcb-readback.json, rear_cover.stl, rear_cover_pilot.stl]
2026-10-27 hardware: 完成左后USB接口及近端差分布线
    [pcb-connectivity-check.json, pcb-drc-summary.json, pcb-layout.json, pcb-placement.csv, pcb-readback.json, pinmap.csv, schematic-drc.json, schematic-model.json]
2026-10-27 hardware: 增加底面元件与外壳支柱装配检查
    [central_case.scad]
